noahzhy/cc_glasses/hardware/ir_glasses/ir_glasses_EVT_E7/review/3d/EVT_E7_bottom.png

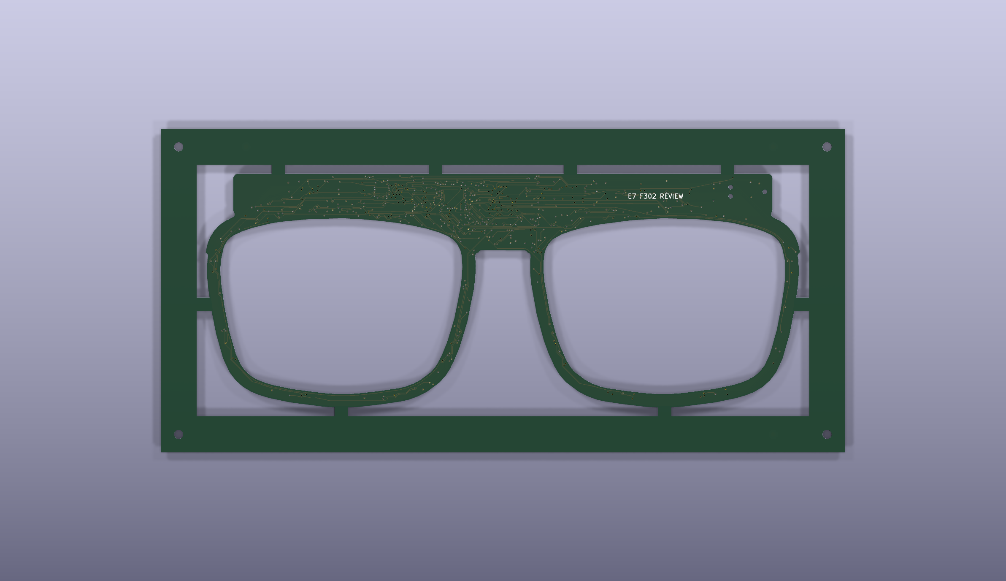
hardware/ir_glasses/ir_glasses_EVT_E7/review/3d/EVT_E7_bottom.png
