noahzhy/cc_glasses/hardware/ir_glasses/EVT_E3/pcb_back.png

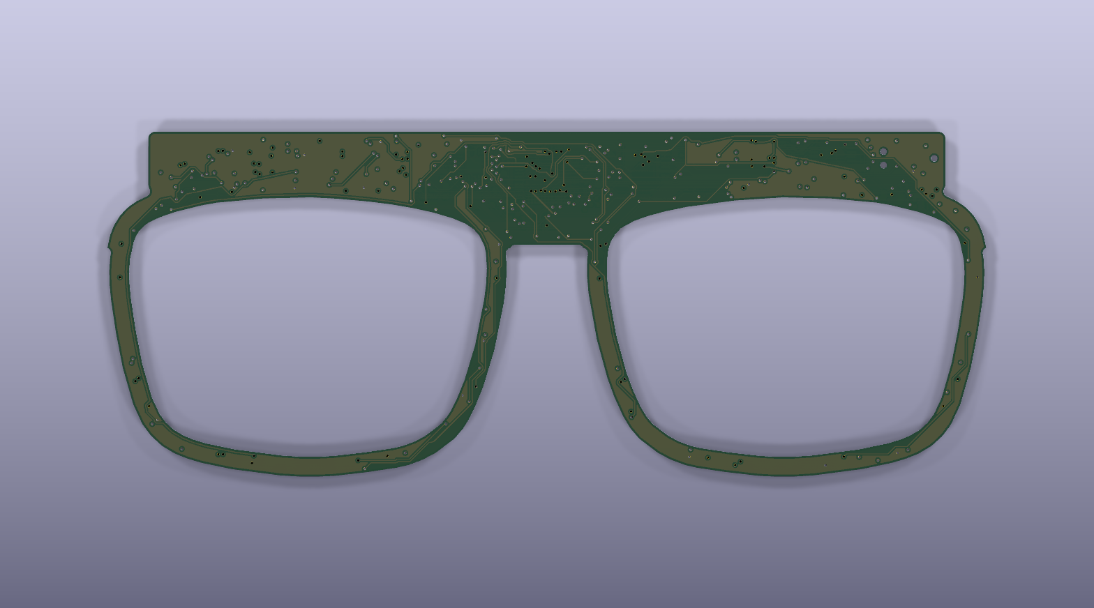
hardware/ir_glasses/EVT_E3/pcb_back.png
