noahzhy/cc_glasses/hardware/ir_glasses/EVT_E3/carrier_design.md

# EVT E3 单板可拆贴片载框

载框用于 5 块 PCB 制作，其中 2 块正面贴片。每个载框只含 1 副眼镜板，元器件及铜箔坐标与裸板相同。此文件是待工厂确认的加工方案，尚未取得工厂 DFM 或专用分板治具报价。

## 尺寸与加工定义

| 项目 | 定义 |
| --- | --- |
| 裸板外包络 | 132.305 × 51.955 mm，以最终裸板 Edge.Cuts 为准 |
| 载框外包络 | 152.305 × 71.955 mm |
| 外框坐标 | X 33.849412～186.154557；Y 47.000000～118.955477 mm |
| 工艺边 | 四周连续 8.0 mm，裸板最大外包络至工艺边内侧至少 2.0 mm |
| 材料 | 四层 FR-4、厚 1.6 mm、沉金，正面贴装 |
| 定位孔 | 四角各 1 个直径 2.0 mm 非金属化孔，中心距相邻外边各 4.0 mm |
| 光学定位点 | 3 个不对称分布的正面 Mark，铜径 1.0 mm、阻焊开窗径 2.0 mm，不开锡膏 |
| 光学点边距 | 中心距最近外边 4.0 mm，满足公开规则的至少 3.85 mm |
| 连接桥 | 8 个实心桥，名义宽 3.0 mm；上沿 4 个、两侧各 1 个、下沿各 1 个 |
| 铣槽 | 闭合 Edge.Cuts 切口；保留连接桥，包含双眼开孔 |
| 最终分板 | 治具支撑后铣断连接桥，按裸板原始轮廓精修；不使用 V-cut 或手工折断 |

采用实心桥是为了让窄镜框在运输和回流焊时得到支撑，并避免邮票孔折断后的毛刺、应力和残留凸起。四条边框夹持位置连续；定位孔、Mark 均位于独立废边，不计入器件 BOM 或贴片数量。默认 5 块均由工厂去框交付，其中 2 块在贴装和检验后去框，另 3 块不贴装。

参考嘉立创[工艺加工能力](https://www.jlc.com/portal/vtechnology.html)及[定位孔、Mark 规则](https://www.jlc.com/portal/server_guide_14565.html)：公开页面给出 SMT 工艺边至少 5 mm、1 mm 光点、2 mm 定位孔，光点中心到板边至少 3.85 mm。本方案采用 8 mm 工艺边及 4 mm 光点边距。

## 连接桥及分板图

`carrier/carrier_review.svg` 中灰色为载框、绿色为成品镜框、橙色为连接桥，红色为贴装后的最终铣断路径。`carrier/carrier_geometry.json` 保存全部绝对毫米坐标。红色路径仅作为加工说明位于 `Dwgs.User`，不混入初次铣槽的 Edge.Cuts。

上方四桥位于 X = 60、95、125、160 mm；两侧桥位于 Y = 84.5～87.5 mm；下方桥位于 X = 72.5～75.5 和 144.5～147.5 mm。桥位需随最终板上铜箔与封装检查结果验收；不得在桥内增加电连接。载框不新增覆铜，原有电路铜箔保持在成品范围内。每条最终铣断路径设有四层覆铜禁布区，向成品内侧保留至少 0.30 mm，防止改用载框外形后重新铺铜延伸到未来切口。禁布区只约束覆铜，原有走线和焊盘保持不动。

工厂需用下支撑治具承托两个镜框和上方电子区，避免吸附或夹持在 PD／IR-LED 上；先完成贴装和检验，再逐桥铣断，最后保留靠近上方电子区的桥作为定位。刀具半径补偿向废料侧进行，最终成品轮廓以裸板文件为准。不得为去桥扩大眼部开孔或削薄 3 mm 镜框。弯曲镜框、手折、斜口钳剪桥均不属于本加工方案。

## 文件对应及交接

- 裸板文件用于最终产品尺寸及对照；`carrier/ir_glasses_carrier.kicad_pcb` 是带载框加工版本，初次生产须选择其对应 Gerber／钻孔，不能混用裸板外形。
- 载框保留原有板坐标、辅助原点、器件位号、旋转角和网络。贴片坐标中应只有同样的 142 个正面器件；额外 4 个定位孔和 3 个 Mark 不进入 BOM/CPL。
- 工厂需确认：异形板治具支撑、铣断顺序、刀具及轮廓公差、沉金与四层叠层，以及 5 块均去框、其中 2 块贴装的加工和报价范围。
- 完成机器 DRC 和坐标一致性校验后可作为报价／DFM 输入；工厂未书面确认前，不将治具可用性或机械强度标为通过。

## 验收状态

以本版 carrier_validation.json、DRC 和 CAM 检查记录为准。工厂 DFM、支撑治具及分板工艺尚待确认。
