noahzhy/cc_glasses/hardware/ir_glasses/deliverables/EVT_E7_生产交付_20260920/交付说明.txt

EVT E7 生产交付文件 — 2026-09-20

PCB/：四层 Gerber、阻焊、丝印、板框、PTH/NPTH 钻孔；直接上传此目录内容生成的 PCB_Gerber.zip 打板，不需要先导入嘉立创 EDA。
SMT/：BOM_JLC.csv 与 CPL_JLC.csv 用于贴片导入；中文 BOM 汇总含参数和立创编码；F_Paste.gtp 为正面钢网。153 个贴装器件，39 种料号，全部正面装配。

层序：F.Cu / In1.Cu(GND) / In2.Cu(3V3) / B.Cu。4 层 FR-4，成品厚度 1.6 mm，外层铜 1 oz。具体内层铜厚及介质厚度由工厂按原工程叠层确认，不指定阻抗控制。
过孔最小钻径 0.20 mm，外径最小 0.40 mm，双面盖油。最小线宽/间距 0.10 mm；铜到板边最小 0.30 mm。不得擅自放大过孔破坏间距。
保留完整 carrier、连接桥、定位孔和槽；以 Edge_Cuts 板框铣槽，不自动添加 V-cut。基板约 132.305×51.955 mm，含 carrier 约 152.305×71.955 mm，以文件轮廓为准。
Gerber、钻孔与贴片坐标采用相同钻孔/贴装原点，单位 mm。CPL 旋转为 KiCad 原生定义，工厂必须结合装配图核对引脚1、二极管/光学器件极性及连接器方向。
J2 为免焊调试触点，测试点和基准点不采购、不贴装。不得未经审核替换物料。

当前源工程 ERC/DRC 为零违规、零未连接、零原理图一致性问题。该结果属于静态检查，不代表首板实测或量产放行。
本包可交工厂进行 DFM 和首板准备；首板测试表仍待完成。阻焊颜色、表面处理、数量及具体工艺由订单另行明确。库存、贴片零度、钢网与加工公差由工厂确认后执行。
源 PCB SHA256：b72c8b3da89e97aaa6524084c4803fd5dfc168ff17fab4a67eadd32514efd5d1
