noahzhy/cc_glasses/hardware/ir_glasses/ir_glasses_EVT_E7/review/report.md

# EVT E7 电路复核与精简记录

E7 沿用 F302 R3 原理图、四层 1.6 mm 基板及既有光学/机械边界。所有电气元器件位于正面。载框属于唯一 PCB 文件，不是另一套电路工程。本文的计算是静态设计检查，不是整板实测结论；布线验收以 `validation.json` 和原生 DRC 为准。

## 保护架构复核

保留 U18 TPS2553DRVR。R29=110 kΩ，按厂商公式并计入 1% 电阻公差，限流下限/典型/上限约为 210.6/242.6/279.6 mA，覆盖原有约 150 mA 工作峰值预算。U14 的最低可设置限流约 0.5 A，不能等效替代 U18。[TPS2553 §9.5](https://www.ti.com/lit/ds/symlink/tps2553.pdf)

保留 U14 TPS259470ARPWR：承担软启动、后级保护及反向电流阻断。R20=6.2 kΩ、C38=22 nF、ITIMER 悬空保持。评估过删除 U19，但 U14 OVLO 上升阈值为 1.183–1.223 V，下降阈值为 1.076–1.116 V；若典型关断设 3.50 V，典型恢复约为 3.18 V，会在输入恢复 3.3 V 后仍保持关断。不能保持原故障恢复行为，因此不删除 U19。[TPS25947 表 6-5、6-6](https://www.ti.com/lit/ds/symlink/tps25947.pdf)

U19 TPS3702CX33DDCR 的 SET 接高、OV 输出驱动 U14 EN。R18/R19=200 Ω/10 kΩ；计入 ±0.9% 检测误差、1% 分压电阻及 SENSE 电流，输入过压关断约为 3.469–3.533 V。正常输入 3.3 V ±3% 的上限为 3.399 V，静态阈值具有间隔。检测器启动时间、输入瞬态过冲和关断过程仍需实测。U18 位于 U14 前面，整机不能宣称具有 U14 单芯片的宽输入耐压能力。[TPS3702 §5、6.3、6.4](https://www.ti.com/lit/ds/symlink/tps3702.pdf)

## 采集、驱动及接口复核

- U1 的 R1=2.67 kΩ，典型通道电流约 19.82 mA；BLANK 上拉保持失控趋向灭灯。U12 的 A=0、B=1，CLR 上升触发、低电平清除；R15 和 C33/C34 的连接符合定时网络。两颗 1 nF 定时电容保留，避免在没有全温度脉宽验证前改变硬件窗口。[TLC59283](https://www.ti.com/lit/ds/symlink/tlc59283.pdf)、[SN74LVC1G123](https://www.ti.com/lit/ds/symlink/sn74lvc1g123.pdf)
- 16 路 TIA 保留 100 kΩ/22 pF 反馈；理想反馈极点约 72.34 kHz。对 5/10 MHz 单极点运放、20–100 pF 总输入电容、反馈电容 ±5% 的敏感度筛查，最慢进入 0.5 LSB 相对稳态误差约 20.72 µs，小于 50 µs 亮态等待。该模型不包含器件高阶极点、实际 PD/走线寄生或饱和恢复，不能代替真实稳定性、噪声和建立时间测试。计算明细见 `circuit_calculations.json`。[TLV906x](https://www.ti.com/lit/ds/symlink/tlv9062.pdf)
- U7/U8 的通道、地址、低有效 EN 与奇偶 TIA 映射重新核对。U16 保持双路单位增益跟随器，反馈在 100 Ω 前取样，330 pF 在 ADC 端；不能把该 RC 当作完整建立时间。[TMUX1308](https://www.ti.com/lit/ds/symlink/tmux1308.pdf)
- U9 的 VDDA/VDD 同接 3V3，保留 C11=10 nF、C47=1 µF。四个数字/备份供电去耦和 C40=10 µF 储能保留。ADC 获取期 5.125 µs、总转换期约 6.167 µs；双 ADC 配置及固件引脚契约不变。[ST DS9911 Rev 9](https://www.st.com/resource/en/datasheet/stm32f302rb.pdf)
- 复核 MCU 48 脚、IMU 供电与 I2C 模式、UART/SWD/NRST 接口、ESD 极性及 LED/PD 引脚。IMU 的 SDx/SCx 接地符合 Mode 1；D18/D19 仍为 1=K、2=A。采购型号、封装及保留器件参数不变。[LSM6DS3TR-C 表 18](https://www.st.com/resource/en/datasheet/lsm6ds3tr-c.pdf)、[PESD3V3U1UB](https://assets.nexperia.com/documents/data-sheet/PESD3V3U1UB.pdf)

## 已实施精简

| 位号 | 原功能 | E7 处理与依据 |
|---|---|---|
| C24 | MCU 区额外 1 µF | 删除；保留各引脚 100 nF、C19=1 µF、C40=10 µF 及独立 VDDA 去耦。最终电源纹波需首板确认。 |
| C45 | MCU 区额外 100 nF | 删除；不替代或删除对应供电脚的 C10/C12/C13/C14。 |
| TP5/TP6 | UART_TX/UART_RX 重复测试点 | 删除；相同网络保留 TP3/TP4，接口与调试能力不变。 |

电气器件 168→164，采购 BOM 器件 155→153。无新增 IC、无器件改值、无保留引脚改网；位号不重新编号。相对于 E6 旧 PCB，U9/9、C11/1、C47/1 的供电整改已同步到 E7 焊盘网络；旧 PCB 网表不作为原理图真值。

## PCB 和验收边界

旧走线、过孔、铜区填充全部清除，按新原理图从零布线。保留机械轮廓、连接桥、定位孔、基准点、32 个光学器件及外部接口的坐标和方向。元器件统一正面，最多四层；In1.Cu 为地参考面，功能走线不延伸到 carrier。

首板仍需验证限流和过压动作、异常输入恢复、上电先后与偏置等待、LED 最大脉宽、CPU 停机灭灯、MUX 满幅切换、ADC 建立/串扰/噪声。`first_board_tests.csv` 保留并补充这些项目。本工程为设计评审交付，不包含生产发布包。

## 当前验收结果：静态设计通过

- 单一工程、单张 A1 原理图、单一含 carrier 的 PCB 已建立。
- 四层、1.6 mm；164 个电气器件全部位于 F.Cu，522 个保留引脚的网络一致；原始轮廓、固定位置和 E6 基线哈希未改变。
- ERC、PCB DRC：均为 0 错误、0 警告；未连接及原理图一致性问题均为 0。`remaining_connections.csv` 和 `warning_review.csv` 仅保留表头；没有豁免或关闭检查。
- 568 个实际过孔均为通孔，孔径至少 0.20 mm、外径至少 0.40 mm、单边环宽至少 0.10 mm。工程及默认孔径限制同步更新，未使用微孔。孔边到 SMD 焊盘的最小距离为 0.103838 mm。
- In1.Cu 以 GND 为参考，局部数字连接避开模拟铜的投影，最小投影铜间隔为 0.304039 mm。填充后的地铜保持一个连通区域；功能走线和过孔均在基板内。
- 已完成 LED_SIN、NRST_EXT 连接，重布邻近 TIA6、TIA8、MUX_B 并补齐 3V3 铜区连接；清理多余线头和无用过孔。此轮收尾未增加器件、未改网、未移动固定器件。
- 六页 PCB 预览包含四个铜层、正面装配层和丝印层，页眉记录当前 PCB 哈希。已检查整板以及模拟、控制、保护区域放大图；详见 `visual_checks.md`。

`validation.json` 为 `passed`，适用范围为静态设计检查。首板测试尚未实施，板厂 DFM 尚未完成，没有发布生产制造包。量产放行仍需完成 `first_board_tests.csv` 中的实测项目，尤其是保护动作、硬件灭灯、模拟稳定性与建立时间、光安全。
