noahzhy/cc_glasses/hardware/ir_glasses/ir_glasses_EVT_E7/review/visual_checks.md

# PCB 视觉复核

检查对象：`pcb_layers.pdf`，以及 `previews/` 中的原生 SVG 和放大图。
PCB SHA256：`b72c8b3da89e97aaa6524084c4803fd5dfc168ff17fab4a67eadd32514efd5d1`。

- 整板：四个铜层、正面装配和丝印预览共六页；载框、连接桥、定位孔及基准点保留，功能走线留在基板内。
- 模拟区：检查运放附近反馈阻容、MUX/ADC 缓冲、去耦和焊盘扇出；放大图为 `analogue_copper.png`、`analogue_assembly.png`。
- 控制区：检查 MCU、LED 驱动和关断逻辑的焊盘、过孔与装配间距；清除悬空线头和无用过孔，修正过孔接线。参见 `control_copper.png`、`control_assembly.png`。
- 回流：检查 In1 整体及控制区放大图。几何检查确认地铜为一个连通区域，In1 数字铜与模拟铜的投影间距至少 0.304039 mm。
- 保护及板边：检查输入保护区、接口、光学边缘和载框分板区域；原生 DRC 的铜到板边检查通过。
- 可读性：装配及丝印页采用黑白高对比导出；位号以矢量 PDF 放大查看。预览页眉记录当前 PCB 哈希。
- 装配位号修正：D17/D18 的位号移出相邻器件区域，D17/D18/D19 使用统一字号的可编辑 F.Fab 位号字段；未改变任何焊盘或电气连接。

视觉及静态检查不替代首板电气实测、光安全测量或板厂 DFM。所有首板测试仍标记为 PENDING。
