noahzhy/cc_glasses/hardware/ir_glasses/ir_glasses_EVT_E7/models/README_E6.md

U16/U17 使用 KiCad 10 官方 VSSOP-8 STEP 模型。U15 使用按 AD7386 CP-16-45 标称尺寸生成的简化外观模型（3×3 mm、0.75 mm 本体、0.5 mm 引脚间距、1.1 mm 裸露焊盘），仅用于装配示意。制造焊盘以 PCB/Gerber 为准。其余模型沿用 E4。

J1采用GUOCONN厂家图纸的简化尺寸模型，壳体和锁扣外观仅作示意；原TE模型已不再绑定J1。
