noahzhy/cc_glasses/hardware/ir_glasses/ir_glasses_EVT_E7/review/preproduction/report.md

# EVT E7 量产前复核 — 2026-09-19

本轮静态检查通过。尚未完成首板实测及工厂 DFM／贴片工程确认，不能据此认定已获量产放行。

## 本轮实际检查

| 项目 | 结果 |
|---|---|
| 原生 KiCad ERC | 0 错误、0 警告，无忽略项 |
| 原生 KiCad DRC、原理图一致性 | 0 违规、0 未连接、0 一致性问题，无忽略项 |
| 重新导出网表 | 与当前受审网表 522 个位号—引脚—网络一致 |
| E6 基线对比 | 保留器件连接无变化，仅移除已记录的 C24、C45、TP5、TP6；历史文件未改变 |
| 单板结构 | 一个带 carrier 的 PCB；4 层、1.6 mm；164 个电气封装均在正面 |
| 过孔 | 568 个通孔，最小孔径 0.20 mm、最小单边环宽 0.10 mm |
| 机械与固定器件 | 轮廓、光学器件、接口、定位孔位置和方向与基线一致 |
| 几何复核 | 地铜一个连通区域；走线未越出基板；孔边到焊盘最小 0.10384 mm；内层数字线与模拟铜投影间距最小 0.30404 mm |
| BOM | 153 个装配器件、39 种采购料号；无重复位号、缺失型号或缺失立创编码 |
| 贴装坐标 | 153 行与 BOM 一一对应；坐标、旋转、正面属性与当前 PCB 原生读取结果一致 |

本轮未改动电路、封装或布线。PCB SHA-256：`b72c8b3da89e97aaa6524084c4803fd5dfc168ff17fab4a67eadd32514efd5d1`。

## BOM 交付与依据

- 工程根目录 `BOM.csv`：逐位号明细，新增简要参数和商品链接，保留型号、制造商、封装、数量及 LCSC 编码。
- 工程根目录 `BOM_采购汇总.csv`：中文列名、同料号合并，包含单板数量、全部位号、简要参数、封装、制造商、型号、立创商城编码和商品链接。
- 电容参数含容量、耐压、介质及公差；电阻含阻值、公差和功率；连接器注明 5P、0.5 mm 间距、上接触和适配 0.3 mm 排线。
- 39 种编码与 2026-09-18 归档的立创商城商品型号逐项相符；相关摘要保存在 `../bom_catalog.json`。这是料号映射依据，不代表当前库存或嘉立创贴片可用性。
- 三环 1 µF 电容的编码及型号另经[立创商品页面](https://item.szlcsc.com/51619650.html)交叉查询；光电二极管简要参数参照[亿光 PD15-21B/TR8 数据手册](https://en.everlight.com/wp-content/plugins/ItemRelationship/product_files/pdf/PD15-21B-TR8.pdf)。本轮未宣称重新逐页审核全部厂商数据手册。
- J2 为 TC2050 免焊调试触点，不是待焊连接器；TP1–TP4、TP7–TP12 共 10 个测试点也不采购。调试探针／转接工具按生产工装另行准备，不计入单板 BOM。
- 汇总数量为每板净用量，不含贴片损耗、最小包装或采购余量。不能用商城编码推断当前基础库／扩展库属性。

原 BOM 保存在 `BOM_before.csv`，检查确认原有位号、数量、型号、制造商、封装和编码均未改变。`result.json` 保存本轮结果和交付文件哈希；`erc.json`、`drc.json` 为本轮重新运行结果。

## 放行前仍需完成

1. `../../first_board_tests.csv` 中 25 项首板测试仍为 PENDING，包括保护动作与恢复、采集稳定性、数字串扰、LED 硬件关断和光辐射安全验证。本轮没有实物测试数据。
2. 工厂确认四层叠层、孔径能力、阻焊与过孔盖油、钢网、器件极性／贴片零度及 carrier 分板 DFM；静态规则通过不能替代工厂确认。
3. 下单时确认 39 种物料的实时库存、批次、供货周期、贴片库可用性及采购余量。不得无审核替换型号。

本轮结果是设计文件和 BOM 的静态复核通过，未下单、未发布新的生产制造包。
