noahzhy/cc_glasses/docs/3D打印参数.md

# 3D 打印参数

## 打印参数
对于 PETG Matte 材料 3D 打印机的打印参数，主要包括以下几个方面：
- 打印速度调整到默认
- 开启 0.12 mm 高质量打印
- 线宽默认设置成 0.6 mm
  - 外墙设置成 0.6 mm
- 关闭[圆弧拟合](https://wiki.bambulab.com/zh/software/bambu-studio/acr-move)
