noahzhy/cc_glasses/docs/IR-LED选型.md

| 型号 | IR26-21C | IR26-61C | IR25-21C | IR11-21C/L491 | IR15-21C |
| --- | --- | --- | --- | --- | --- |
| **出光方式** | Top View，垂直 PCB 出光 | Side View，平行 PCB 出光 | Top View，垂直 PCB 出光 | Top View，垂直 PCB 出光 | Top View，垂直 PCB 出光 |
| **封装特点** | 正面透镜出光 | 侧出光，封装紧凑 | 超薄、宽角度出光 | 中等高度、宽角度透镜 | 超薄、宽角度出光 |
| **典型适用 PCB** | PCB/FPC 朝向眼睛 | PCB/FPC 沿镜框平铺 | PCB/FPC 朝向眼睛 | PCB/FPC 朝向眼睛 | PCB/FPC 朝向眼睛 |
| **光轴调整方式** | 通过倾斜 PCB/FPC 调整 | 通过 PCB 朝向和结构调整 | 对安装角度不敏感 | 可直接覆盖眼区，必要时小角度倾斜 | 对安装角度不敏感 |
| **发光角** | **20°~25°**（取决于具体后缀） | **20°**（L302） | **160°** | **80°**（L491） | **160°** |
| **光强** | 取决于具体后缀，L447 有较高光强版本 | L302 等版本具有较高定向光强 | 单位立体角光强较低，主要靠大范围覆盖 | 中等，兼顾覆盖范围与有效光强 | 相对较低 |
| **空间选择性** | **很高**，适合针对局部区域照射 | **很高**，适合定向照射 | 低，容易同时照亮整个眼区 | **中等，比较均衡** | 低 |
| **安装容错** | 较低，需要光轴基本对准目标 | 较低，需要镜框结构配合 | **很高** | **较高** | **很高** |
| **杂散反射风险** | 低 | 低 | **较高**，容易照到镜片、鼻梁、皮肤 | **中等** | **较高** |
| **主要优势** | 窄束、高空间选择性，适合最终优化 | 小尺寸 + Side View + 定向性强 | 超薄 + 超宽角，容易照到眼睛 | **覆盖范围、方向容错和空间选择性的平衡最好** | 超薄、覆盖范围非常大 |
| **主要限制** | PCB 平铺时可能打不到眼球，需要倾角  | Side View 必须配合特定镜框结构 | 160° 太宽，多通道空间差异容易下降 | 相比 IR26 定向性弱一些 | 光强和空间选择性均不突出 |
| **推荐场景** | LED/PCB 可以精确指向眼球的优化版本  | PCB 沿镜框内壁/侧壁安装、追求隐藏式结构 | Presence / 大范围反射检测 | **初版 near/far 原理验证，推荐** | 简单大范围红外照明，不优先用于当前方案 |
