noahzhy/cc_glasses/hardware/ir_glasses/EVT_E3/mechanical_dimensions.pdf

132.305 mm

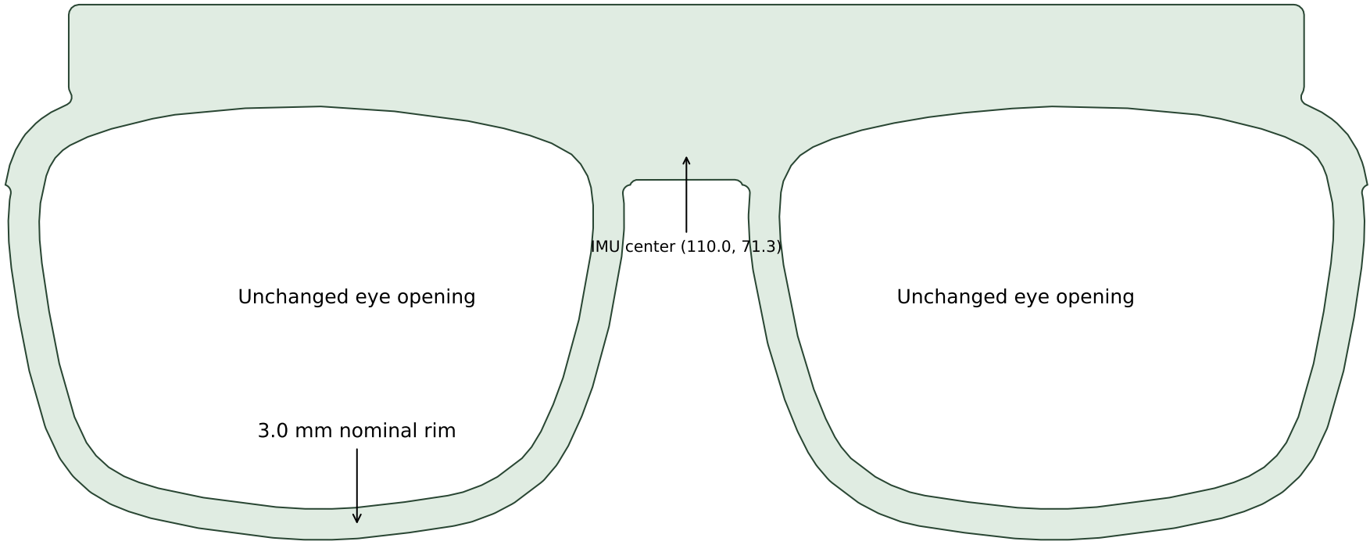
[picture p3: figure]
Unchanged eye opening; 3.0 mm nominal rim; IMU center (110.0, 71.3)

51.955 mm

## EVT E3 | FINISHED BOARD DIMENSIONS | mm | TOP VIEW

4-layer FR-4 / nominal 1.6 mm / ENIG / front assembly only.
Rim: 3.0 mm nominal on sides and lower edges. No routing-driven local widening; upper transitions R0.8 mm.
Straight upper edge: previous 1.5 mm power pocket removed. Dimensions refer to Edge.Cuts centerlines; this PDF is not to scale. Carrier and depanel details: carrier/carrier_review.svg and carrier_design.md. Factory DFM remains pending.
