noahzhy/cc_glasses/hardware/ir_glasses/reviews/EVT_E6_P3_crosscheck_20260917/report.md

# EVT E6 P3 再次交叉检查

日期：2026-09-17。对象：当前工作目录与已发布P3 ZIP。结论：本次未发现新的接线、封装映射、光学坐标或生产包内容不一致问题；典型模型计算可复现。此结论不等于量产放行，现有30项首板测试仍待完成。

## 本次重新执行的验证

- KiCad 10.0.6：重新导出原理图网络表；ERC为0；主板重新铺铜后DRC违规/未连接/原理图不一致均0；载框重新铺铜后DRC违规/未连接均0。未保存或改变生产PCB。
- 新网络表与实际PCB焊盘交叉核对U16/U17双跟随器：1/2为第一级输出反馈，3为MUX输入，4为GND，5为分压输入，6/7为第二级输出反馈，8为3V3_A；R11/R12在反馈环外，分别连接DRIVE_A/B至ADC_A/B；C29/C30分别从ADC_A/B到GND。BOM为TLV9062IDGKR、100Ω、330pF。
- 从Git历史读取E4基线到独立检查目录，确认其PCB SHA256与E6的source_hashes记录相符。实际E4/E6 PCB中16颗LED与16颗PD的位置与旋转逐一相同。
- 重新运行ngspice：相对容差从1e-5加严到1e-6，环路频率网格从120加密至480点/十倍频，瞬态最大步长从2ns缩短到0.5ns，噪声频率网格从150加密至300点/十倍频。100Ω典型相位裕量57.9925°；0.15→3.1V大阶跃上/下沿半LSB建立均约1.1151µs；两级缓冲/分压/RC局部噪声36.4596µV RMS，与发布报告一致。这是数值收敛交叉检查，仍使用同一原厂典型模型，并非独立器件模型或实测。
- 403项发布清单文件哈希全部匹配；完整工程ZIP中的对应文件逐项匹配；完整ZIP、包内载框上传ZIP和SMT交付ZIP均通过CRC检查。
- 查阅AD7386 Rev.A第27–28页：一次转换读回延迟、单线32时钟、A后B的次序与接口文档一致。现有24µs CS低窗口容纳3MHz的32时钟（10.667µs）；背景到亮灯的CS高间隔126µs满足板级5µs调试下限。16×1250µs=20ms，时序预算对应50帧/秒；不表示固件已运行验证。

## 量产前仍未闭环的事项

1. **真实光电链路未验证。** 1.115µs只覆盖缓冲链路；此前25.54µs是理想100kΩ/22pF单极点近似，不能替代真实PD电容、TIA噪声增益、MUX切换和饱和恢复验证。50µs亮灯等待/100µs切换等待继续作为调试基线，按T10/T28/T29实测。
2. **噪声没有系统验收门限。** 36.46µV不是整机噪声上限。约2.29码RMS暗亮差分只是局部链路与ADC典型SNR的粗略合成，未包含真实PD/TIA及LED/电源串扰。算法必须给出允许噪声或最小可检测信号，按T11/T30验收。16位输出不代表16位有效精度或绝对精度。
3. **参考启动、供电及安全时序仍待首板。** 20ms只是参考启动调试起点；主机3.3V±3%为设计条件，实际线缆压降、ADC处供电、热插拔、保护恢复、CPU停机灭灯和连续50帧/秒需完成原有测试清单。

以上均为已存在的验证边界，本次未把它们改写为通过。无需仅依据本次结果继续更换运放或RC。

## 文件位置与交付说明

当前顶层ir_glasses_EVT_E6_JLC_upload.zip不存在，但ir_glasses_EVT_E6/carrier/JLC_upload.zip存在且校验通过；完整工程ZIP内也包含该文件。可使用包内载框上传包，不能沿用旧顶层链接。未重新创建可能由用户整理移除的副本。

当前E4工作目录不存在；本次使用哈希匹配的Git历史基线完成只读对比，未恢复或覆盖用户工作区文件。旧包是否另行备份不在本次已证实范围内。

本报告独立保存，未修改现有生产包、BOM或PCB。具体机器结果见results.json；原始ERC/DRC、导出网络表及加严仿真证据位于工作区.e6_work/p3_crosscheck/。

PCB SHA256：545f4575b7eea053c0235e3fe1aa631ae973b5b51f7525a373fa09242c1da147。

原厂参考：[AD7386 Rev.A](https://www.analog.com/media/en/technical-documentation/data-sheets/ad7386-7387-7388.pdf)、[TI TLV9062](https://www.ti.com/lit/gpn/TLV9062)。
