noahzhy/cc_glasses/assets/blender/topview_outline.png

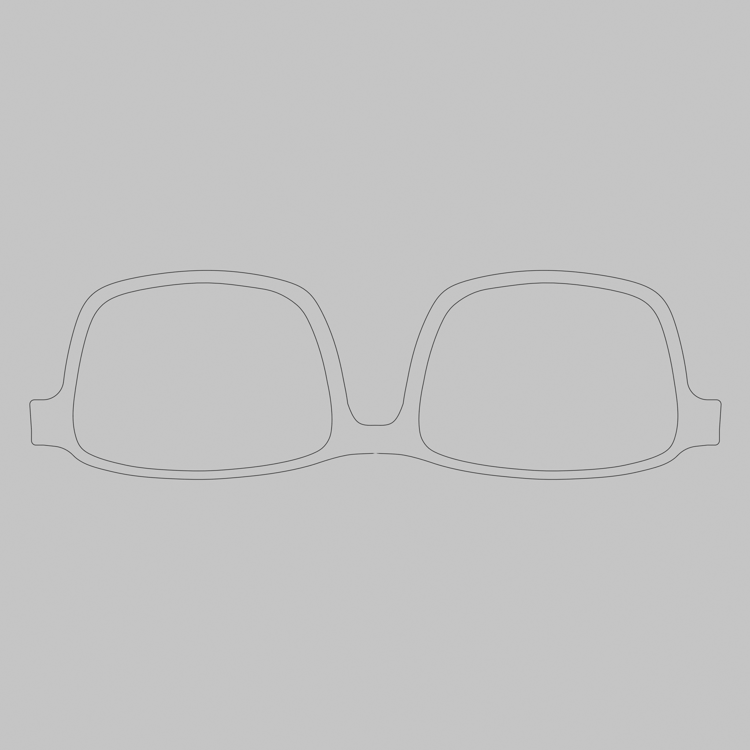
assets/blender/topview_outline.png
