noahzhy/cc_glasses/assets/images/total.png

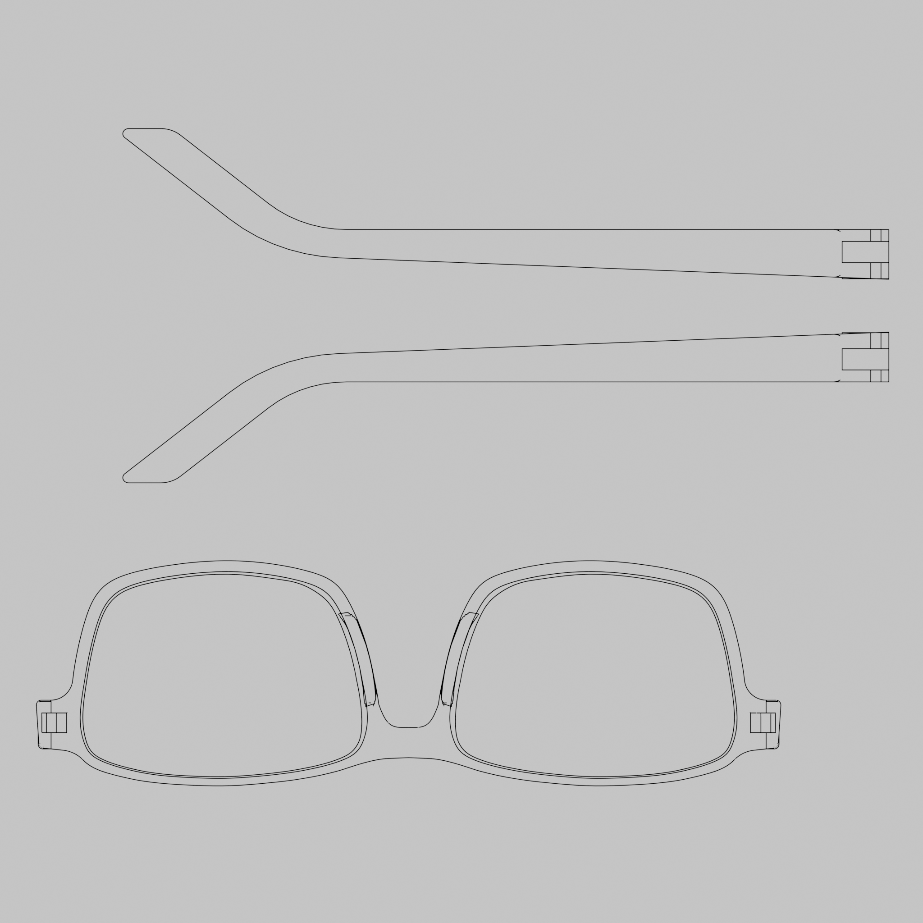
assets/images/total.png
