noahzhy/cc_glasses/hardware/ir_glasses/EVT_E3/carrier/carrier_review.png

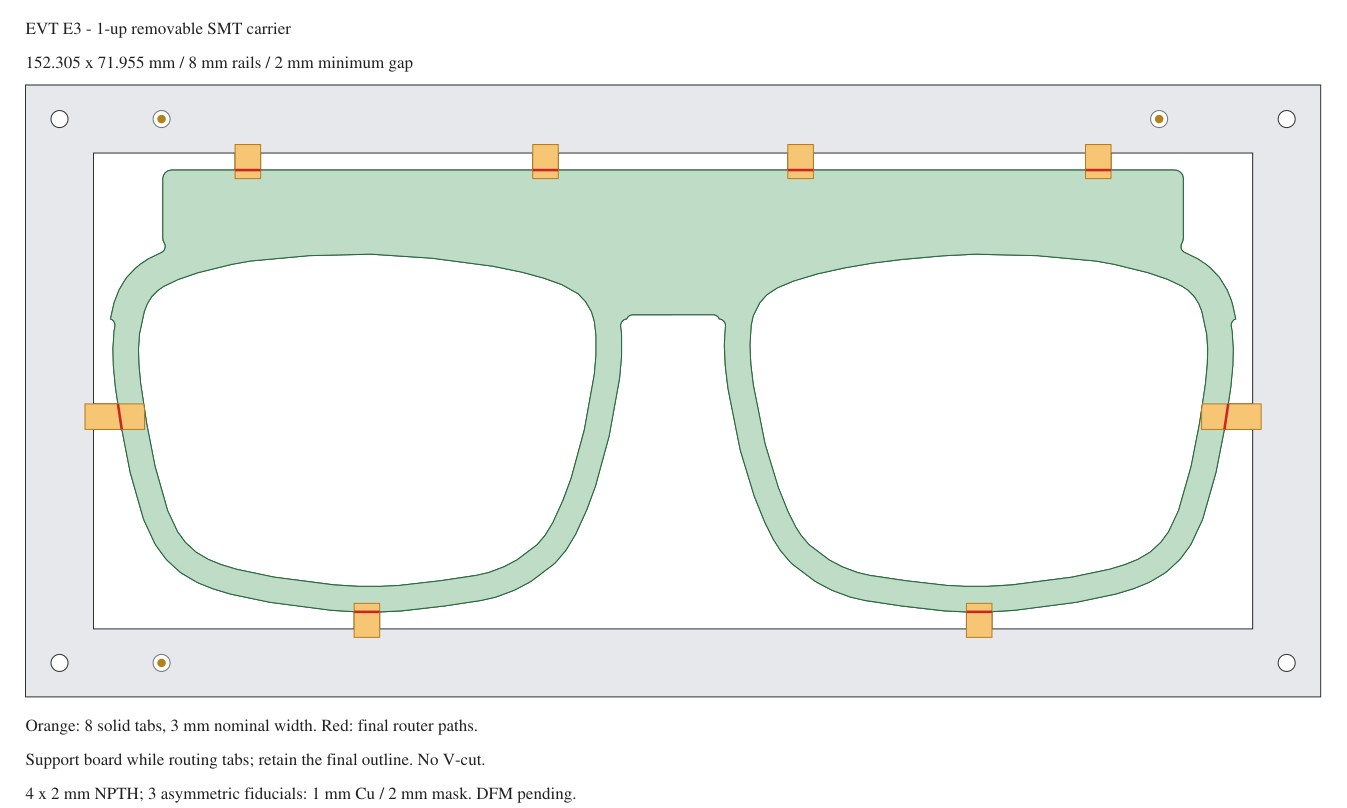
hardware/ir_glasses/EVT_E3/carrier/carrier_review.png
