noahzhy/cc_glasses/hardware/ir_glasses/EVT_E3/pcb_routed.png

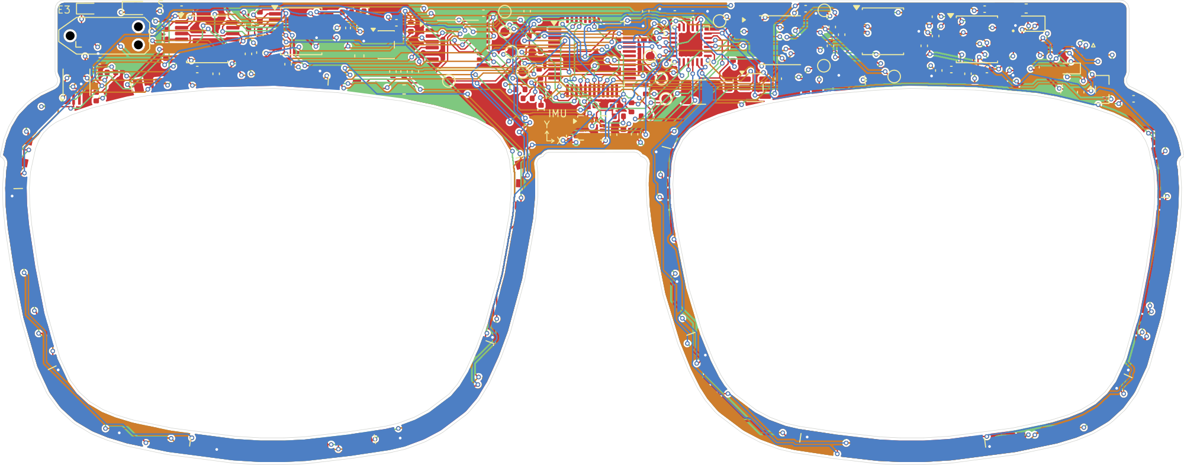
hardware/ir_glasses/EVT_E3/pcb_routed.png
