noahzhy/cc_glasses/hardware/ir_glasses/ir_glasses_EVT_E7/review/3d/EVT_E7_angle.png

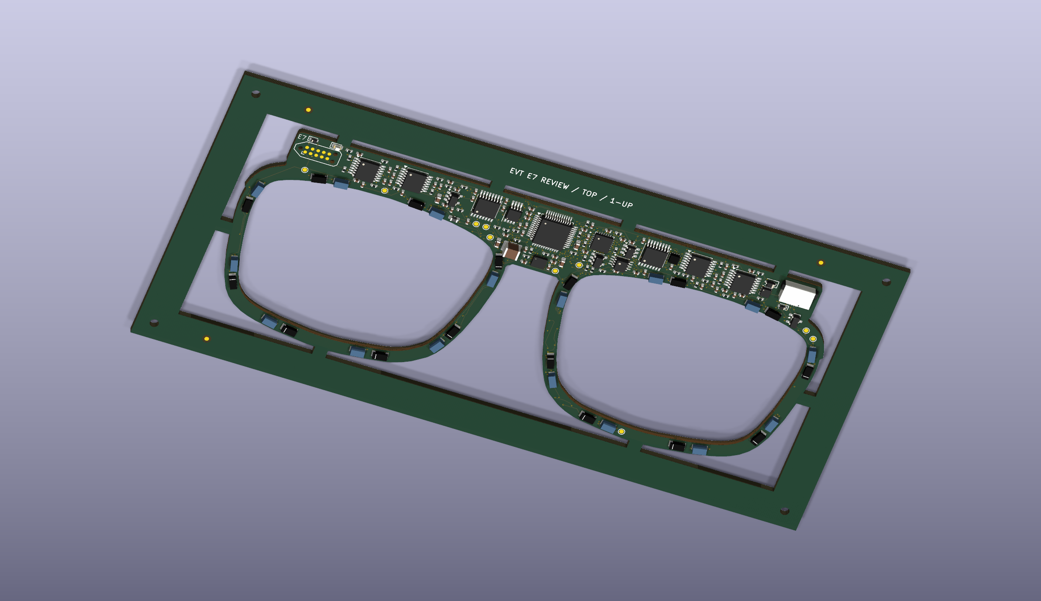
hardware/ir_glasses/ir_glasses_EVT_E7/review/3d/EVT_E7_angle.png
