noahzhy/cc_glasses/hardware/ir_glasses/ir_glasses_EVT_E7/review/previews/analogue_ground.png

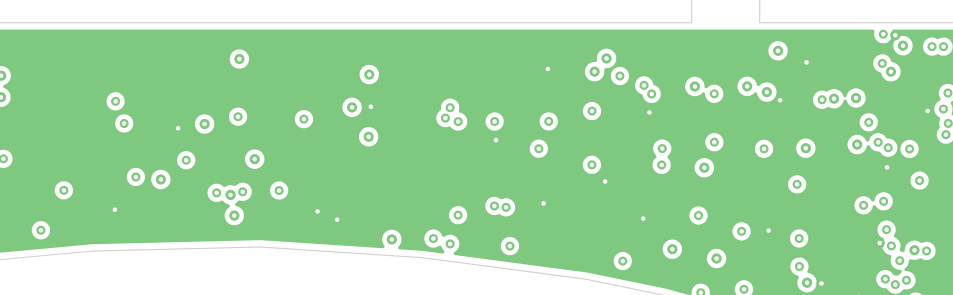
hardware/ir_glasses/ir_glasses_EVT_E7/review/previews/analogue_ground.png
