noahzhy/cc_glasses/hardware/ir_glasses/ir_glasses_EVT_E7/review/previews/ir_glasses_EVT_E7-F_Cu.png

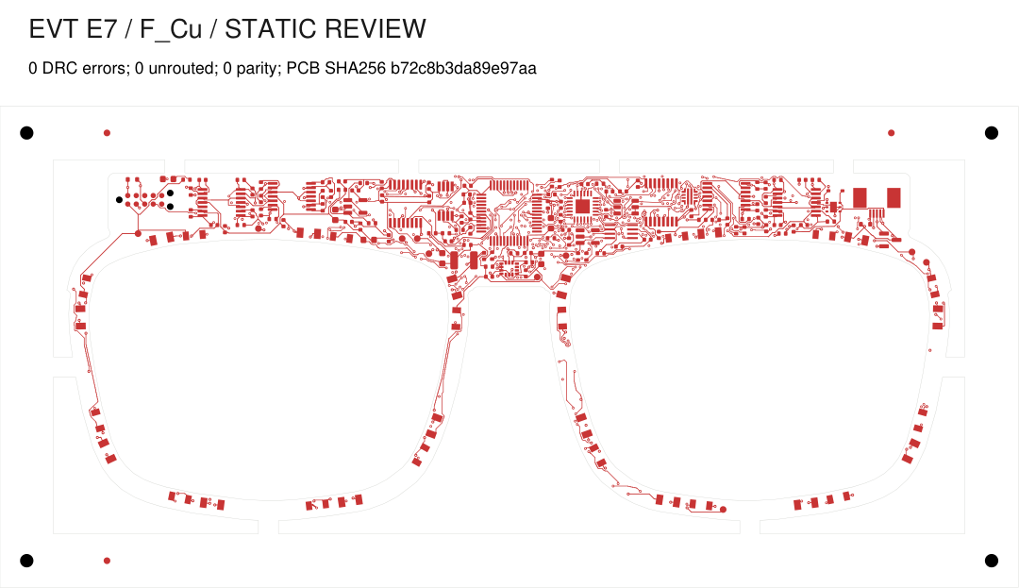
hardware/ir_glasses/ir_glasses_EVT_E7/review/previews/ir_glasses_EVT_E7-F_Cu.png
