noahzhy/cc_glasses/hardware/ir_glasses/ir_glasses_EVT_E7/review/previews/protection_copper.png

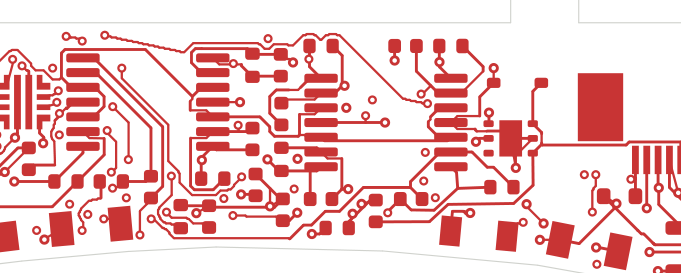
hardware/ir_glasses/ir_glasses_EVT_E7/review/previews/protection_copper.png
