noahzhy/cc_glasses/hardware/ir_glasses/ir_glasses_EVT_E7/review/schematic.png

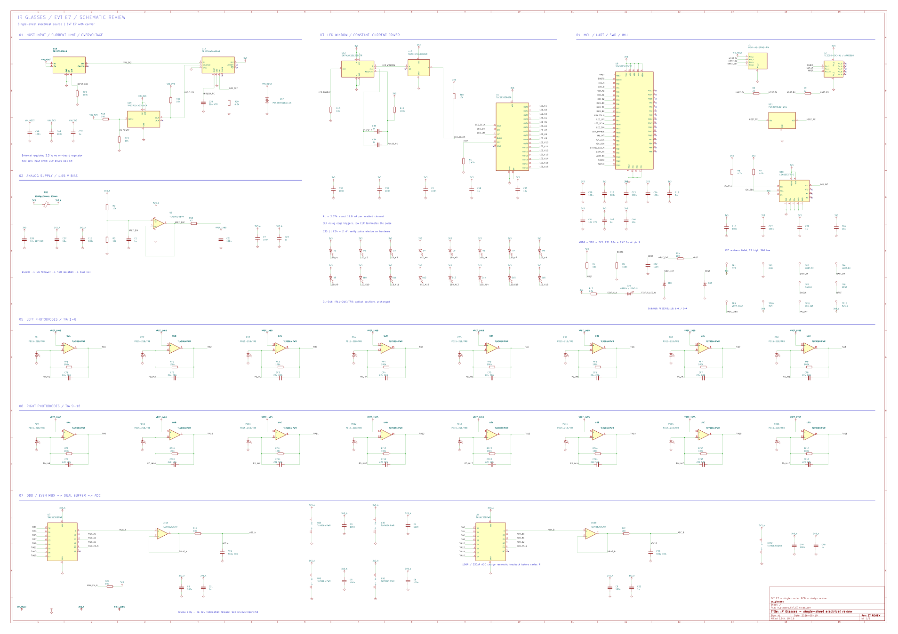
hardware/ir_glasses/ir_glasses_EVT_E7/review/schematic.png
