noahzhy/cc_glasses/hardware/tools/final_sch_0.png

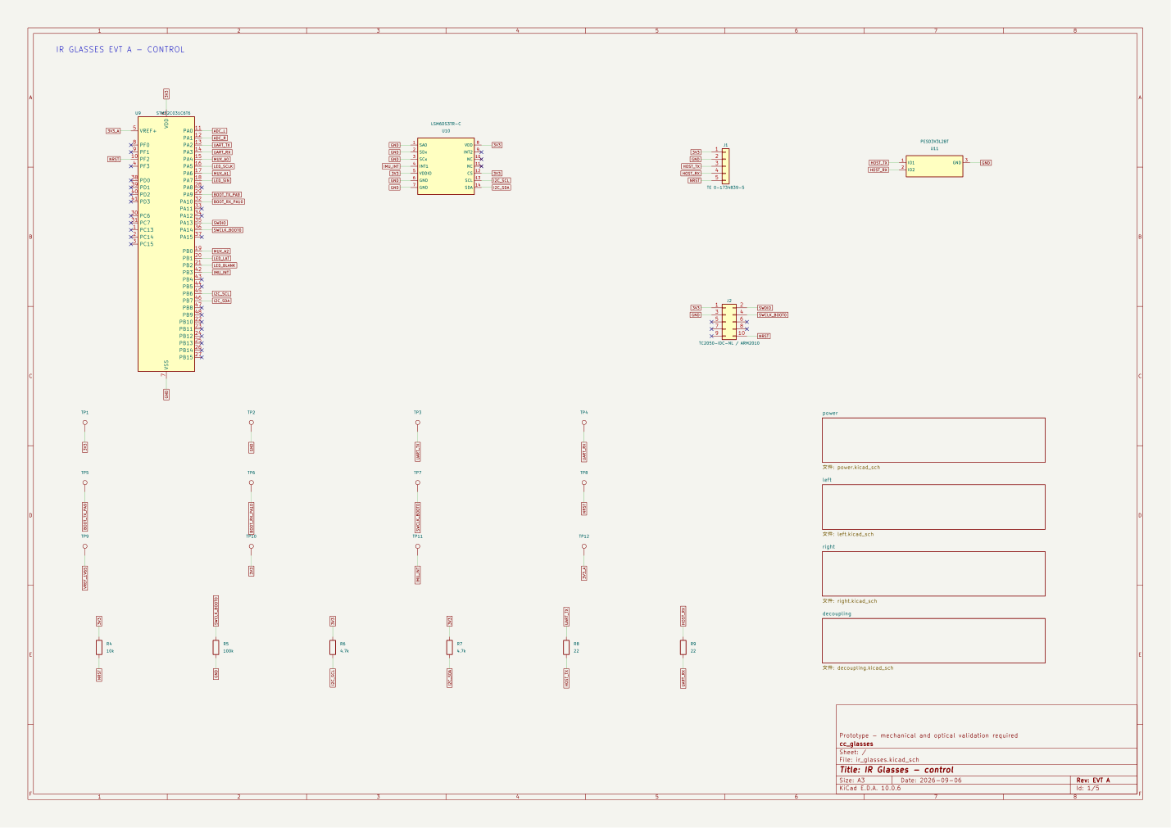
hardware/tools/final_sch_0.png
