noahzhy/cc_glasses/hardware/tools/final_sch_1.png

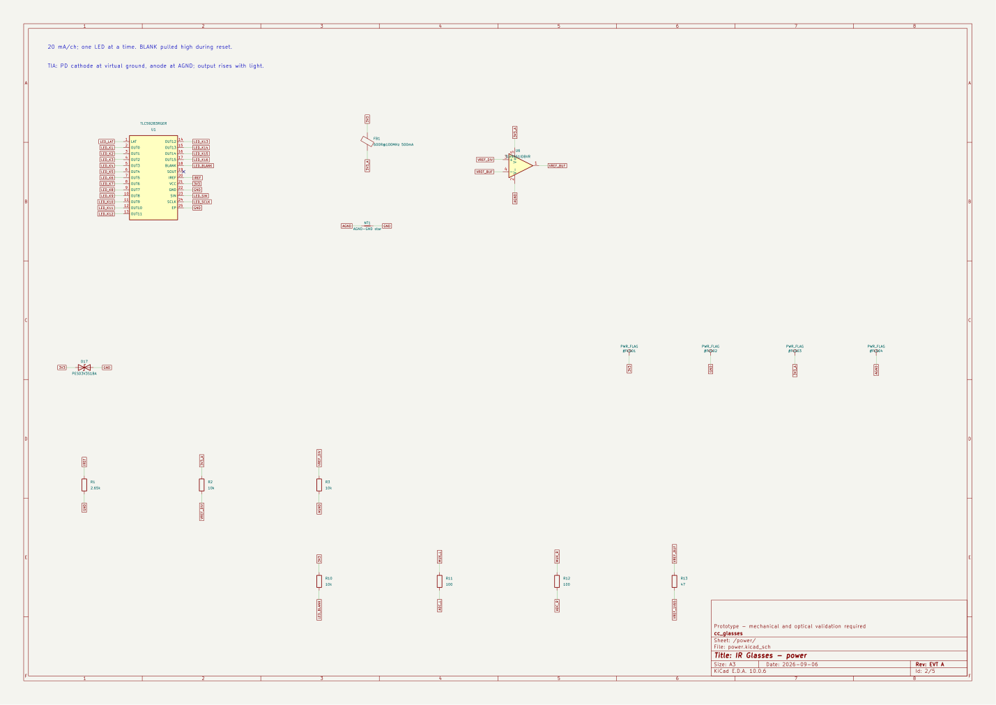
hardware/tools/final_sch_1.png
