noahzhy/cc_glasses/hardware/tools/final_sch_2.png

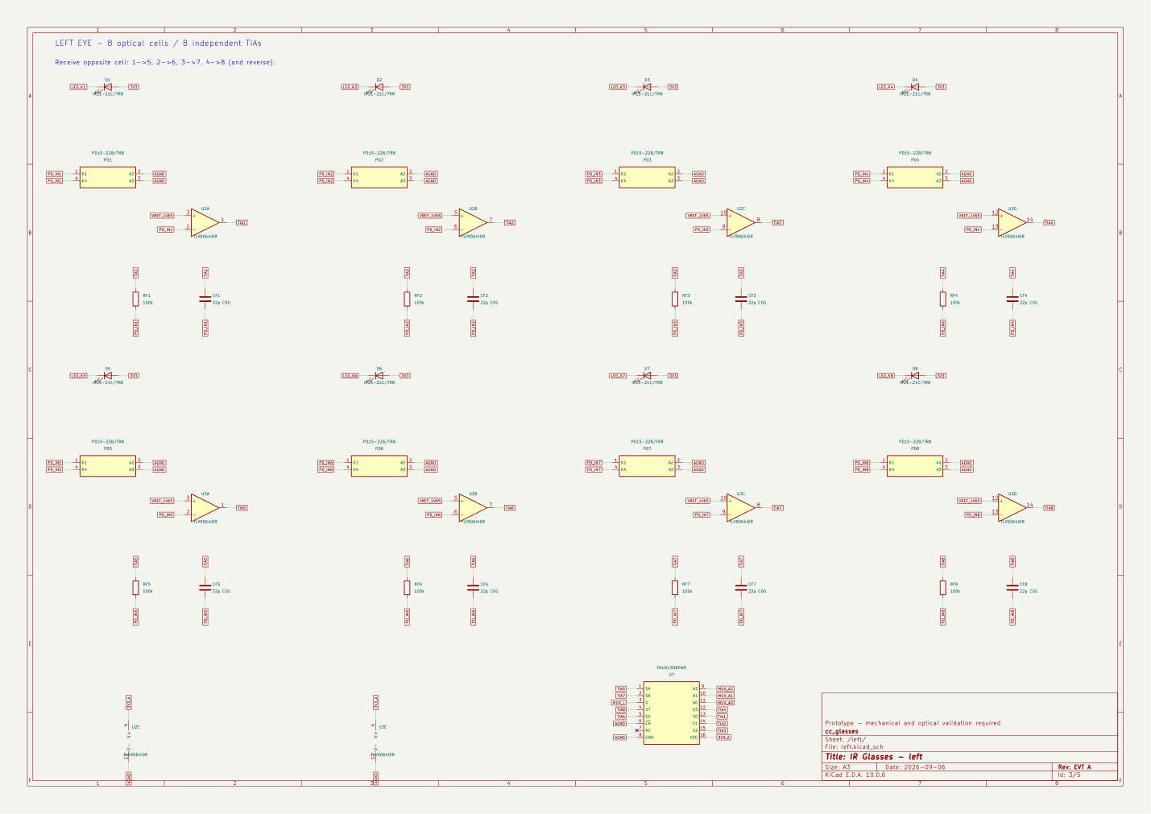
hardware/tools/final_sch_2.png
