noahzhy/cc_glasses/hardware/tools/final_sch_4.png

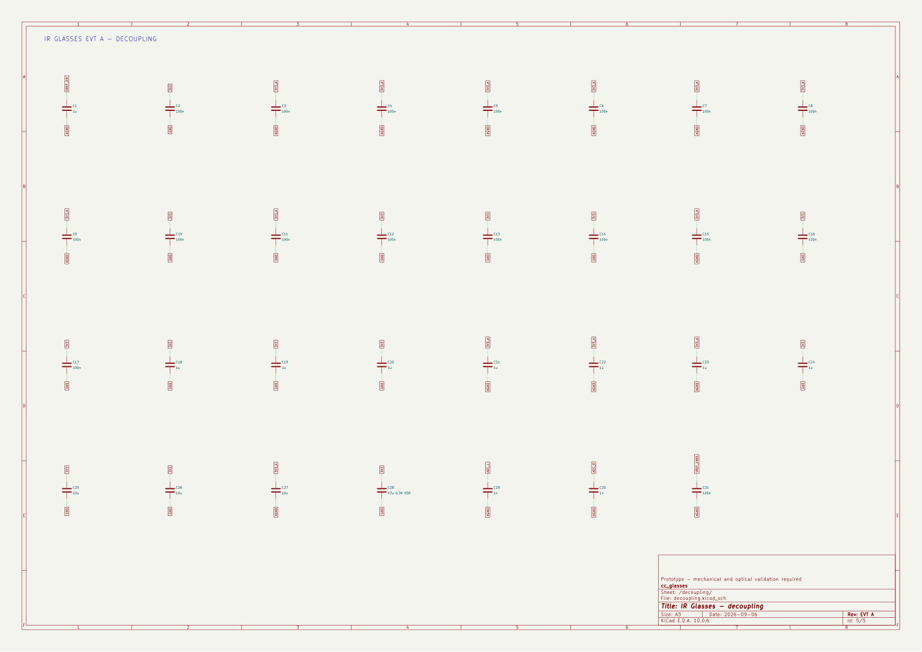
hardware/tools/final_sch_4.png
