noahzhy/cc_glasses/hardware/tools/imu_axes.png

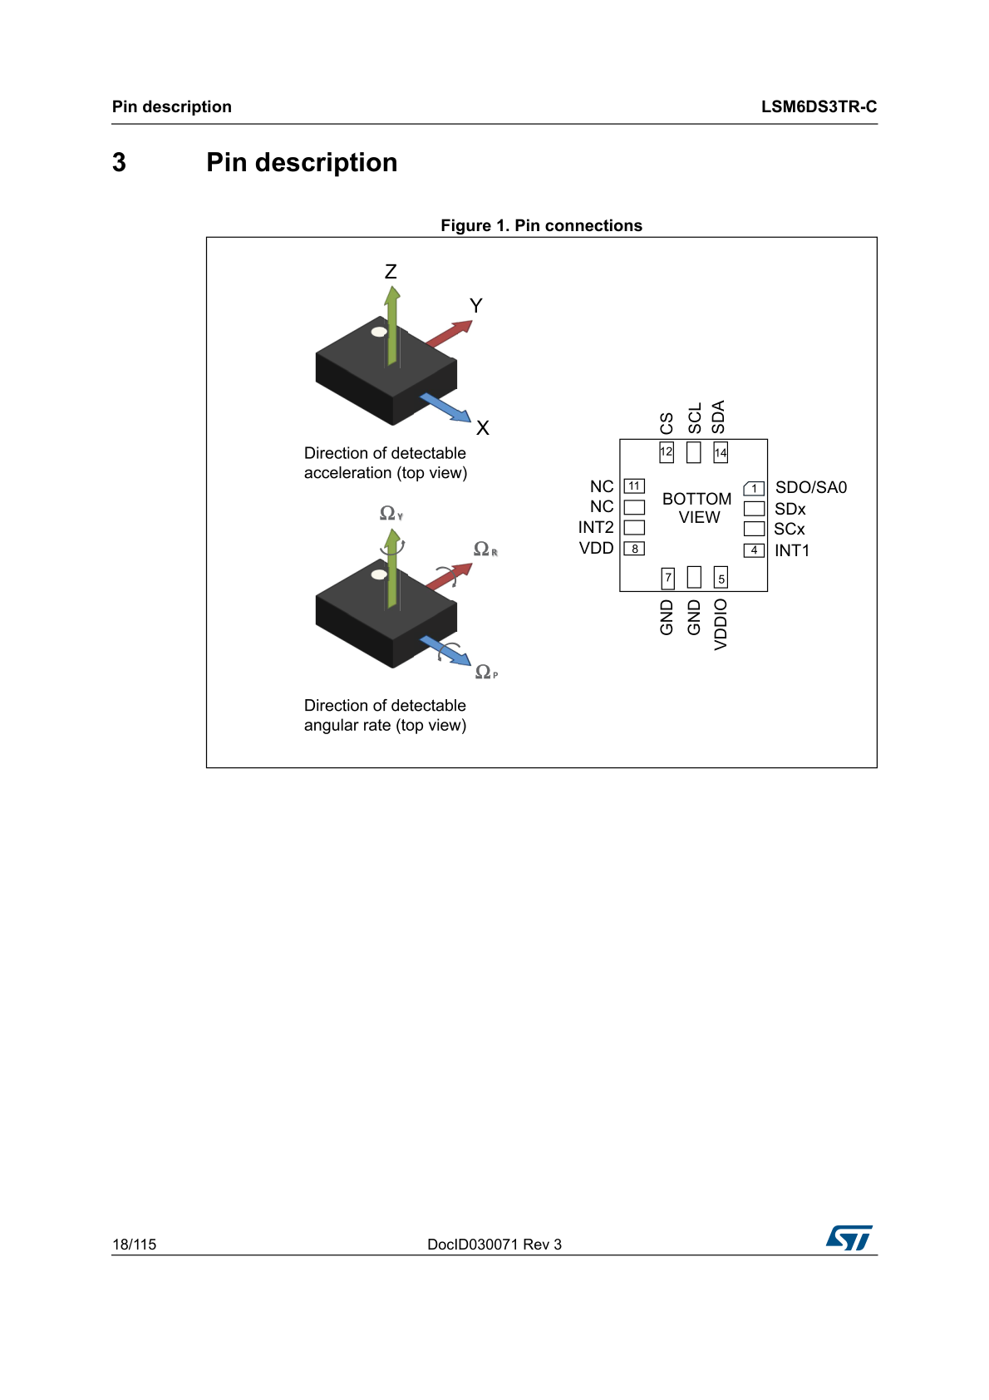
hardware/tools/imu_axes.png
