noahzhy/cc_glasses/hardware/tools/ir.png

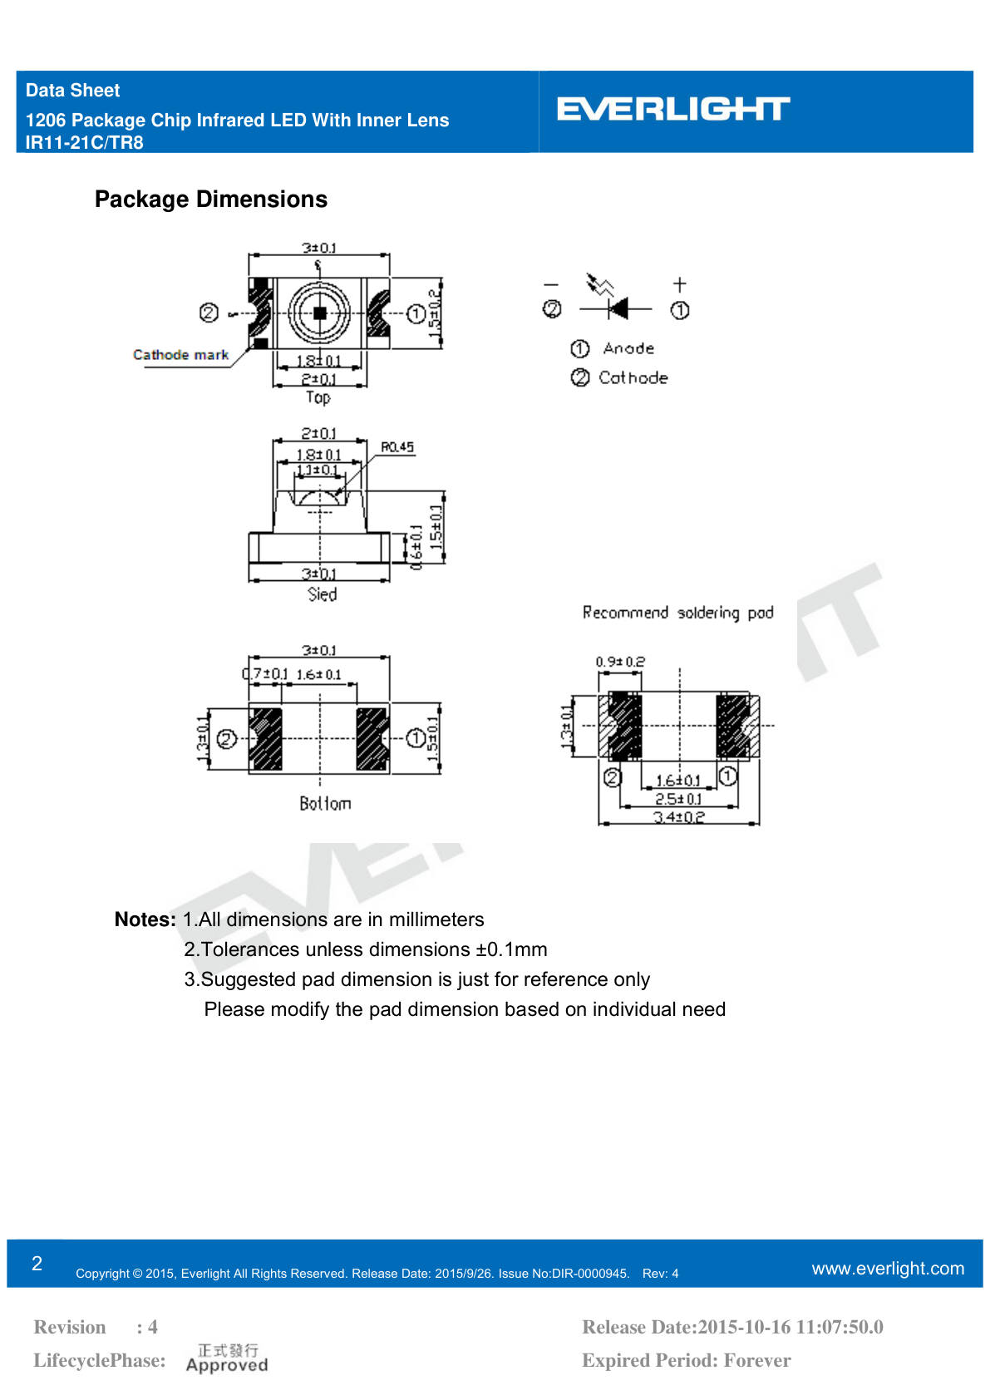
hardware/tools/ir.png
