noahzhy/cc_glasses/hardware/tools/pd.png

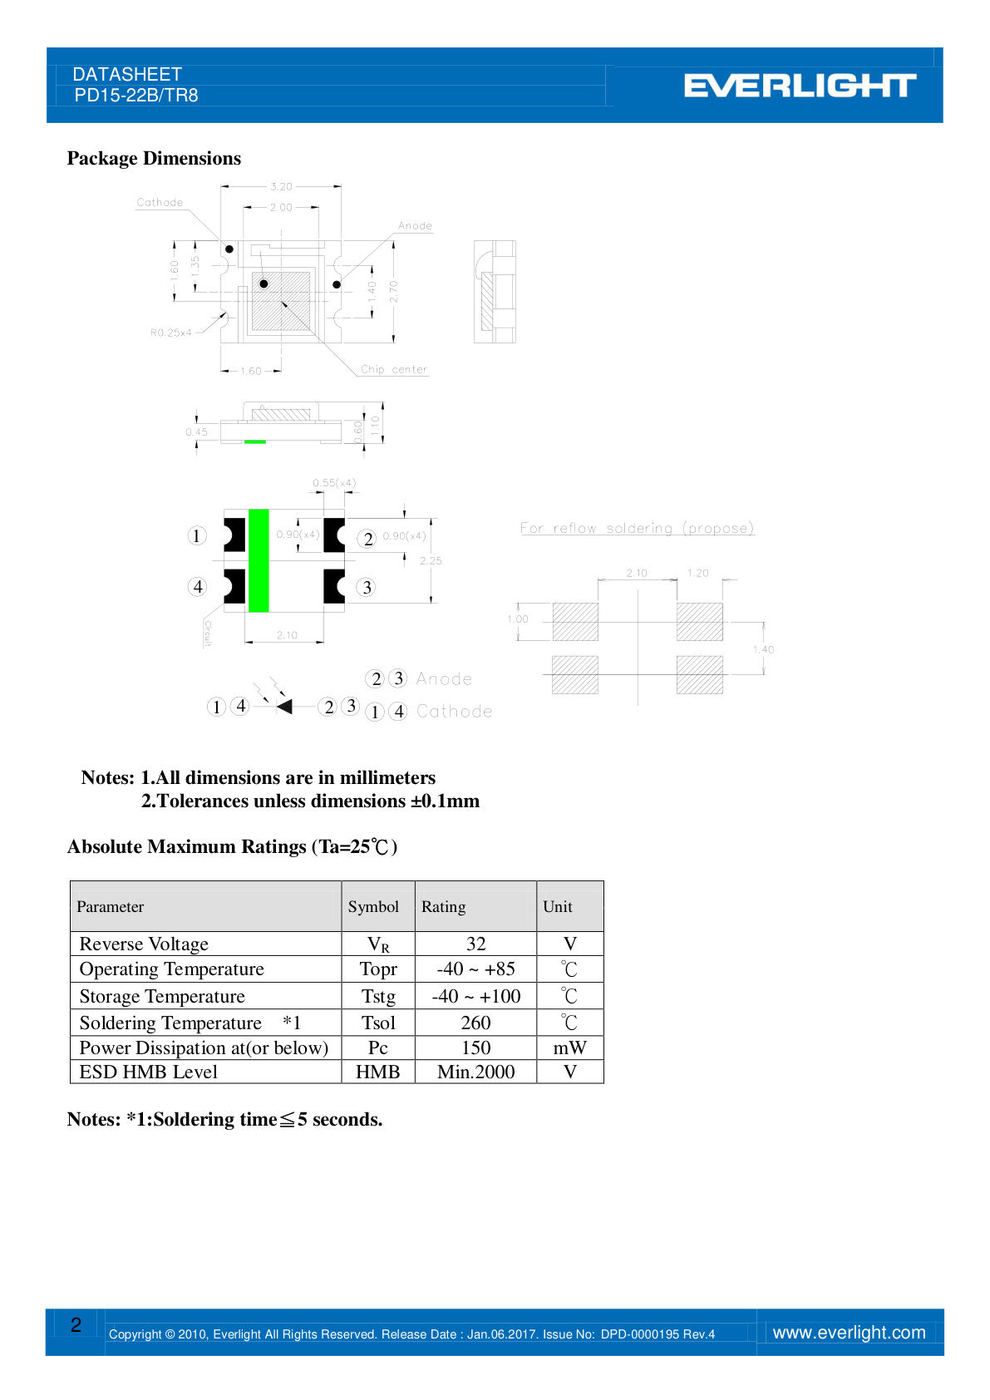
hardware/tools/pd.png
