noahzhy/cc_glasses/hardware/tools/placement.png

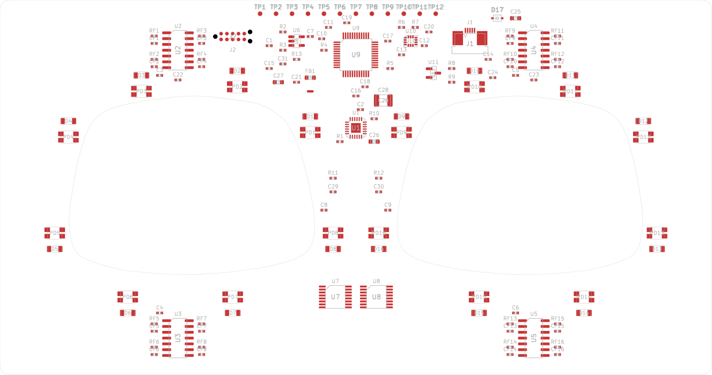
hardware/tools/placement.png
