noahzhy/cc_glasses/hardware/tools/tia_crop.png

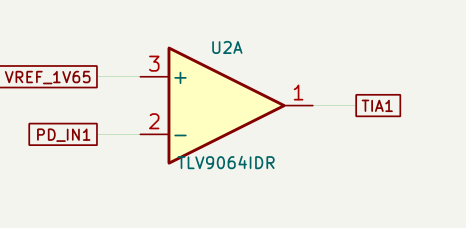
hardware/tools/tia_crop.png
