noahzhy/cc_glasses/docs/smart_glasses_ir_sensor_bom.md

# 智能眼镜红外近远视感知模块——EVT E4 工程 BOM

当前工程版本为四层、1.6 mm、沉金、单面贴装 EVT E4；共 **142 个贴装位号、33 类物料**。计划 5 块裸板、其中 2 块同配置贴片。国内实时可贴库存、平台损耗及工厂 DFM 待确认，库存未预占。完整型号与数量以 [E4 采购主表](../hardware/ir_glasses/ir_glasses_EVT_E4/material_freeze/bom.xlsx) 为准；[E3 历史文件](../hardware/ir_glasses/EVT_E3/README.md) 保留。

E4 于 2026-09-09 完成复核和制造文件重导出；电路和布局沿用 E3，板上版本标记改为 E4。

E3 新增绿色状态灯、复位滤波与 ESD、IR 脉冲限时、正向输入过压关断及限流。**板端供电为 3.20–3.40 V；PB2 改为高有效 LED_ENABLE，旧 E2 固件不能直接使用。** PA8 低有效驱动状态灯，光学采样时熄灭。电源区已重新排紧并取消原 1.5 mm 凸起；双眼开孔、中央 IMU 和侧边/下沿保持不变。

## E3 新增物料

| 位号 | 型号 / 规格 | 单板数量 | 用途 |
|---|---|---:|---|
| D20 | Lite-On LTST-C190KGKT / C125094，绿色 0603 | 1 | 开机 / 运行 / 故障状态，需固件驱动 |
| R17 | 4.7 kΩ，0402 / C25900 | 1 | 状态灯限流 |
| D18、D19 | Nexperia PESD3V3U1UB,115 / C2443469，SOD523 | 2 | J1 / J2 复位信号 ESD |
| R14 | 100 Ω，0402 / C25076 | 1 | J1 复位信号串联隔离 |
| C32、C35、C36 | 100 nF，0402 | 3 | 复位滤波、逻辑芯片去耦 |
| U12 | TI SN74LVC1G123DCTR / C123302，SSOP8 | 1 | 限制单次 IR 发光窗口 |
| U13 | TI SN74LVC1G04DBVR / C7827，SOT23-5 | 1 | 反相驱动 LED BLANK |
| R15 | 100 kΩ，0402 / C25741 | 1 | 单稳态定时 |
| R16 | 10 kΩ，0402 / C25744 | 1 | LED_ENABLE 默认下拉 |
| C33、C34、C38 | 1 nF C0G，0402 / C53547 | 3 | 两颗并联定时；一颗设置软启动 |
| U14 | TI TPS259470LRPWR / C3662793，RPW0010A | 1 | 正向过压关断、故障限流和软启动 |
| R18 | Yageo RT0402BRD0719K1L / C852587，19.1 kΩ、0.1% | 1 | OVLO 上臂 |
| R19 | Yageo RT0402BRD0710KL / C190095，10 kΩ、0.1% | 1 | OVLO 下臂 |
| R20 | UNI-ROYAL 0402WGF6201TCE / C25915，6.2 kΩ | 1 | 输入限流设定 |
| C37 | CCTC TCC0402X7R105K160AT / C49210445，1 µF、16 V | 1 | 保护芯片输入去耦 |

新增 20 个器件；原有 C25 移近 U14 输出，C29/C30 接 MCU GND。最终 E3 将 AGND 合并到共同 GND，移除 NT1 铜桥；模拟电源仍经 FB1 滤波。下表介绍沿用电路，文末旧版本记录仅供追溯。

## 设计前提

- 采用一块**一体化刚性 PCB**，不拆分为眼部传感板与中央处理板；以室内功能验证为目标；当前 PCB 按正向镜框、LED/PD 并排和紧凑布局实施，尚未完成佩戴定版。
- 左右眼各配置 8 颗 IR-LED 和 8 颗感光 PD，共 **16 颗 IR-LED + 16 颗 PD**。
- 每只眼采用 **8 个紧凑光学单元**：每个单元恰好包含 1 颗 IR-LED + 1 颗 PD；同单元器件机械上相邻布置，但近/远视主光路只在对侧或斜对侧单元之间建立。
- IR-LED 使用 Everlight **IR11-21C/TR8**（940 nm、正面/垂直 PCB 出光、100° 发光角）；PD 选用 Everlight **PD15-21B/TR8**（940 nm 峰值响应、3.2 × 1.5 × 1.1 mm、两脚）。
- 由眼镜主机提供稳压 **3.3 V（板端 3.20–3.40 V）**；模块不包含电池、充电管理、BLE 或天线。
- 模块在板端完成时分采样、IMU 运动补偿和近/远视分类，通过 **3.3 V TTL UART** 向主机输出状态、置信度和诊断数据。

## 推荐采购 BOM（单个模块）

| 位号 | 功能 | 推荐型号 / 规格 | 数量 | 说明 |
|---|---|---|---:|---|
| D1–D16 | 红外发射器 | Everlight **IR11-21C/TR8** | 16 | 每只眼 8 颗；940 nm、1206（3.0 × 1.5 × 1.5 mm）、正面出光、100° 发光角。原型阶段按逐颗 20 mA 脉冲驱动。 |
| PD1–PD16 | 感光二极管 | Everlight **PD15-21B/TR8 / C2921391** | 16 | 每只眼 8 颗；940 nm 峰值响应；专用两焊盘封装，1 脚 A 接 GND、2 脚 K 接 PD_IN。近/远视主通道仅接收预标定的**对侧或斜对侧** LED 反射，不能采用邻近 LED–PD 配对。 |
| U1 | 16 路恒流 LED 下拉驱动 | TI **TLC59283RGER** | 1 | 3.0–5.5 V 供电；在 3.3 V 下每路最高 35 mA。16 路 LED 均可独立控制。 |
| R1 | LED 驱动电流设定电阻 | **2.67 kΩ，1%，0402，ARG02FTC2671** | 1 | TLC59283 在 3.3 V 下设为约 **19.85 mA/路** 的标称值；预留 3.53 kΩ（15 mA）和 2.12 kΩ（25 mA）替换位。 |
| U2–U5 | 四路跨阻放大器 | TI **TLV9064IPWR**（四运放、RRIO，TSSOP-14 / PW，0.65 mm 间距） | 4 | 每个 PD 对应一路跨阻放大，共 16 路；要求低输入偏置电流并支持单 3.3 V 供电。 |
| RF1–RF16 | 跨阻反馈电阻 | **100 kΩ，1%，0402** | 16 | 针对 PD µA 级响应的保守初始增益；EVT 阶段预留 220 kΩ / 470 kΩ 替换值。 |
| CF1–CF16 | 跨阻补偿电容 | **22 pF，C0G/NP0，0402** | 16 | 用于每路 TIA 稳定；需结合 PD、布线寄生和实测响应定版。 |
| U6 | 虚拟地缓冲 | TI **TLV9061IDBVR** | 1 | 缓冲 1.65 V 模拟参考电压，供所有 TIA 使用。 |
| R2、R3 | 中点电压分压器 | 10 kΩ，1%，0402 | 2 | 生成 1.65 V 虚拟参考输入。 |
| C1 | 虚拟参考滤波电容 | 1 µF，X7R，0402 | 1 | 紧靠 U6 输入放置。 |
| U7、U8 | 8:1 模拟多路复用器 | TI **TMUX1308PWR** | 2 | 每只眼 1 颗：将 8 路缓冲后的 PD 信号复用到 MCU 的 2 路 ADC；每次仅选择与当前 LED 形成对向/斜对向反射光路的目标 PD。 |
| U9 | MCU / 采集控制 / ADC / UART | ST **STM32C031C6T6** | 1 | Cortex-M0+，32 KB Flash、12 KB RAM、48 MHz、12-bit 2.5 MSps ADC、2×USART、I²C；负责 LED 扫描、PD 采样、IMU 补偿、基础滤波/特征计算和 UART 通信，不运行任何神经网络。提供 SWD 焊盘用于烧录调试。 |
| U10 | 六轴 IMU | ST **LSM6DS3TR-C** | 1 | 三轴加速度计 + 三轴陀螺仪；LGA-14（2.5 × 3 × 0.86 mm），支持 I²C/SPI，板内优先使用 I²C；高性能组合模式典型电流约 0.90 mA。 |
| J1 | 主机连接器 | TE **2492111-5**，5 Pin、0.5 mm、上接触、0.3 mm FFC/FPC | 1 | 引脚：VIN_3V3、GND、UART-TX、UART-RX、NRST_EXT；采用 EVT E1 的新卧式封装和 TE STEP 模型。 |
| J2 | SWD 烧录 / 调试接口 | **Tag-Connect TC2050-IDC-NL** 10 Pin 无连接器焊盘 | 1 | 板上仅放焊盘、不焊连接器；配合外置 Tag-Connect 线缆和 ST-Link 使用。含 SWDIO、SWCLK、NRST、3V3、GND，支持稳定的反复烧录和在线调试。 |
| U11 | UART ESD 防护 | Nexperia **PESD3V3L2BT,215**，SOT-23 | 1 | 保护 J1 上的 UART-TX/RX。 |
| D17 | 3.3 V 输入 ESD 防护 | Nexperia **PESD5V0S1BA,115**，SOD-323 | 1 | 放在电源入口；配合 U14 正向过压关断；本版未验证反接耐受。 |
| FB1 | 模拟电源隔离 | Murata **BLM18AG601SN1D**，600 Ω @100 MHz、500 mA、0603 | 1 | 为 TIA 和基准提供独立的低噪声模拟 3.3 V 电源域。 |
| C2–C17 | IC 本地去耦 | 100 nF，X7R，0402 | 16 | 每个 IC 电源脚组至少 1 颗，紧贴电源脚放置。 |
| C18–C24 | 局部储能去耦 | 1 µF，X7R，0402 | 7 | 分布在 LED 驱动、MCU、IMU、模拟电源域和连接器附近。 |
| C25–C27 | 输入 / LED 储能电容 | 10 µF，X5R/X7R，0603 | 3 | 分别放在 U14 输出、U1 和模拟电源域附近。 |
| C28 | LED 脉冲储能电容 | YAGEO **CC1210KKX5R7BB476**，47 µF、16 V、X5R、±10%、1210 | 1 | 靠近 U1；采购时核对 3.3 V 偏压下的有效电容。 |
| R4 | NRST 上拉电阻 | 10 kΩ，1%，0402 | 1 | MCU 硬件复位默认上拉；NRST 同时接入 J2。 |
| R5 | BOOT0 下拉电阻 | 100 kΩ，1%，0402 | 1 | 弱下拉 PA14/SWCLK/BOOT0；启动模式还由 option bytes 决定。不能假定出厂设置下拉高测试点即可进入系统 Bootloader。 |
| R6、R7 | I²C 上拉电阻 | 4.7 kΩ，1%，0402 | 2 | LSM6DS3TR-C 的 SDA/SCL 上拉至 3.3 V。 |
| R8、R9 | UART 串联电阻 | 22 Ω，0402 | 2 | 缓和连接器处的边沿和 EMI；分别串在 UART-TX/RX。 |
| R10 | LED 关闭默认上拉 | 10 kΩ，0402 | 1 | 将 BLANK 上拉，MCU 复位时关闭 LED 输出。 |
| R11、R12 | ADC 输入隔离 | 100 Ω，0402 | 2 | 隔离左右 ADC 的采样瞬态。 |
| C29、C30 | ADC 输入滤波 | 1 nF，0402 | 2 | 与 R11、R12 配合，连接到 MCU GND。 |
| R13 | 基准输出隔离 | 47 Ω，0402 | 1 | 位于 U6 输出与 VREF_1V65 之间。 |
| C31 | 基准输出去耦 | 100 nF，0402 | 1 | VREF_1V65 对 GND；U6 反馈取自隔离电阻前。 |
| TP1–TP12 | 测试点 | 1.0 mm 焊盘或 Pogo Pad | 12 | 3V3、GND、运行 UART-TX/RX、系统 Bootloader UART（PA9/PA10）、BOOT0、NRST、模拟参考、LED 电源、IMU 中断。SWD 信号优先通过 J2 使用。 |
| PCB1 | 一体化电路基板 | **4 层刚性 FR-4 PCB，单面贴装**，1.6 mm，沉金 | 1 | E3 保留双眼开孔和中央 IMU，侧边及下沿以 3.0 mm 名义框宽实施，另备 8 mm 工艺边可拆载框。每只眼形成 8 个紧凑 LED+PD 单元，全部器件在同一块板上。IR11-21C 出光方向垂直 PCB，其所在区域须朝向眼球或采用开窗式安装。 |
| MECH1–MECH16 | 光学隔离件 | 消光黑硅胶或 3D 打印遮光罩，每个光学单元 1 件 | 16 | 每个紧凑 LED+PD 单元 1 件；遮光罩应在 IR11-21C 正面预留朝眼球的出光开窗，并隔离 LED 与 PD 的直射串扰。 |
| OPT1–OPT2 | 红外透过、可见光抑制窗 | **初版不装配（DNP）** | 0 | 仅室内验证时不需要；后续若扩展到室外或强光环境，再增加 940 nm IR-pass 滤光件。 |

## 接口与功耗预算

| 项目 | 初始规格 |
|---|---|
| 主机供电 | 板端 3.20–3.40 V，稳压输出 |
| 主机供电能力 | 每模块 **≥100 mA 持续、≥200 mA 峰值** |
| LED 工作方式 | 16 颗 LED 逐颗时分点亮，不允许 16 颗同时驱动 |
| 初始 LED 参数 | 约 19.85 mA 脉冲电流；50 Hz 完整帧率；每颗 LED 点亮 100 µs |
| LED 平均电流 | 约 **1.6 mA**：16 × 100 µs × 50 Hz × 20 mA |
| 板级平均电流估算 | **12–25 mA**，待固件采样策略和模拟增益实测后收敛 |
| 工作峰值电流估算 | 单颗 LED 点亮时 **<80 mA**；为启动和瞬态预留 200 mA 主机裕量 |
| 对外通信 | 3.3 V TTL UART，默认 115200 baud；原始诊断数据支持 1 Mbps 模式 |
| 建议 UART 载荷 | 近/远视类别、置信度、左右眼通道摘要、IMU 状态、故障标志；必要时按需上报 16 路原始数据 |

## 单眼光学单元与主反射通道映射（EVT 初版）

每只眼布置 8 个紧凑光学单元；每个单元包含 1 颗 LED 与 1 颗 PD。近/远视主信号只取**跨单元**的对向或斜对向反射，不使用同单元 LED–PD 直收信号，避免直射串扰和皮肤漫反射主导信号。

| 光学单元 | 镜框位置（单眼） | 包含器件 |
|---|---|---|
| G1 | 鼻侧上方 | E1、P1 |
| G2 | 上方内侧 | E2、P2 |
| G3 | 上方外侧 | E3、P3 |
| G4 | 颞侧上方 | E4、P4 |
| G5 | 颞侧下方 | E5、P5 |
| G6 | 下方外侧 | E6、P6 |
| G7 | 下方内侧 | E7、P7 |
| G8 | 鼻侧下方 | E8、P8 |

| LED 点亮 | 主接收 PD | 跨单元光路 |
|---|---|---|
| E1（G1） | P5（G5） | 对侧斜对 |
| E2（G2） | P6（G6） | 对侧斜对 |
| E3（G3） | P7（G7） | 对侧斜对 |
| E4（G4） | P8（G8） | 对侧斜对 |
| E5（G5） | P1（G1） | 对侧斜对 |
| E6（G6） | P2（G2） | 对侧斜对 |
| E7（G7） | P3（G3） | 对侧斜对 |
| E8（G8） | P4（G4） | 对侧斜对 |

上述映射是 EVT 的初始编号约定，量产前须根据镜框尺寸、LED/PD 实际朝向及不同注视距离下的实测反射强度重新标定；允许将个别低信噪比通道替换为另一颗对向/斜对向单元中的 PD。

## 烧录与调试约定

| 项目 | 定义 |
|---|---|
| 首选烧录方式 | **ST-Link + J2（Tag-Connect 10 Pin）+ SWD**；无需在板上焊接排针或连接器。 |
| J2 必接网络 | VTref/3V3、GND、SWDIO、SWCLK、NRST；SWO 可不接。 |
| 默认启动 | 首次烧录时核对启动 option bytes，配置从用户 Flash 启动；R5 对 PA14 提供 100 kΩ 弱下拉。 |
| 救砖方式 | 首选 ST-Link/SWD 连接复位恢复。若使用 **PA9/PA10** 的 USART1 Bootloader，须先按 RM0490/AN2606 配置并验证启动 option bytes；PA14 与 SWCLK 共用，调试时不要硬拉高。 |
| 运行日志 | 主机 UART 与 TP 上的 UART-TX 共用，可直接查看采样数据、IMU 状态和故障码。 |

## 原理图与布局约束

1. 正常采集时必须采用 **LED 逐颗扫描**：每颗 LED 点亮期间，仅采样预标定的对侧或斜对侧 PD；不能以邻近 PD 的高串扰信号作为近/远视主特征。
2. 每颗 PD、其 TIA 输入端和反馈 R/C 回路必须紧凑布置；LED 开关电路与 TIA/基准电路按区域布置，使用共同 GND 参考铜，避免高电流回路穿过敏感输入区。
3. **IR11-21C 为正面出光而非侧发射**：其发光面必须直接朝向眼球，或通过镜框内侧的开窗/小型折角支架朝向眼球；若 PCB 只能平铺且元件面与眼球不相对，则不应使用该型号。PD15-21B 为正面受光；室内初版可以不装 940 nm 滤光件，但仍应保留简单的黑色遮光结构，避免 LED 与 PD 的直射串扰。
4. RF/CF 是原型起始值，尚非量产冻结参数；需在代表性的成人亚洲人脸型、镜框间距、阳光、镜片反光和头眼运动条件下实测校准。
5. 主机的 3.3 V 不应直接以高噪声方式供给模拟前端；必须保留磁珠隔离与局部储能电容。

## 本设计明确不包含

- 电池、充电 IC、电量计、BLE SoC/射频、天线和无线认证相关器件。
- 刚挠结合板、独立的中央处理板、独立眼部传感板及板间连接线缆。

## PCB 实施更新（2026-09-06，EVT C）

- U2–U5 改为 **TLV9064IPWR**，数量仍为 4。使用 TSSOP-14（PW），本体 4.4 × 5.0 mm、含引脚外廓约 6.4 × 5.0 mm，焊盘间距 0.65 mm；PCB 封装为 `TSSOP-14_4.4x5mm_P0.65mm`。
- PW 与原 D 封装的 14 脚定义相同，16 路 TIA 的连接、RF=100 kΩ 和 CF=22 pF 保持不变。不得把新器件贴到旧 SOIC 焊盘上。
- 当前布局采用正向镜框、鼻梁缺口朝下、LED/PD 沿框边并排，以及四层 PCB 和双面贴装。
- [TI TLV9064IPWR 产品页](https://www.ti.com/product/TLV9064/part-details/TLV9064IPWR)；[TI 数据手册，图 5-13 及 PW 封装图](https://www.ti.com/lit/ds/symlink/tlv9064.pdf)。

## PCB 布局更新（2026-09-06，EVT D）

- TLV9064IPWR 四颗不变；下沿 U3、U5 及配套反馈阻容和去耦移到上沿，下方凸起取消。
- LED/PD 沿局部镜框切向旋转并靠近开孔，侧边及下沿名义框宽约 3.7 mm；两个眼部开孔不变。
- PCB 外形约 133.136 × 52.653 mm，四层双面贴装；本版贴片坐标为正面 77 个、背面 45 个元件。
- J1 的焊盘和接法不变，补齐 TE 官方 STEP 模型并对齐焊脚，便于装配与插线方向检查。
- C28 向左微移 0.5 mm；密集区增加 0.5 mm 焊盘 / 0.3 mm 钻孔的通孔，其余普通通孔为 0.6/0.3 mm。
- 具体坐标及正反面以 hardware/ir_glasses/EVT_D/bom.csv 和 manufacturing/positions.csv 为准。

## PCB 布局更新（2026-09-06，EVT E）

- 改为四层 PCB、单面贴装，122 个待装元件全部在 F.Cu，B.Cu 贴装数量为 0；测试点、J2 调试焊盘和 NT1 也位于正面。
- U2–U5 继续使用 TLV9064IPWR / TSSOP-14；原理图连接、器件数量和阻容值不变。
- U10 LSM6DS3TR-C 移至鼻梁上方中线，坐标 (110.000, 71.300) mm、0°，旁边增加 IMU 和 X/Y 方向丝印，保留 1 脚标记。
- 四颗运放及其反馈阻容、全部控制和供电器件利用上沿空间重新排布；J1 装在同一面，排线开口朝外。
- 板框与 EVT D 相同：约 133.136 × 52.653 mm，下沿/侧框名义宽 3.7 mm；双眼开孔及 LED/PD 切向并排布置不变。
- 单面钢网及贴装；贯穿孔 0.5/0.3 mm，线宽/间距最小 0.15/0.15 mm。采购和贴片以 `hardware/ir_glasses/EVT_E/bom.csv`、`manufacturing/positions.csv` 为准。

## EVT E2 完整 PCBA 采购料号（冻结）

两板净用量不含损耗；建议备料量、采购链接与供货缺口见 CSV。禁止仅按阻容数值自动换料。

| 位号 | 厂家 | 完整 MPN | 采购编码 | 每板 | 两板净用 |
|---|---|---|---|---:|---:|
| U9 | STMicroelectronics | STM32C031C6T6 | C5456218 | 1 | 2 |
| U1 | Texas Instruments | TLC59283RGER | C485815 | 1 | 2 |
| U10 | STMicroelectronics | LSM6DS3TR-C | C967633 | 1 | 2 |
| U6 | Texas Instruments | TLV9061IDBVR | C398358 | 1 | 2 |
| J1 | TE Connectivity | 2492111-5 | 17-2492111-5CT-ND | 1 | 2 |
| U11 | Nexperia | PESD3V3L2BT,215 | C55440 | 1 | 2 |
| D17 | Nexperia | PESD5V0S1BA,115 | C19224 | 1 | 2 |
| FB1 | Murata | BLM18AG601SN1D | C19330 | 1 | 2 |
| R1 | Viking | ARG02FTC2671 | C284464 | 1 | 2 |
| R2,R3,R4,R10 | UNI-ROYAL | 0402WGF1002TCE | C25744 | 4 | 8 |
| R5,RF1,RF2,RF3,RF4,RF5,RF6,RF7,RF8,RF9,RF10,RF11,RF12,RF13,RF14,RF15,RF16 | UNI-ROYAL | 0402WGF1003TCE | C25741 | 17 | 34 |
| R6,R7 | UNI-ROYAL | 0402WGF4701TCE | C25900 | 2 | 4 |
| R8,R9 | UNI-ROYAL | 0402WGF220JTCE | C25092 | 2 | 4 |
| R11,R12 | UNI-ROYAL | 0402WGF1000TCE | C25076 | 2 | 4 |
| R13 | UNI-ROYAL | 0402WGF470JTCE | C25118 | 1 | 2 |
| U2,U3,U4,U5 | Texas Instruments | TLV9064IPWR | C779410 | 4 | 8 |
| PD1,PD2,PD3,PD4,PD5,PD6,PD7,PD8,PD9,PD10,PD11,PD12,PD13,PD14,PD15,PD16 | Everlight | PD15-21B/TR8 | C2921391 | 16 | 32 |
| D1,D2,D3,D4,D5,D6,D7,D8,D9,D10,D11,D12,D13,D14,D15,D16 | Everlight | IR11-21C/TR8 | C19269752 | 16 | 32 |
| CF1,CF2,CF3,CF4,CF5,CF6,CF7,CF8,CF9,CF10,CF11,CF12,CF13,CF14,CF15,CF16 | FH | 0402CG220J500NT | C1555 | 16 | 32 |
| U7,U8 | Texas Instruments | TMUX1308PWR | C970231 | 2 | 4 |
| C1,C18,C19,C20,C21,C22,C23,C24 | CCTC | TCC0402X7R105K160AT | C49210445 | 8 | 16 |
| C2,C3,C4,C5,C6,C7,C8,C9,C10,C11,C12,C13,C14,C15,C16,C17,C31 | Samsung Electro-Mechanics | CL05B104KO5NNNC | C1525 | 17 | 34 |
| C25,C26,C27 | Samsung Electro-Mechanics | CL10A106KP8NNNC | C19702 | 3 | 6 |
| C28 | YAGEO | CC1210KKX5R7BB476 | C596320 | 1 | 2 |
| C29,C30 | FH | 0402CG102J500NT | C53547 | 2 | 4 |

J1 延续 E1 的 TE 2492111-5 专用焊盘与模型；本批 PD 已变更，必须使用 EVT E2 的工程、BOM、坐标与制造文件，E1 及更早版本保留为历史快照。PD 的嘉立创国内可贴库存尚待实时核对；工程料号冻结不代表两板物料已齐套。

最新采购口径：[E2 嘉立创国内贴片库存核对](../hardware/ir_glasses/EVT_E2/procurement/README.md)。本次 24 个有编码页面均返回校验页，J1 按指定料号自备。25 类料须以实际配单、损耗和入库结果为准；国际商城及海外贴片站的库存不作为国内齐料依据。

## PCB 与生产资料更新（2026-09-07，EVT E2）

- PD1–PD16 改为 **Everlight PD15-21B/TR8 / C2921391**。本体由旧 22B 的 3.2 × 2.7 mm 缩为 3.2 × 1.5 mm；采用两个 1.0 × 1.5 mm 焊盘、中心距 2.6 mm，1=A、2=K。引用 [Everlight 原厂封装与数据手册](https://en.everlight.com/wp-content/plugins/ItemRelationship/product_files/pdf/PD15-21B-TR8.pdf)及 [C2921391 产品身份](https://www.lcsc.com/product-detail/C2921391.html)。
- 两块首板均保持 RF=100 kΩ、CF=22 pF，220 kΩ 和 470 kΩ 另列调试备件。21B 手册的典型 0.8 µA 来自 940 nm、1 mW/cm²、5 V 反偏测试，实际本板反偏约 1.65 V，需重新测噪声、建立时间和饱和余量。
- 保持正向双眼开孔、LED 靠近眼部、LED/PD 沿边并排、中央 IMU 及其轴向丝印、全部单面贴装。薄框和载框尺寸以 E2 最终机械报告为准。
- 制造默认四层、1.6 mm、沉金、正面贴装；5 块裸板中 2 块贴片。载框及工装须经工厂 DFM，不能将工程检查当作工厂接单或光学性能通过。
- [E2 首板测试表](../hardware/ir_glasses/EVT_E2/first_board_test.md)包含供电、SWD/UART、IMU、16 路暗态/照光、背景扣除、串扰、饱和和采样建立时间。[费用预算](../hardware/ir_glasses/EVT_E2/cost_estimate.md)按标准型预留约 1,000–1,700 元，待实际配单与工厂报价更新。
