noahzhy/cc_glasses/assets/3mf/3d_model.3mf

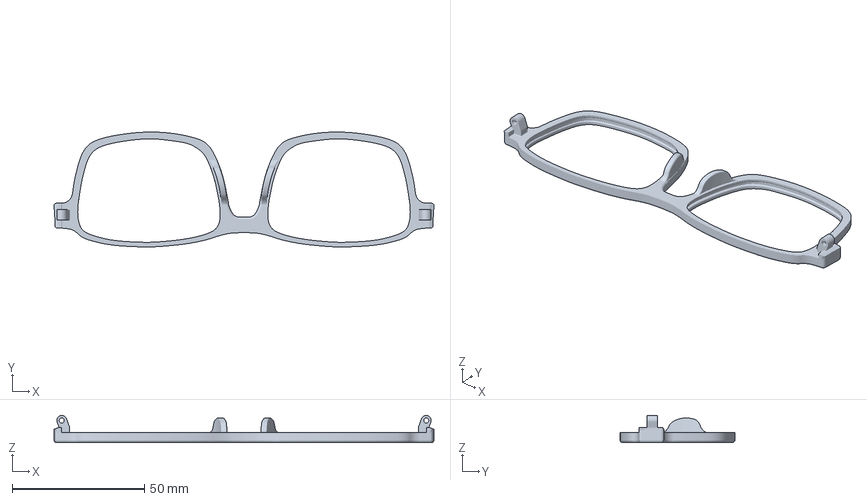
[picture p34: CAD file, 2026-09-05]
assets/3mf/3d_model.3mf
143.7 x 43.5 x 10.3 mm
