noahzhy/cc_glasses/hardware/ir_glasses/ir_glasses_EVT_E7/models/WSON-6-1EP_2x2mm_P0.65mm_EP1x1.6mm.step

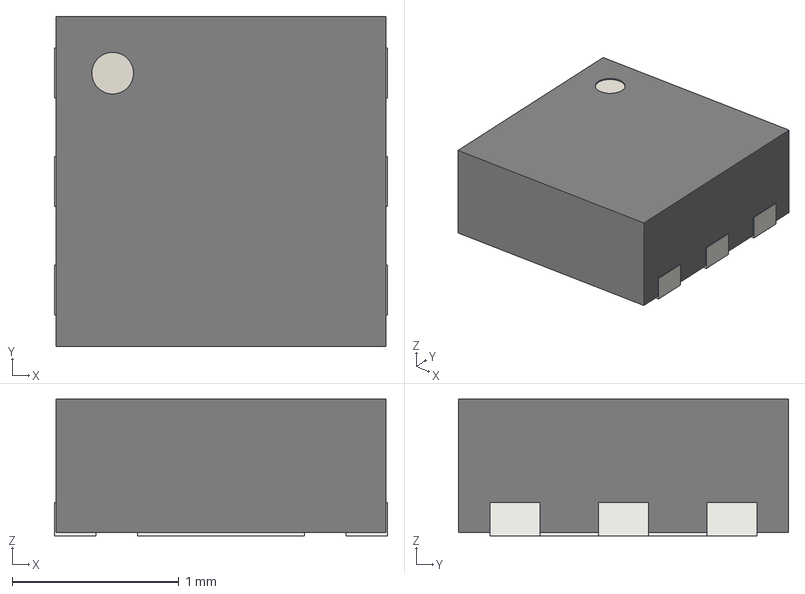
[picture p35: CAD file, 2026-09-17]
hardware/ir_glasses/ir_glasses_EVT_E7/models/WSON-6-1EP_2x2mm_P0.65mm_EP1x1.6mm.step
2.00 x 1.98 x 0.82 mm
