noahzhy/cc_glasses/hardware/ir_glasses/ir_glasses_EVT_E7/models/VSSOP-8_3x3mm_P0.65mm.step

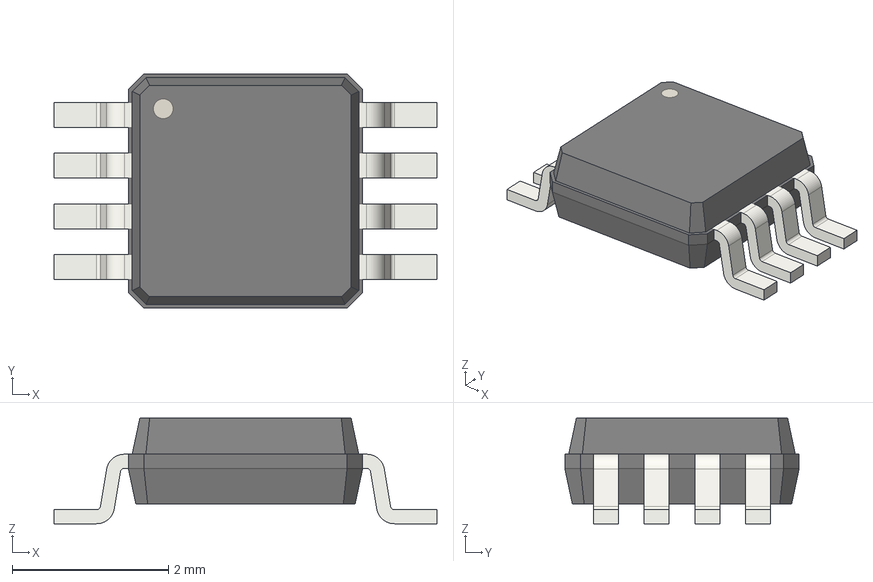
[picture p36: CAD file, 2026-09-17]
hardware/ir_glasses/ir_glasses_EVT_E7/models/VSSOP-8_3x3mm_P0.65mm.step
4.90 x 3.00 x 1.35 mm
