noahzhy/cc_glasses/hardware/ir_glasses/ir_glasses_EVT_E7/models/WSON-6_1.5x1.5mm_P0.5mm.step

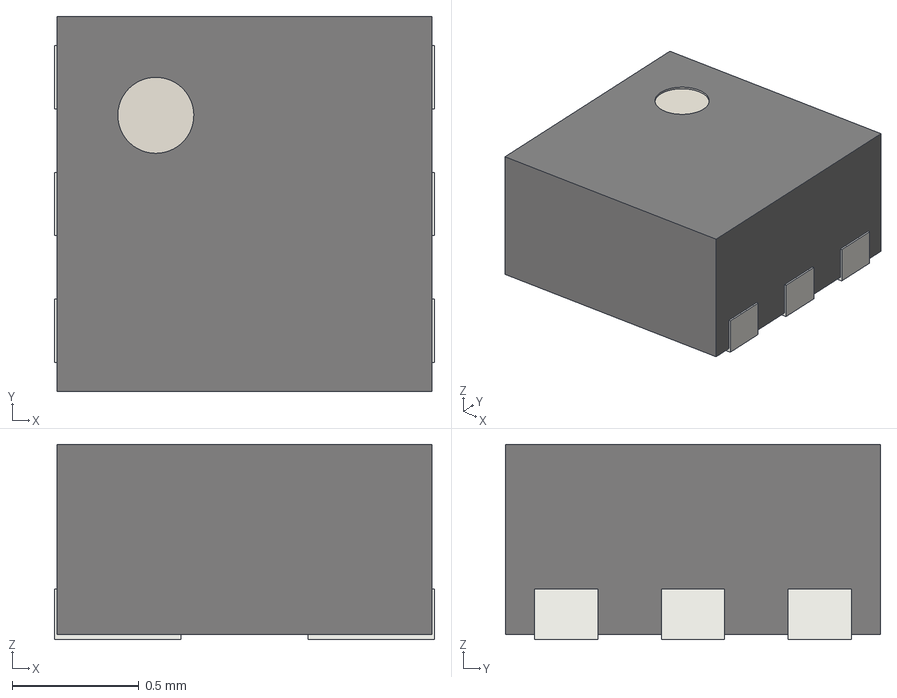
[picture p37: CAD file, 2026-09-17]
hardware/ir_glasses/ir_glasses_EVT_E7/models/WSON-6_1.5x1.5mm_P0.5mm.step
1.50 x 1.48 x 0.77 mm
