noahzhy/cc_glasses/hardware/ir_glasses/ir_glasses_EVT_E7/models/TSOT-23-6.step

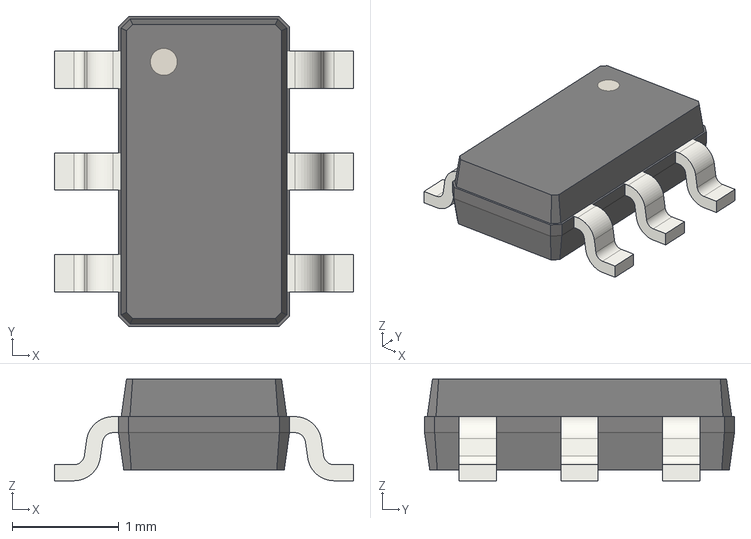
[picture p38: CAD file, 2026-09-17]
hardware/ir_glasses/ir_glasses_EVT_E7/models/TSOT-23-6.step
2.80 x 2.90 x 0.95 mm
