noahzhy/cc_glasses/hardware/ir_glasses/ir_glasses_EVT_E7/models/C_0603_1608Metric.step

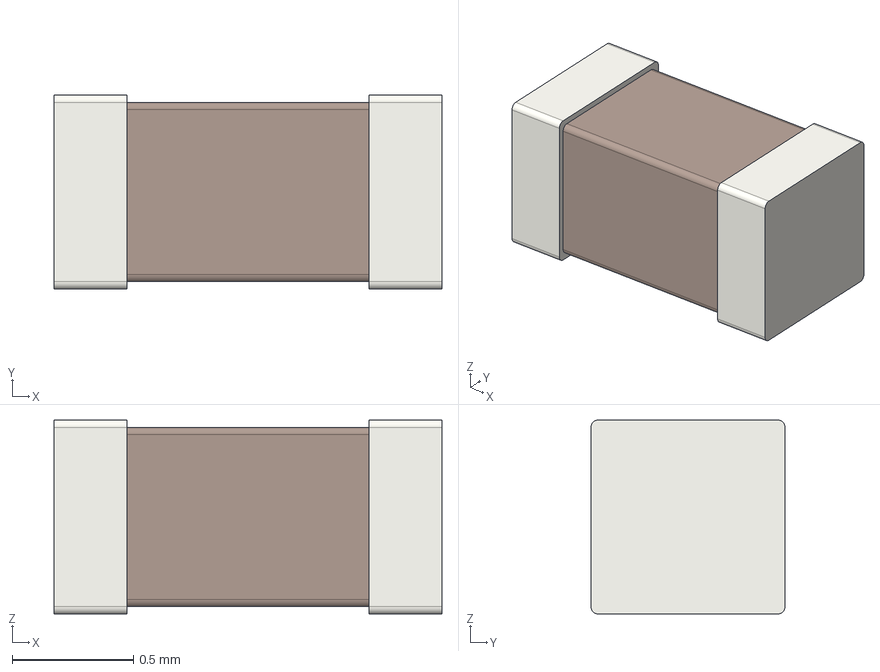
[picture p40: CAD file, 2026-09-08]
hardware/ir_glasses/ir_glasses_EVT_E7/models/C_0603_1608Metric.step
1.60 x 0.8 x 0.8 mm
