noahzhy/cc_glasses/hardware/ir_glasses/ir_glasses_EVT_E7/models/TSSOP-14_4.4x5mm_P0.65mm.step

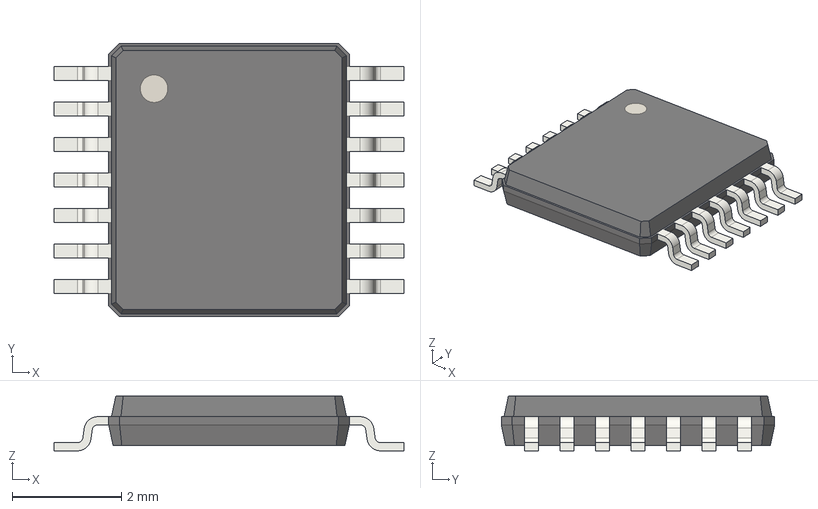
[picture p41: CAD file, 2026-09-08]
hardware/ir_glasses/ir_glasses_EVT_E7/models/TSSOP-14_4.4x5mm_P0.65mm.step
6.40 x 5.00 x 1.00 mm
