noahzhy/cc_glasses/hardware/ir_glasses/ir_glasses_EVT_E7/models/LGA-14_3x2.5mm_P0.5mm_LayoutBorder3x4y.step

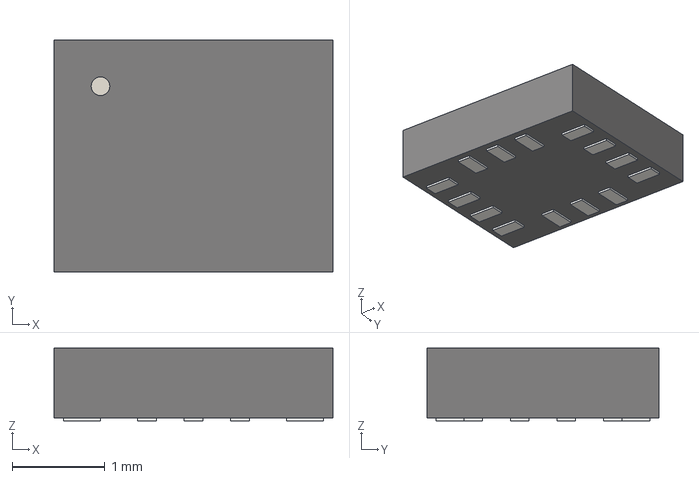
[picture p43: CAD file, 2026-09-08]
hardware/ir_glasses/ir_glasses_EVT_E7/models/LGA-14_3x2.5mm_P0.5mm_LayoutBorder3x4y.step
3.00 x 2.50 x 0.78 mm
