noahzhy/cc_glasses/hardware/ir_glasses/ir_glasses_EVT_E7/models/C_1210_3225Metric.step

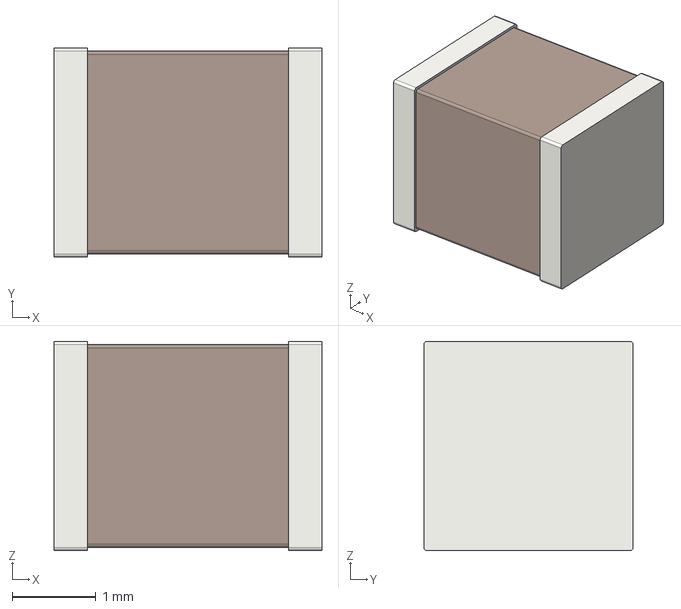
[picture p44: CAD file, 2026-09-08]
hardware/ir_glasses/ir_glasses_EVT_E7/models/C_1210_3225Metric.step
3.20 x 2.50 x 2.50 mm
