noahzhy/cc_glasses/hardware/ir_glasses/ir_glasses_EVT_E7/models/C_0402_1005Metric.step

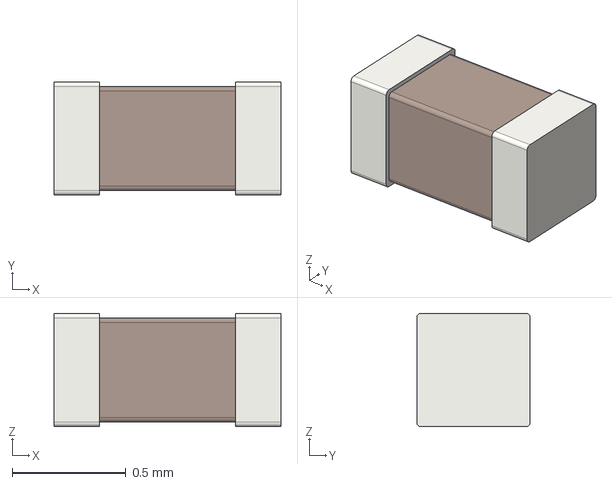
[picture p45: CAD file, 2026-09-08]
hardware/ir_glasses/ir_glasses_EVT_E7/models/C_0402_1005Metric.step
1.00 x 0.5 x 0.5 mm
