noahzhy/cc_glasses/hardware/ir_glasses/ir_glasses_EVT_E7/models/D_SOD-523.step

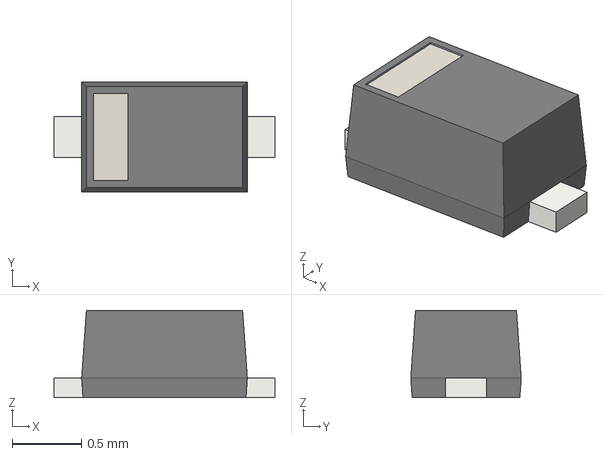
[picture p46: CAD file, 2026-09-08]
hardware/ir_glasses/ir_glasses_EVT_E7/models/D_SOD-523.step
1.60 x 0.8 x 0.63 mm
