noahzhy/cc_glasses/hardware/ir_glasses/ir_glasses_EVT_E7/models/SOT-23.step

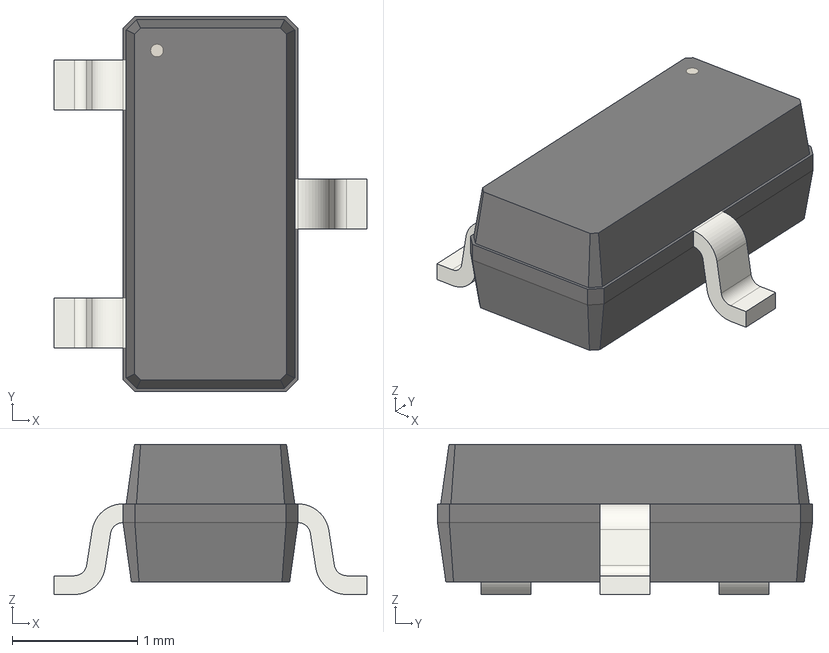
[picture p47: CAD file, 2026-09-08]
hardware/ir_glasses/ir_glasses_EVT_E7/models/SOT-23.step
2.50 x 3.00 x 1.20 mm
