noahzhy/cc_glasses/hardware/ir_glasses/ir_glasses_EVT_E7/models/D_SOD-323.step

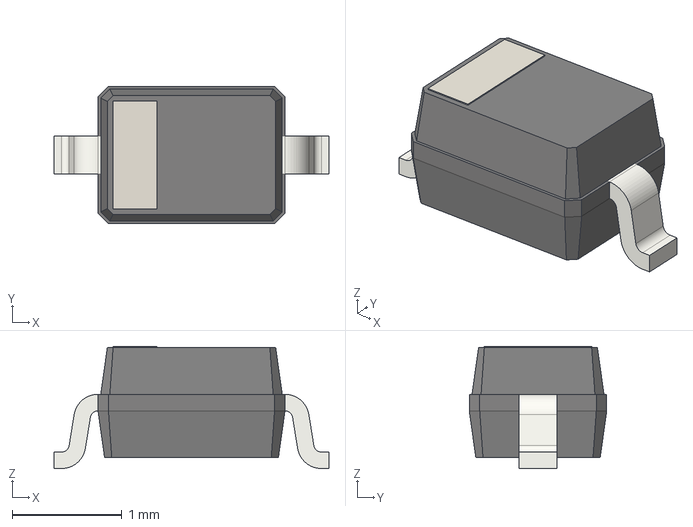
[picture p48: CAD file, 2026-09-08]
hardware/ir_glasses/ir_glasses_EVT_E7/models/D_SOD-323.step
2.50 x 1.25 x 1.11 mm
