noahzhy/cc_glasses/hardware/ir_glasses/ir_glasses_EVT_E7/models/Texas_RGE0024C_VQFN-24-1EP_4x4mm_P0.5mm_EP2.1x2.1mm.step

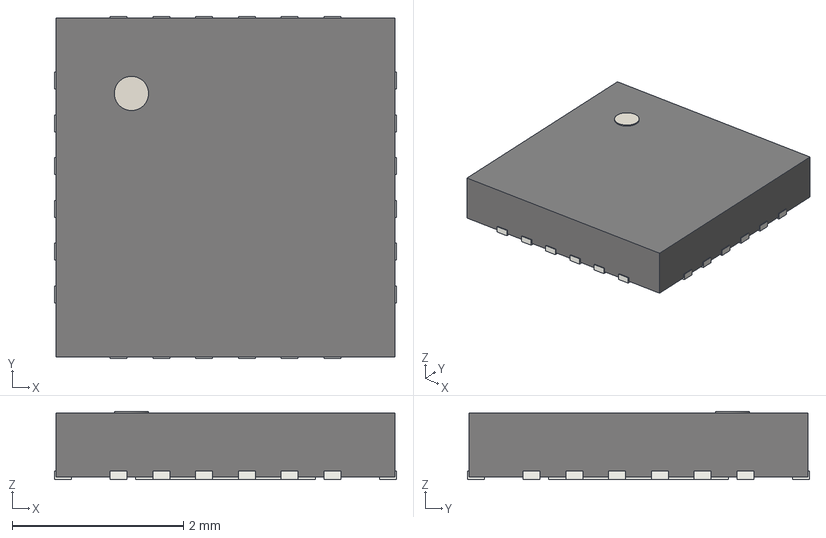
[picture p49: CAD file, 2026-09-08]
hardware/ir_glasses/ir_glasses_EVT_E7/models/Texas_RGE0024C_VQFN-24-1EP_4x4mm_P0.5mm_EP2.1x2.1mm.step
4.00 x 4.00 x 0.8 mm
