noahzhy/cc_glasses/hardware/ir_glasses/ir_glasses_EVT_E7/models/LQFP-48_7x7mm_P0.5mm.step

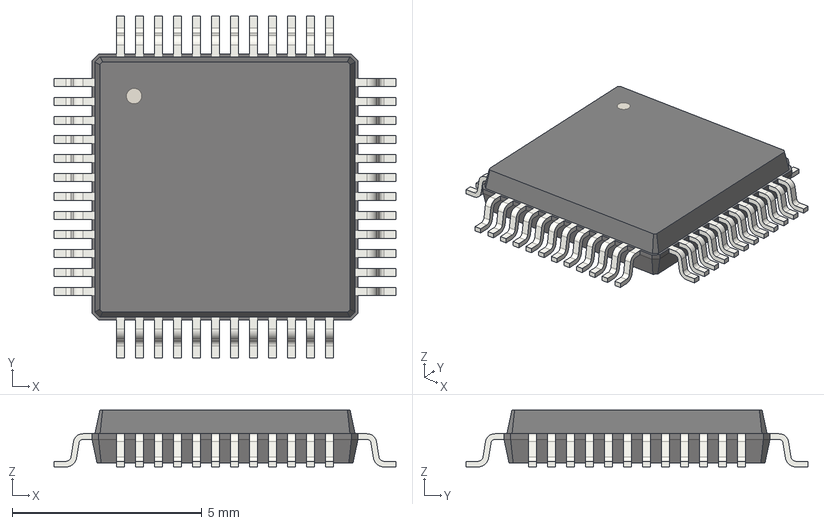
[picture p51: CAD file, 2026-09-08]
hardware/ir_glasses/ir_glasses_EVT_E7/models/LQFP-48_7x7mm_P0.5mm.step
9.00 x 9.00 x 1.50 mm
