noahzhy/cc_glasses/hardware/ir_glasses/ir_glasses_EVT_E7/models/SSOP-8_2.95x2.8mm_P0.65mm.step

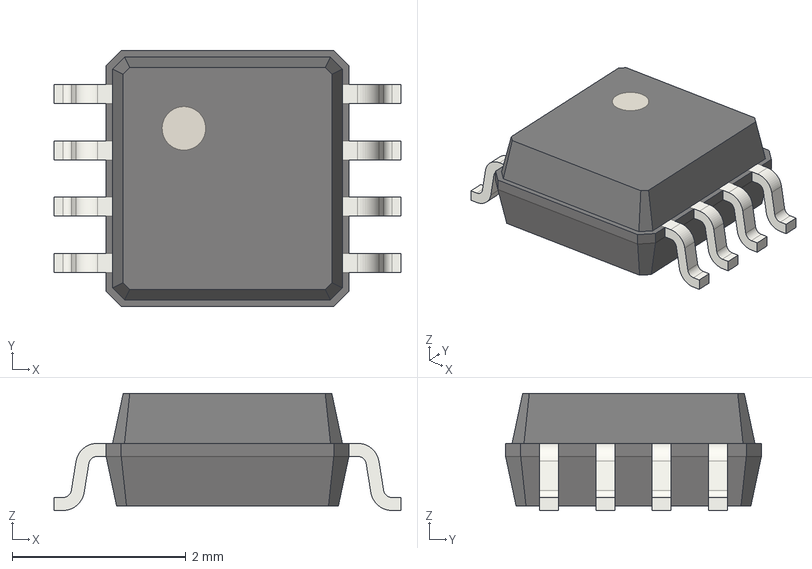
[picture p52: CAD file, 2026-09-08]
hardware/ir_glasses/ir_glasses_EVT_E7/models/SSOP-8_2.95x2.8mm_P0.65mm.step
4.00 x 2.95 x 1.35 mm
