noahzhy/cc_glasses/hardware/ir_glasses/ir_glasses_EVT_E7/models/SOT-23-5.step

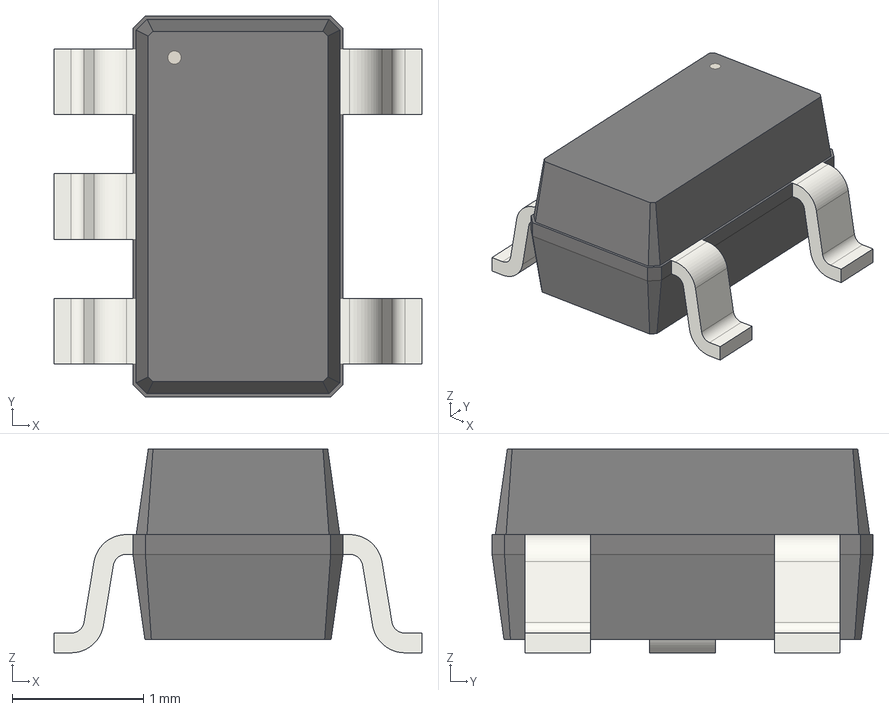
[picture p53: CAD file, 2026-09-08]
hardware/ir_glasses/ir_glasses_EVT_E7/models/SOT-23-5.step
2.80 x 2.90 x 1.55 mm
