noahzhy/cc_glasses/hardware/ir_glasses/ir_glasses_EVT_E7/models/TE_2492111-5_aligned.step

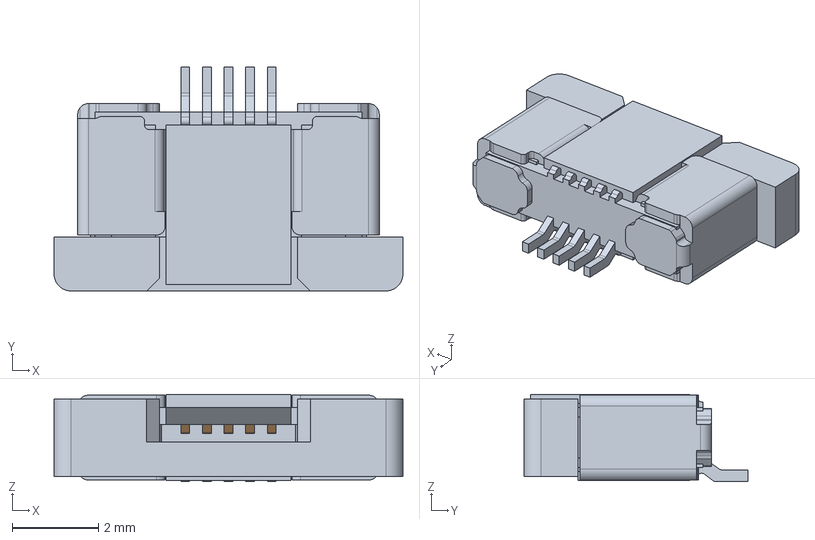
[picture p54: CAD file, 2026-09-07]
hardware/ir_glasses/ir_glasses_EVT_E7/models/TE_2492111-5_aligned.step
8.10 x 5.20 x 2.02 mm
