noahzhy/cc_glasses/(list of files, cad)

Other CAD files:
hardware/ir_glasses/ir_glasses_EVT_E7/models/L_0603_1608Metric.step
assets/blender/3d_model.blend
assets/blender/3d_model_bkup.blend
