noahzhy/cc_glasses/hardware/ir_glasses/ir_glasses_EVT_E7/assembly_notes.md

# EVT E7 装配与评审说明

全部电气元器件及测试点位于正面（F.Cu），背面仅用于布线。carrier 只保留工艺边、连接桥、定位孔及基准点，没有功能电路。

沿用 E6 四层、1.6 mm 叠层和 1 oz 外层铜；线宽/间距不小于 0.10 mm，铜到板边不小于 0.30 mm。所有过孔钻孔孔径不小于 0.20 mm，铜外径不小于 0.40 mm，单边环宽不小于 0.10 mm。工程最小通孔孔径和过孔外径规则已同步。小孔钻径补偿、孔铜、盖油和钢网仍需工厂 DFM 确认，本次不生成或发布制造包。

光学器件、接口和机械辅助件的坐标、方向及所在面保持 E6 基线。实际对比见 `review/placement_comparison.csv`。位号及装配方向以正面装配图和可编辑 PCB 为准；贴装机零度定义需在后续制造评审时核对。

`assembly_positions.csv` 含 BOM 中 153 个器件的正面贴装坐标，单位为 mm，采用 KiCad 钻孔/贴装原点及原生旋转角定义；不把测试点或载框基准点列为待贴装器件。板厂需结合正面装配图核对极性及其设备的零度定义。

上电前检查电源阻值及极性；首板按 `first_board_tests.csv` 验证限流、过压恢复、硬件灭灯、偏置建立、采集噪声及通道切换。静态检查不表示这些实测项目已完成。
