noahzhy/cc_glasses/hardware/ir_glasses/EVT_E3/assembly_notes.md

# EVT E3 装配核对

- 142 个器件全部正面贴装。两块板配置相同，RF1–RF16 全部 100 kΩ，CF1–CF16 全部 22 pF。
- D20 为 0603 绿色状态灯：1 脚 K 接 PA8 / STATUS_LED_N，2 脚 A 经 R17 接 3V3，旁边丝印 S。上电空片不保证亮灯。
- D18 / D19 为 SOD523 复位保护二极管：1 脚 K 接信号，2 脚 A 接 GND，不得按普通指示灯极性替换。
- U12 为 SN74LVC1G123DCTR，U13 为 SN74LVC1G04DBVR；不要替换成不同引脚排列的同类逻辑封装。
- U14 为 TPS259470LRPWR，RPW0010A 2 × 2 mm 专用焊盘。1–10 脚按原厂 land pattern，5 / 6 脚为长条电源焊盘，无独立外加 EP 位号。工厂需核对钢网和器件零度方向。
- PD1–PD16：PD15-21B/TR8，两焊盘；1 脚 A 接共同 GND，2 脚 K 接 PD_IN。以 optical_assembly.pdf 的焊盘编号和工厂器件图核对。
- IR-LED D1–D16 与 PD 保持原 E2 的位置和旋转角；勿将 PCB 3D 模型的颜色当作装配极性依据。
- J1 为 TE 2492111-5，自备料；核对上接触、0.5 mm 间距、0.3 mm FFC 及入库包装。J2 为 Tag-Connect 裸焊盘，不安装排针。
- CPL 使用 KiCad 毫米坐标，PosY 与 PCB 编辑器 Y 轴符号相反；载框与本体采用同一坐标原点，不能再手工平移。
- KiCad 的旋转角不等同于工厂器件库的默认零度。正式贴片前逐项核对工厂预览、封装 Pin 1、二极管极性，记录所需平台角度修正。
- 需要工厂确认 QFN/LGA/RPW 焊接检查、光学器件清洗限制、钢网开口、回流曲线及治具支撑。
- 工艺边上的 4 个定位孔和 3 个 Mark 不计入 BOM/CPL。使用带载框加工包，并按 carrier_design.md 支撑后铣断连接桥。
