noahzhy/cc_glasses/hardware/ir_glasses/EVT_E3/assembly_front.png

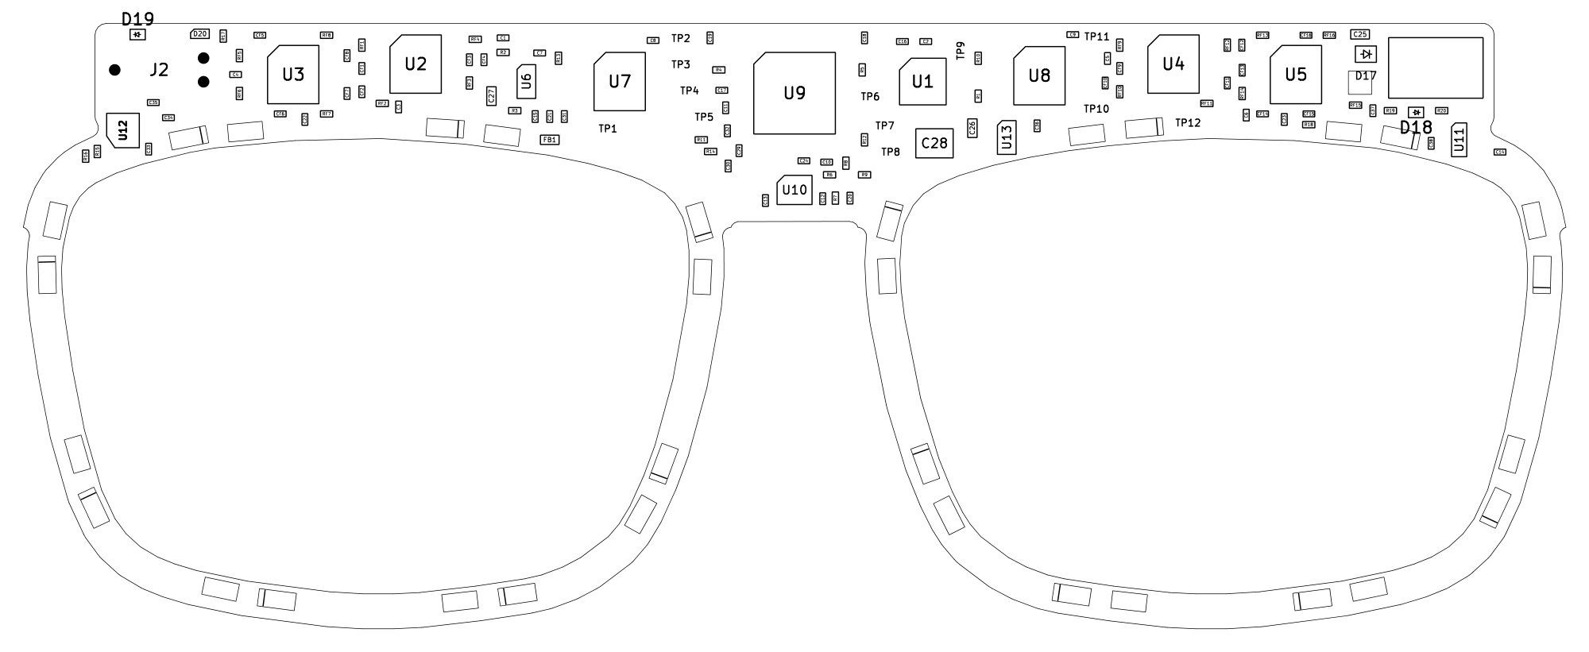
hardware/ir_glasses/EVT_E3/assembly_front.png
