noahzhy/cc_glasses/hardware/ir_glasses/ir_glasses_EVT_E7/schematic.pdf

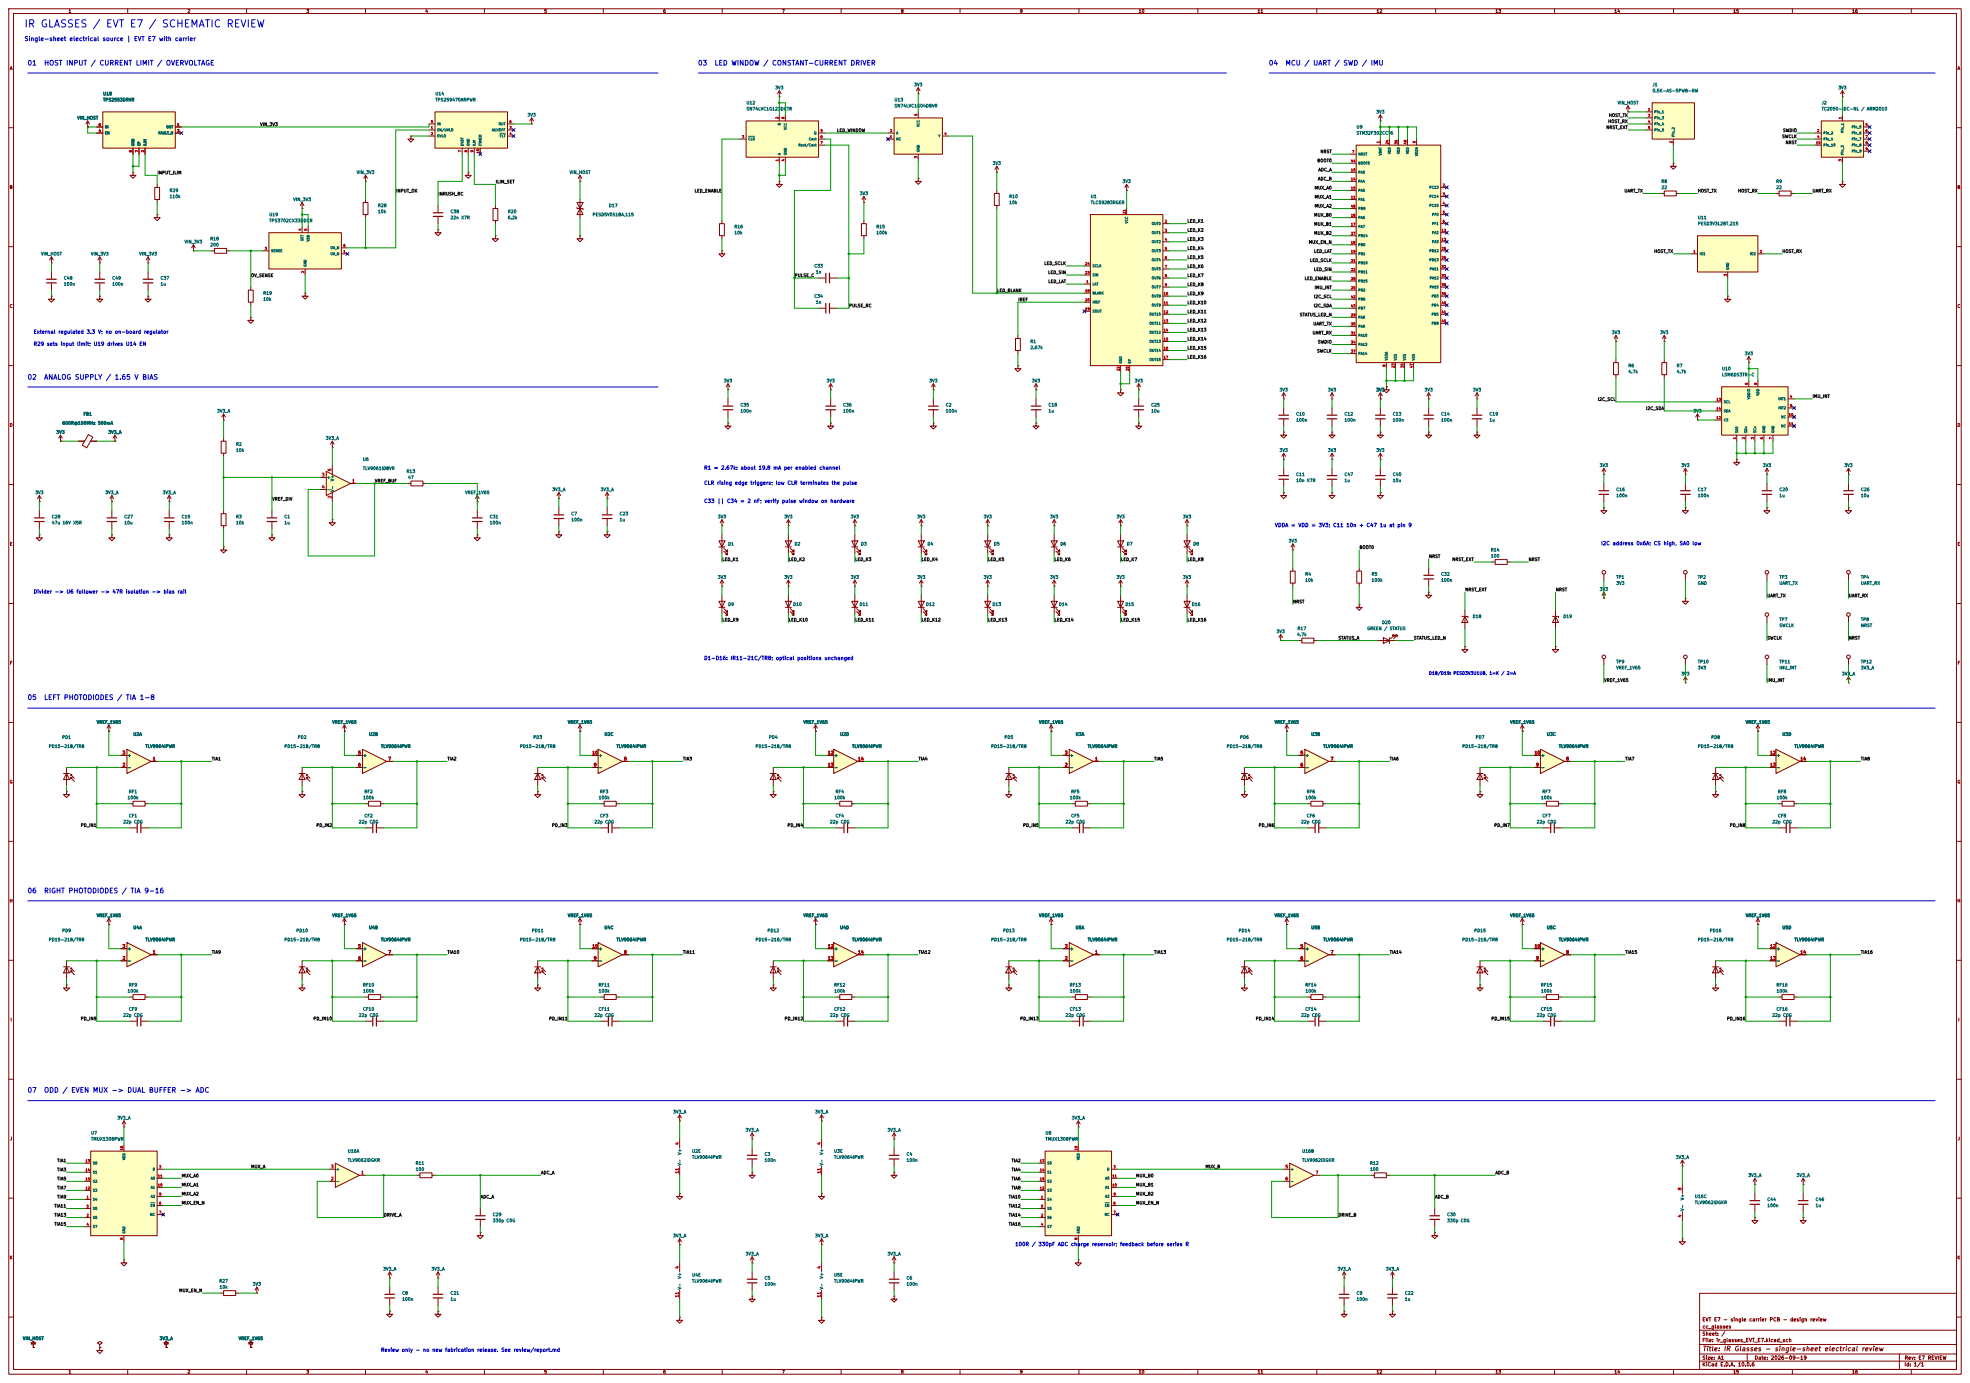
[picture p59: page 1]

IR GLASSES / EVT E7 / SCHEMATIC REVIEW

Single-sheet electrical source | EVT E7 with carrier

01 HOST INPUT / CURRENT LIMIT / OVERVOLTAGE

03 LED WINDOW / CONSTANT-CURRENT DRIVER

04 MCU / UART / SWD / IMU

IREF C33 || C34 = 2 nF; verify pulse window on hardware

External regulated 3.3 V; no on-board regulator

R29 sets input limit; U19 drives U14 EN

R1 = 2.67k: about 19.8 mA per enabled channel

CLR rising edge triggers; low CLR terminates the pulse

VDDA = VDD = 3V3; C11 10n + C47 1u at pin 9

I2C address 0x6A; CS high, SA0 low

Divider -> U6 follower -> 47R isolation -> bias rail

07 ODD / EVEN MUX -> DUAL BUFFER -> ADC

100R / 330pF ADC charge reservoir; feedback before series R

EVT E7 - single carrier PCB - design review
cc_glasses
Sheet: /
File: ir_glasses_EVT_E7.kicad_sch
Title: IR Glasses - single-sheet electrical review

Review only - no new fabrication release. See review/report.md

Size: A1 | Rev: E7 REVIEW
KiCad E.D.A. 10.0.6 | Id: 1/1
