noahzhy/cc_glasses/hardware/ir_glasses/EVT_E3/optical_assembly.pdf

## EVT E3 | LEFT OPTICAL ASSEMBLY | TOP VIEW

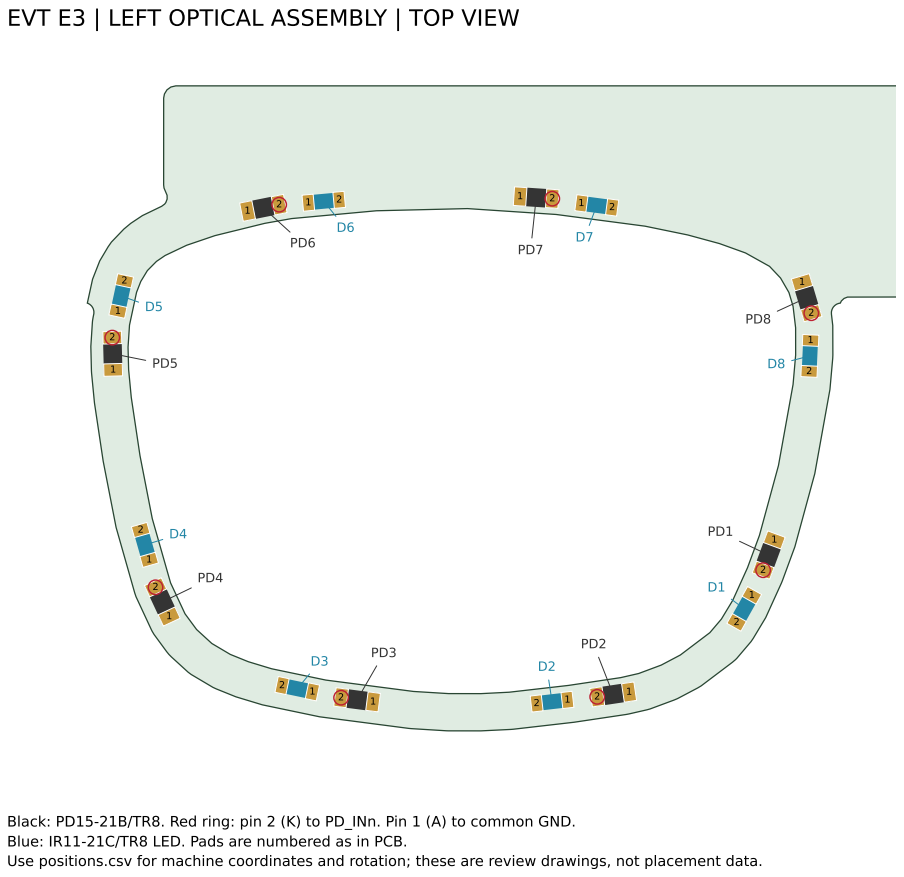
[picture p60: page 1]

Black: PD15-21B/TR8. Red ring: pin 2 (K) to PD_INn. Pin 1 (A) to common GND.
Blue: IR11-21C/TR8 LED. Pads are numbered as in PCB.
Use positions.csv for machine coordinates and rotation; these are review drawings, not placement data.

## EVT E3 | RIGHT OPTICAL ASSEMBLY | TOP VIEW

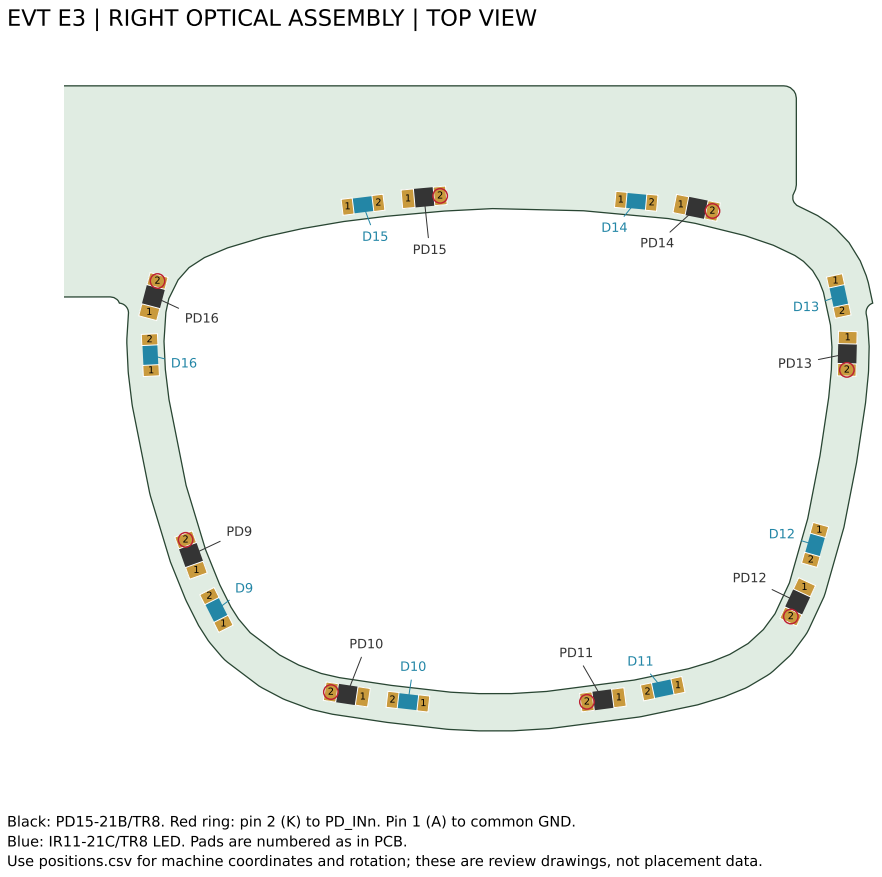
[picture p61: page 2]
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
