noahzhy/cc_glasses/hardware/ir_glasses/ir_glasses_EVT_E7/review/pcb_layers.pdf

## EVT E7 / F_Cu / STATIC REVIEW

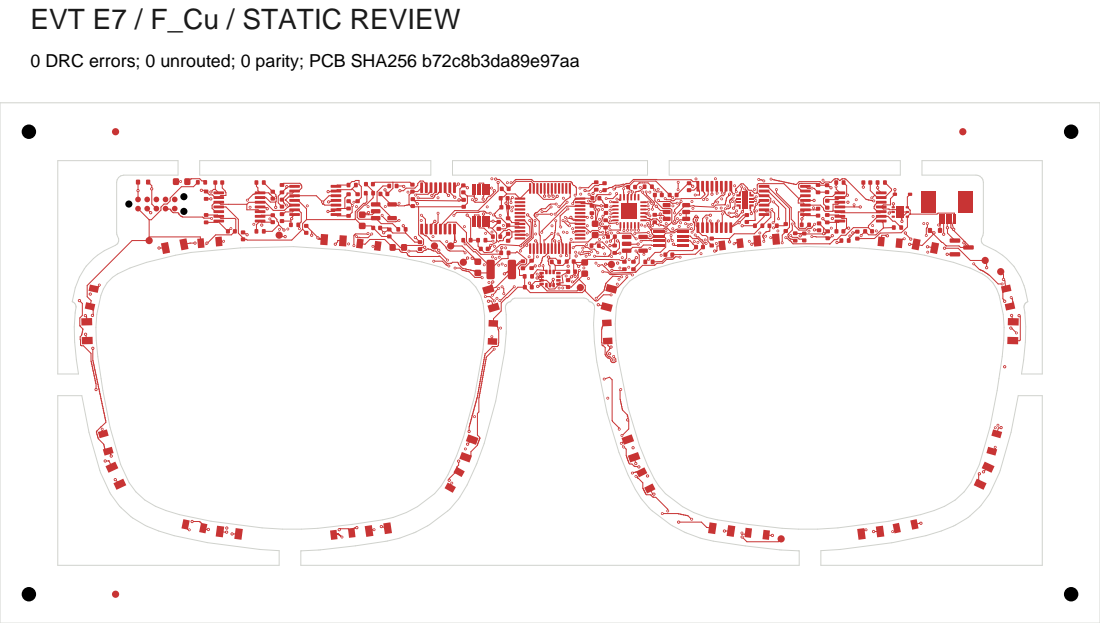
[picture p62: page 1]

0 DRC errors; 0 unrouted; 0 parity; PCB SHA256 b72c8b3da89e97aa

## EVT E7 / In1_Cu / STATIC REVIEW

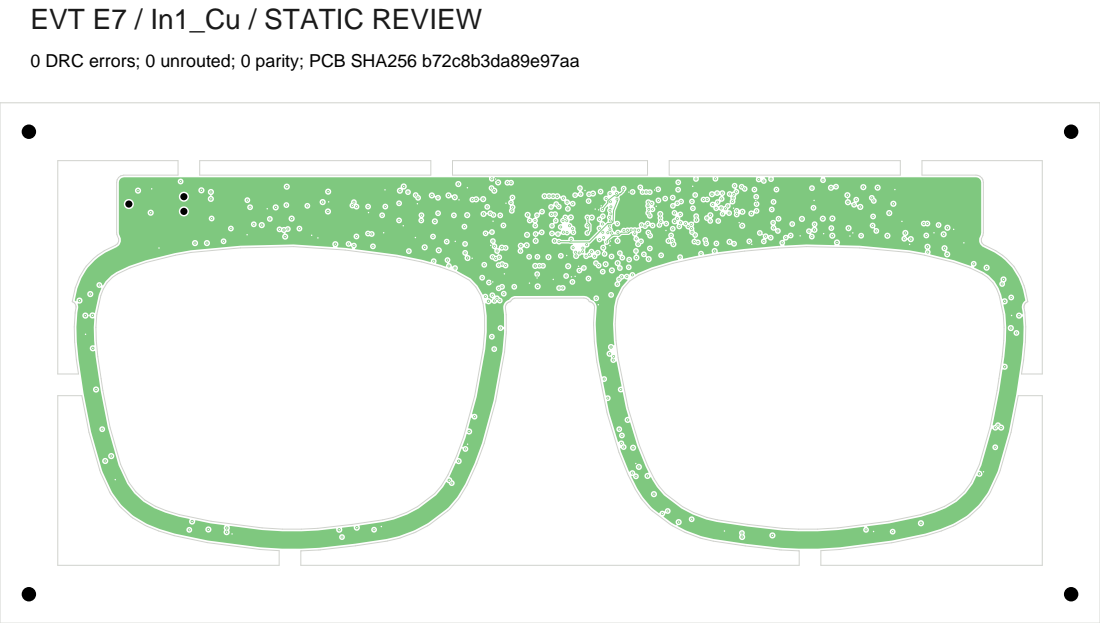
[picture p63: page 2]

0 DRC errors; 0 unrouted; 0 parity; PCB SHA256 b72c8b3da89e97aa

## EVT E7 / In2_Cu / STATIC REVIEW

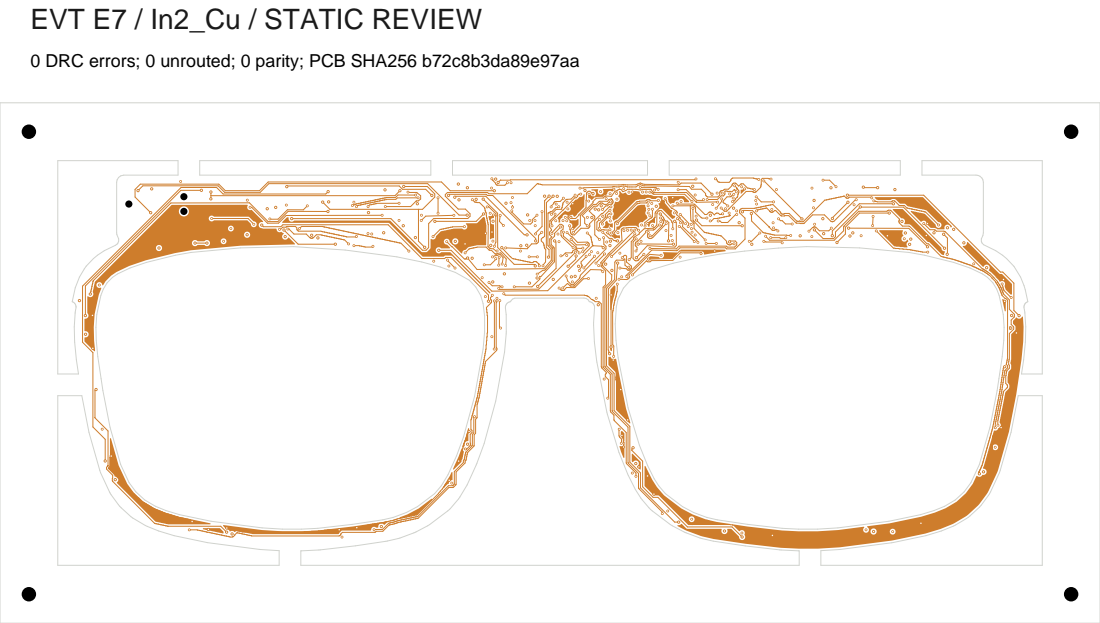
[picture p64: page 3]

0 DRC errors; 0 unrouted; 0 parity; PCB SHA256 b72c8b3da89e97aa

## EVT E7 / B_Cu / STATIC REVIEW

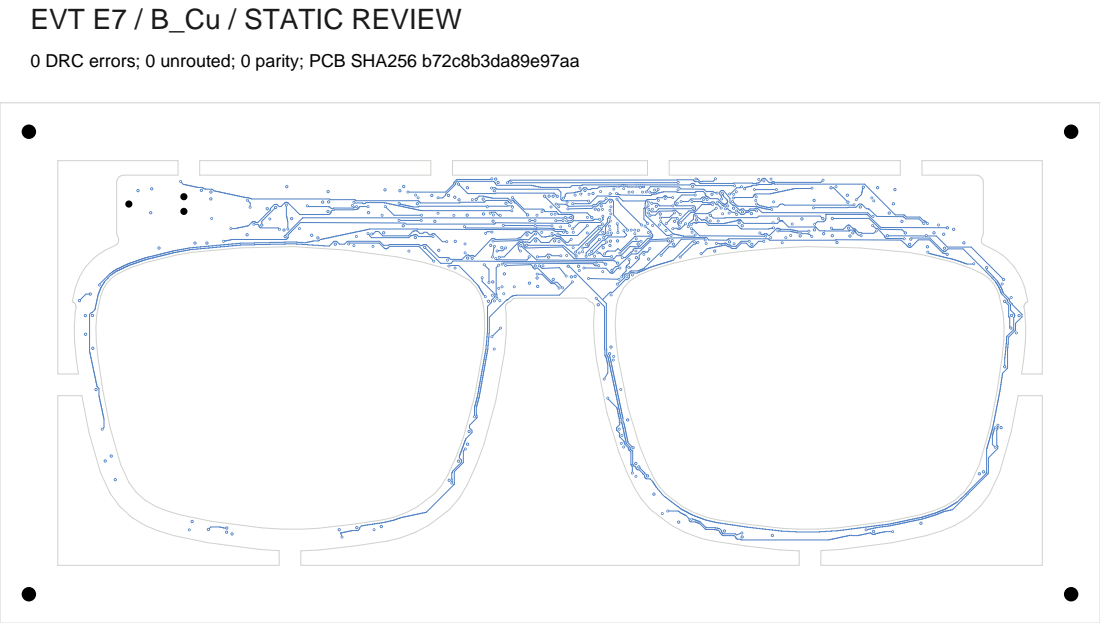
[picture p65: page 4]

0 DRC errors; 0 unrouted; 0 parity; PCB SHA256 b72c8b3da89e97aa

## EVT E7 / F_Fab / STATIC REVIEW

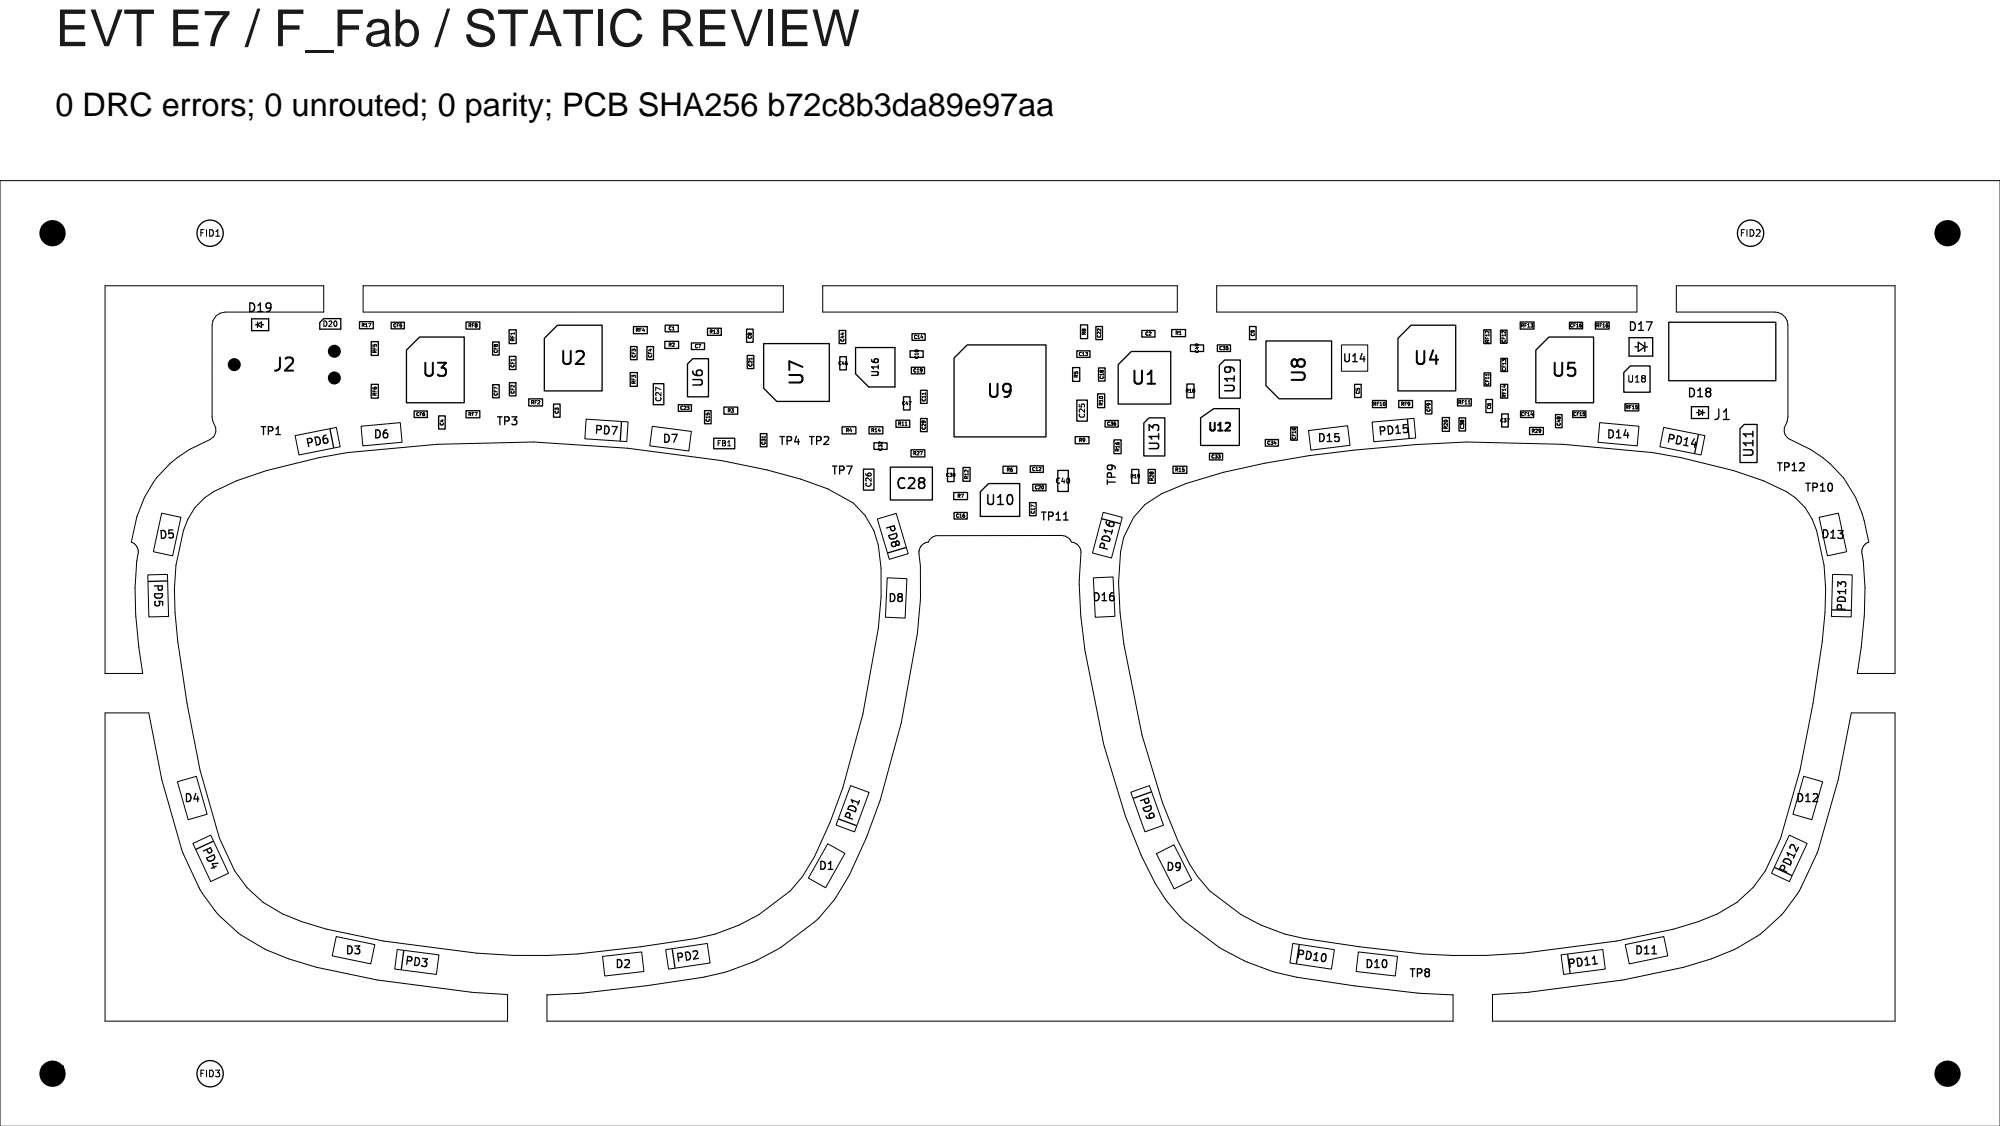
[picture p66: page 5]

0 DRC errors; 0 unrouted; 0 parity; PCB SHA256 b72c8b3da89e97aa

## EVT E7 / F_Silkscreen / STATIC REVIEW

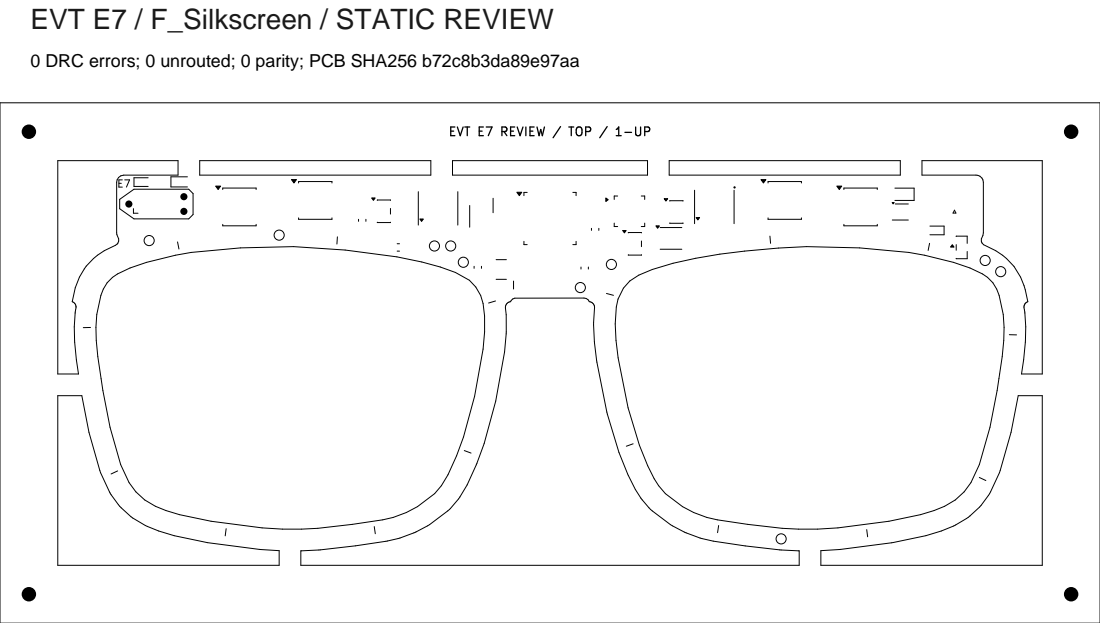
[picture p67: page 6]

0 DRC errors; 0 unrouted; 0 parity; PCB SHA256 b72c8b3da89e97aa

EVT E7 REVIEW / TOP / 1-UP
