noahzhy/cc_glasses/(list of files, drawings)

Other design files:
hardware/ir_glasses/EVT_E3/ir_glasses.dsn
hardware/ir_glasses/EVT_E3/routing_fresh.dsn
hardware/ir_glasses/EVT_E3/routing_keepouts.dsn
hardware/ir_glasses/ir_glasses_EVT_E7/review/pcb_facts.json
hardware/tools/route_fresh.dsn
