noahzhy/cc_glasses/hardware/ir_glasses/ir_glasses_EVT_E7/ir_glasses_EVT_E7.kicad_pcb

## KiCad design hardware/ir_glasses/ir_glasses_EVT_E7/ir_glasses_EVT_E7.kicad_pcb (2026-09-19)

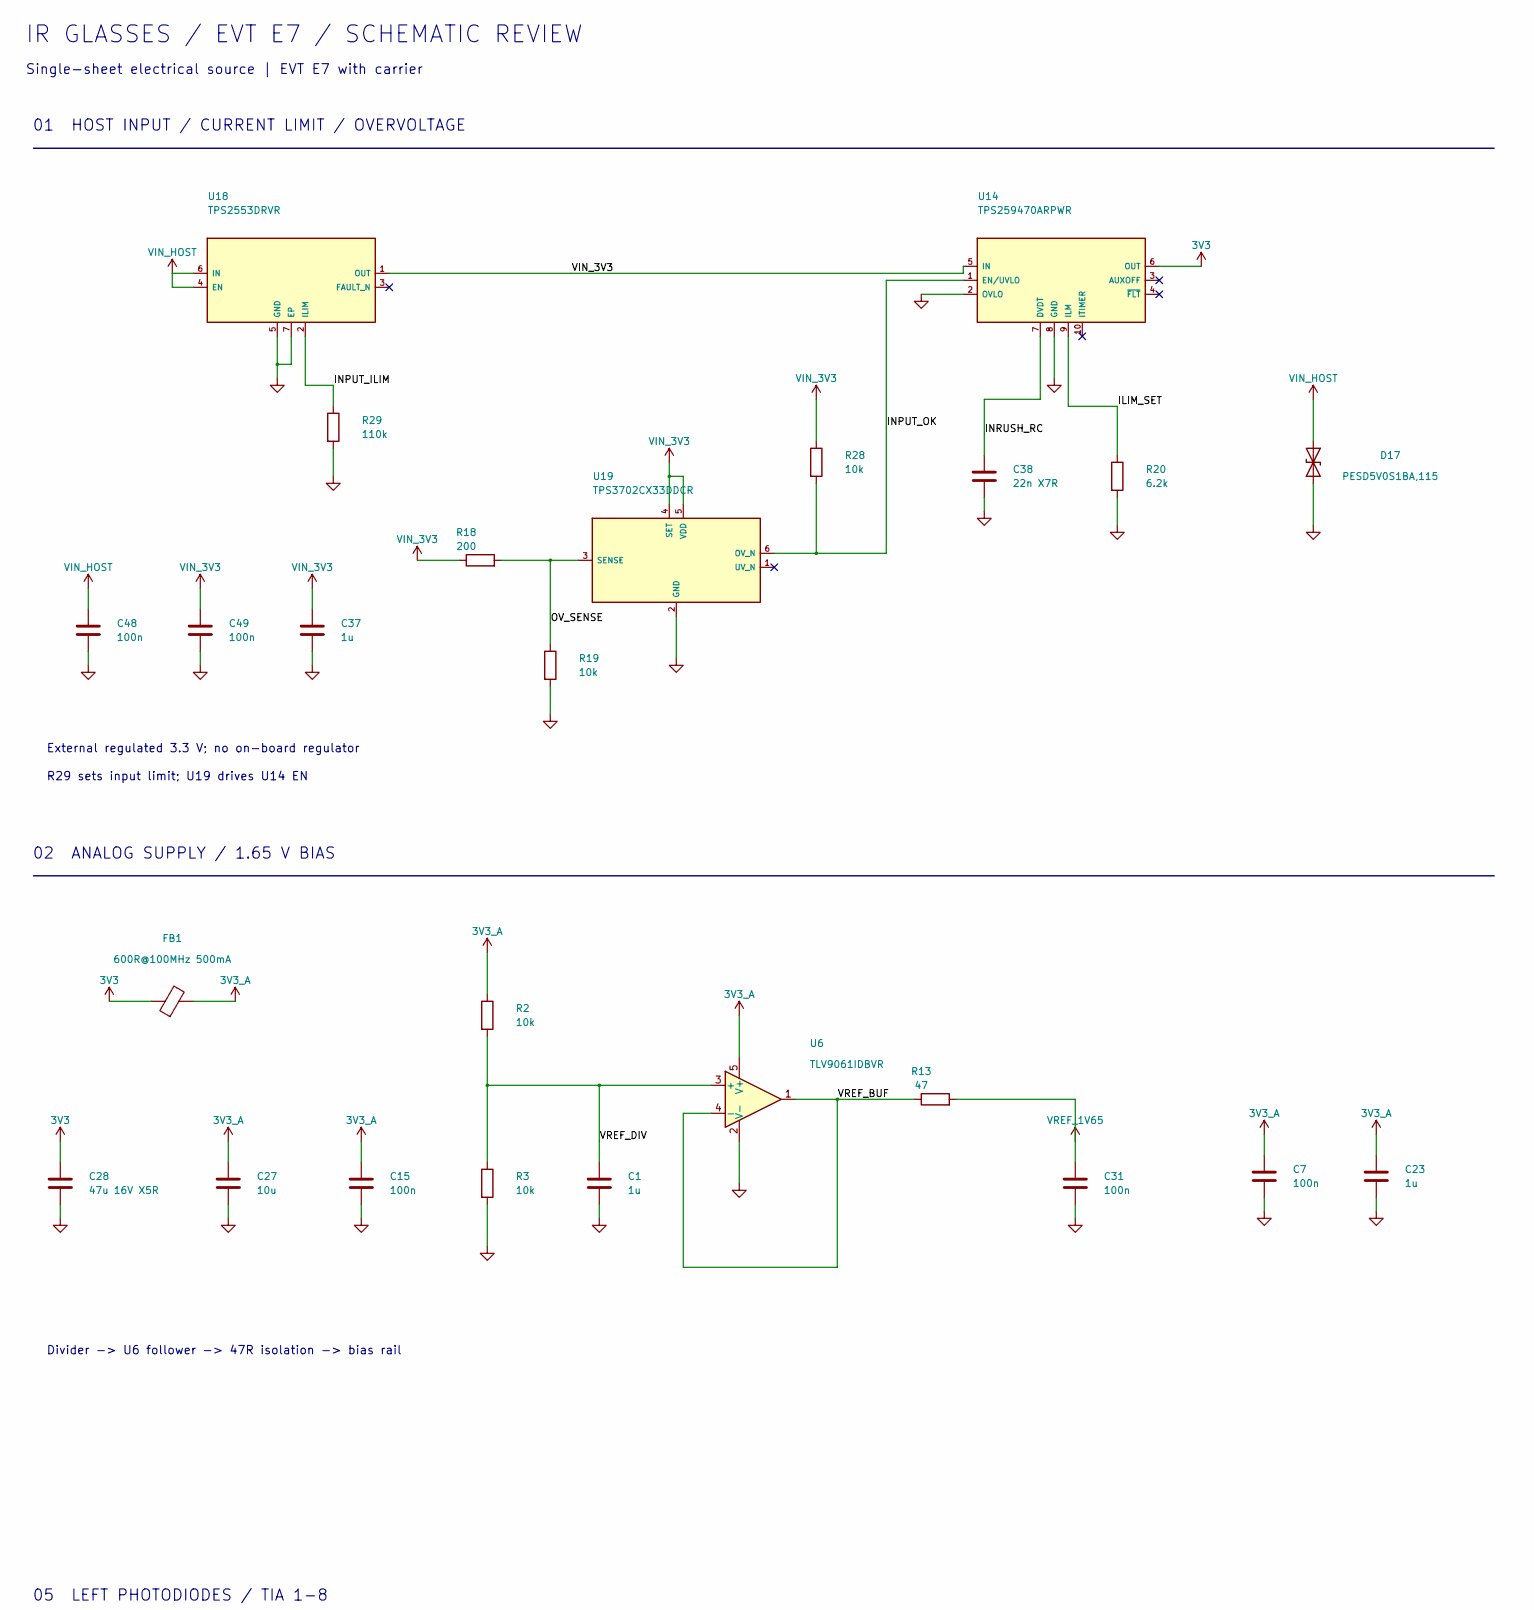
[picture p68: schematic ir_glasses_EVT_E7.kicad_sch, IR Glasses - single-sheet electrical review, part in row 1, column 1]

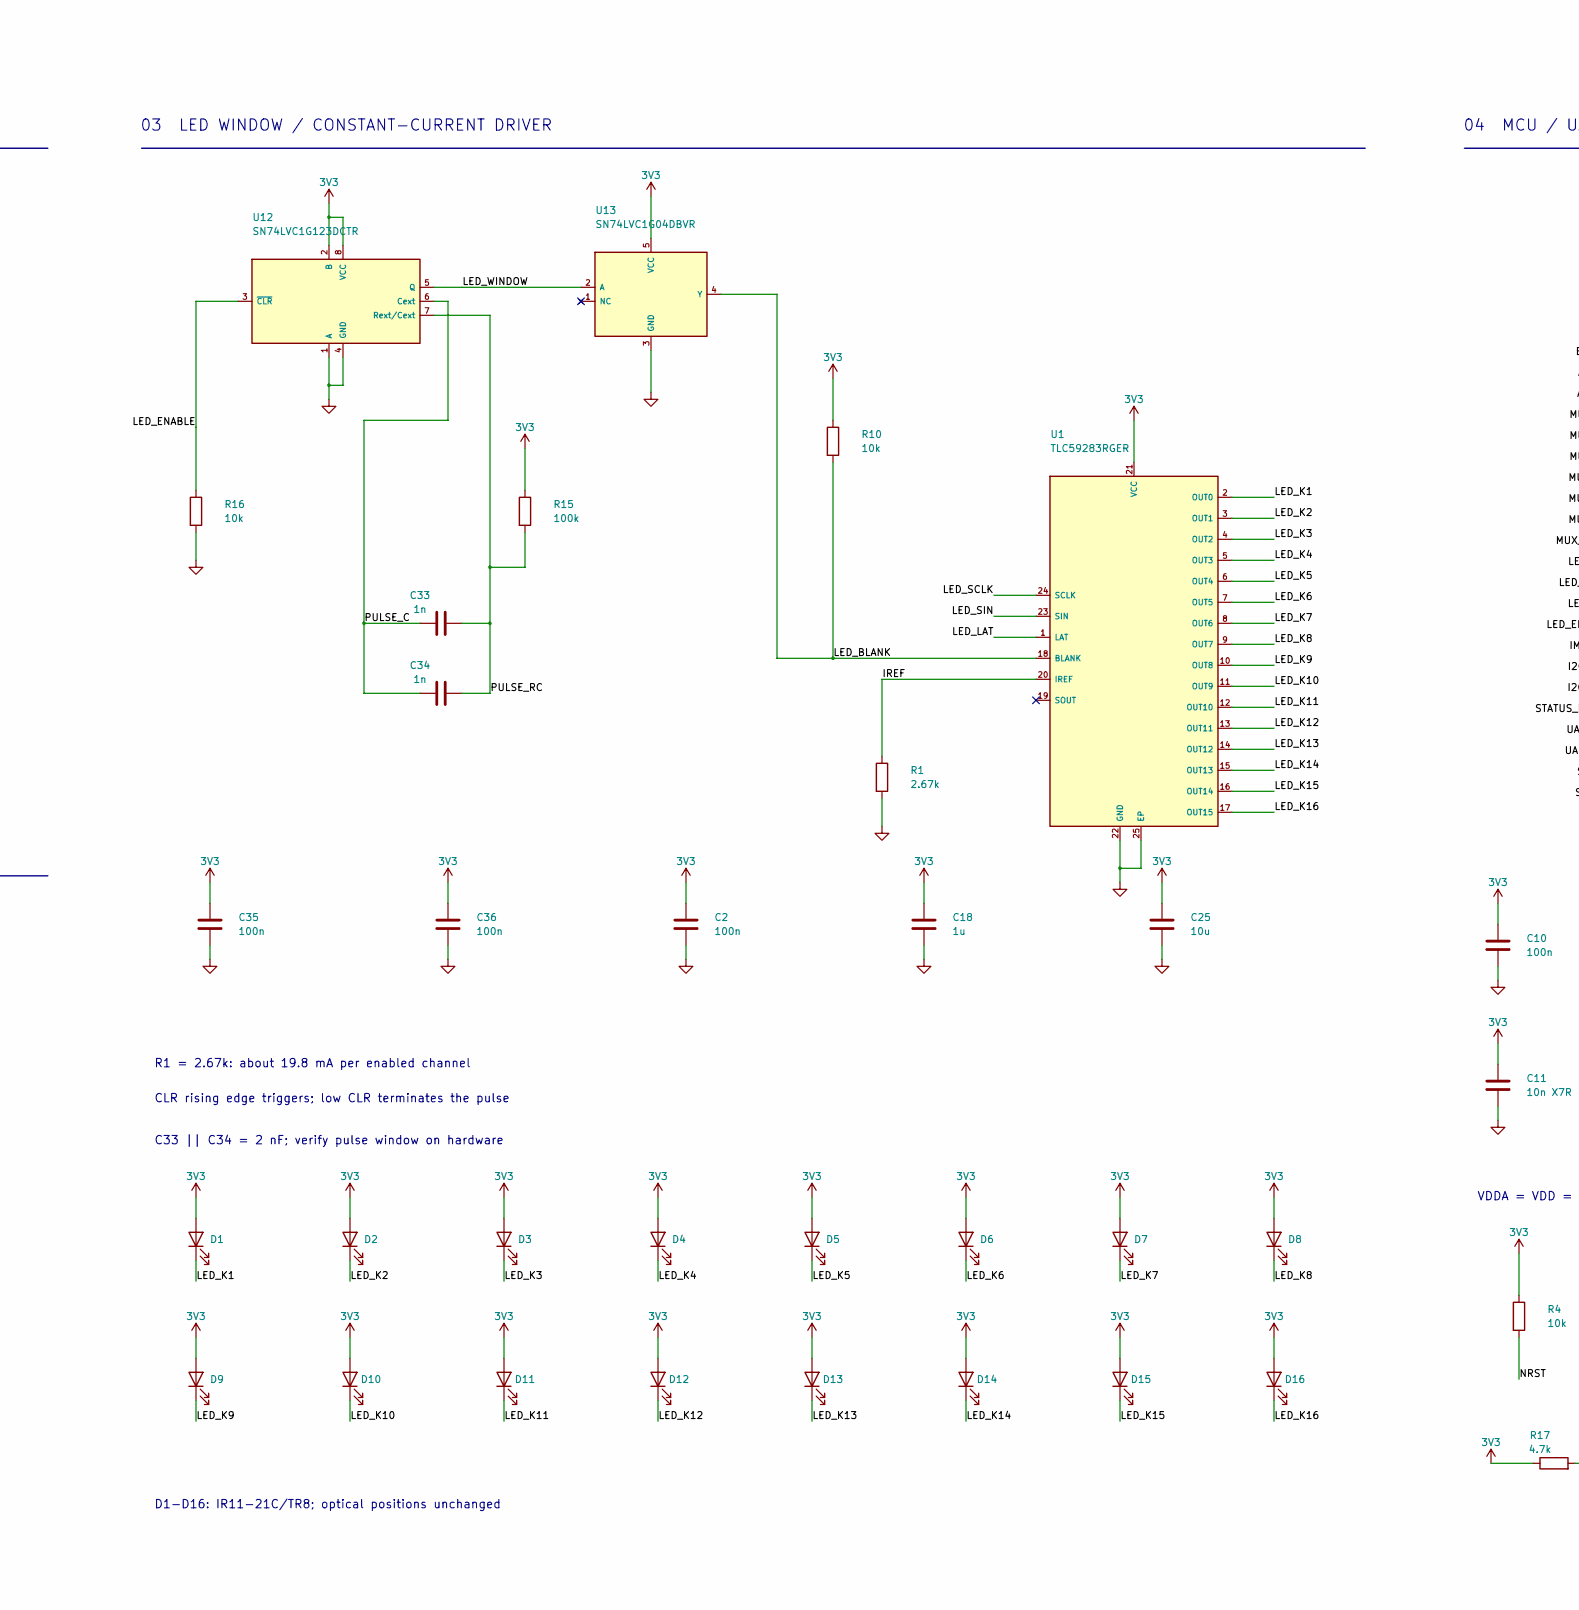
[picture p69: schematic ir_glasses_EVT_E7.kicad_sch, IR Glasses - single-sheet electrical review, part in row 1, column 2]

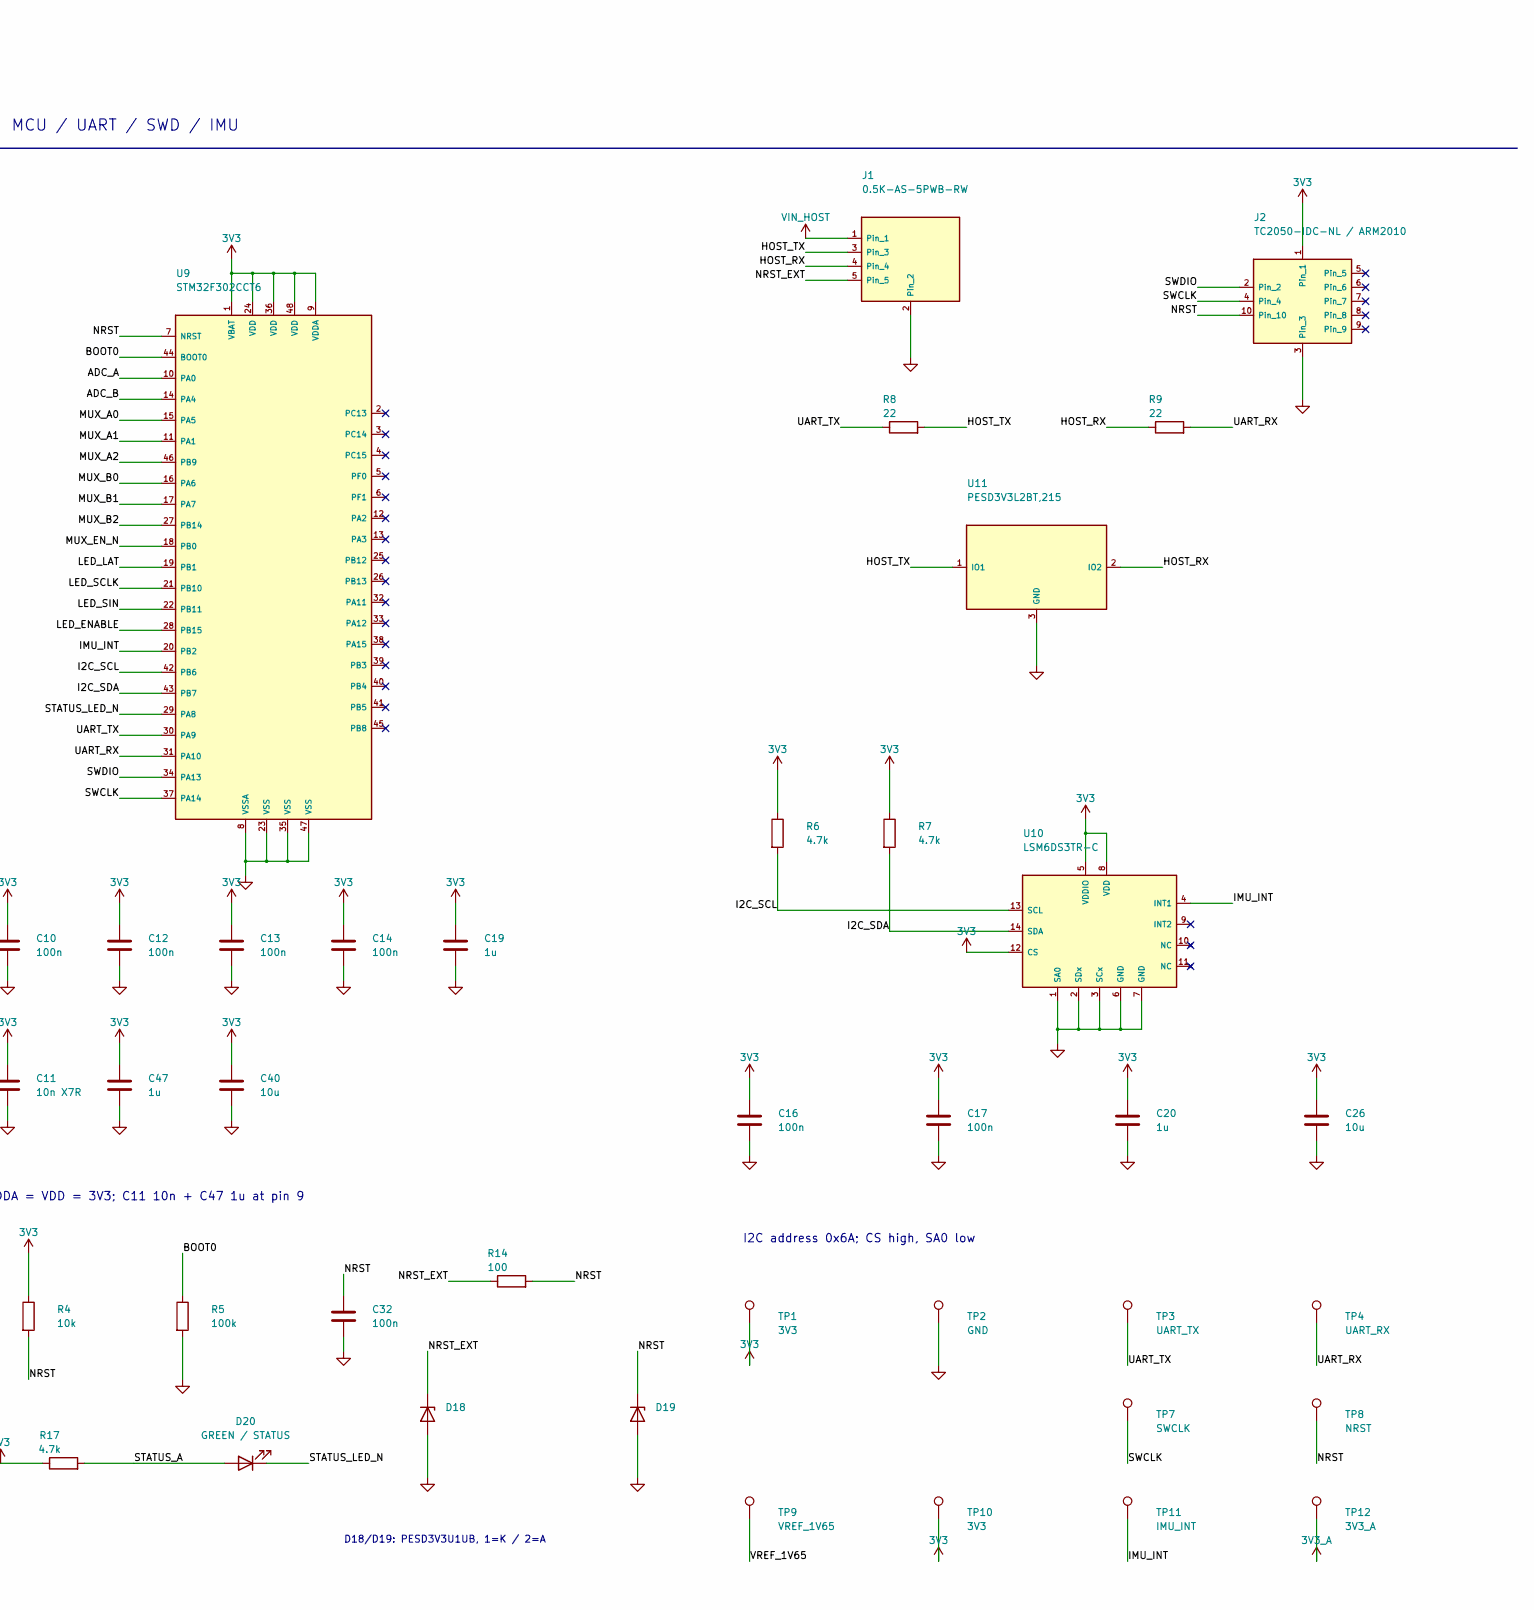
[picture p70: schematic ir_glasses_EVT_E7.kicad_sch, IR Glasses - single-sheet electrical review, part in row 1, column 3]

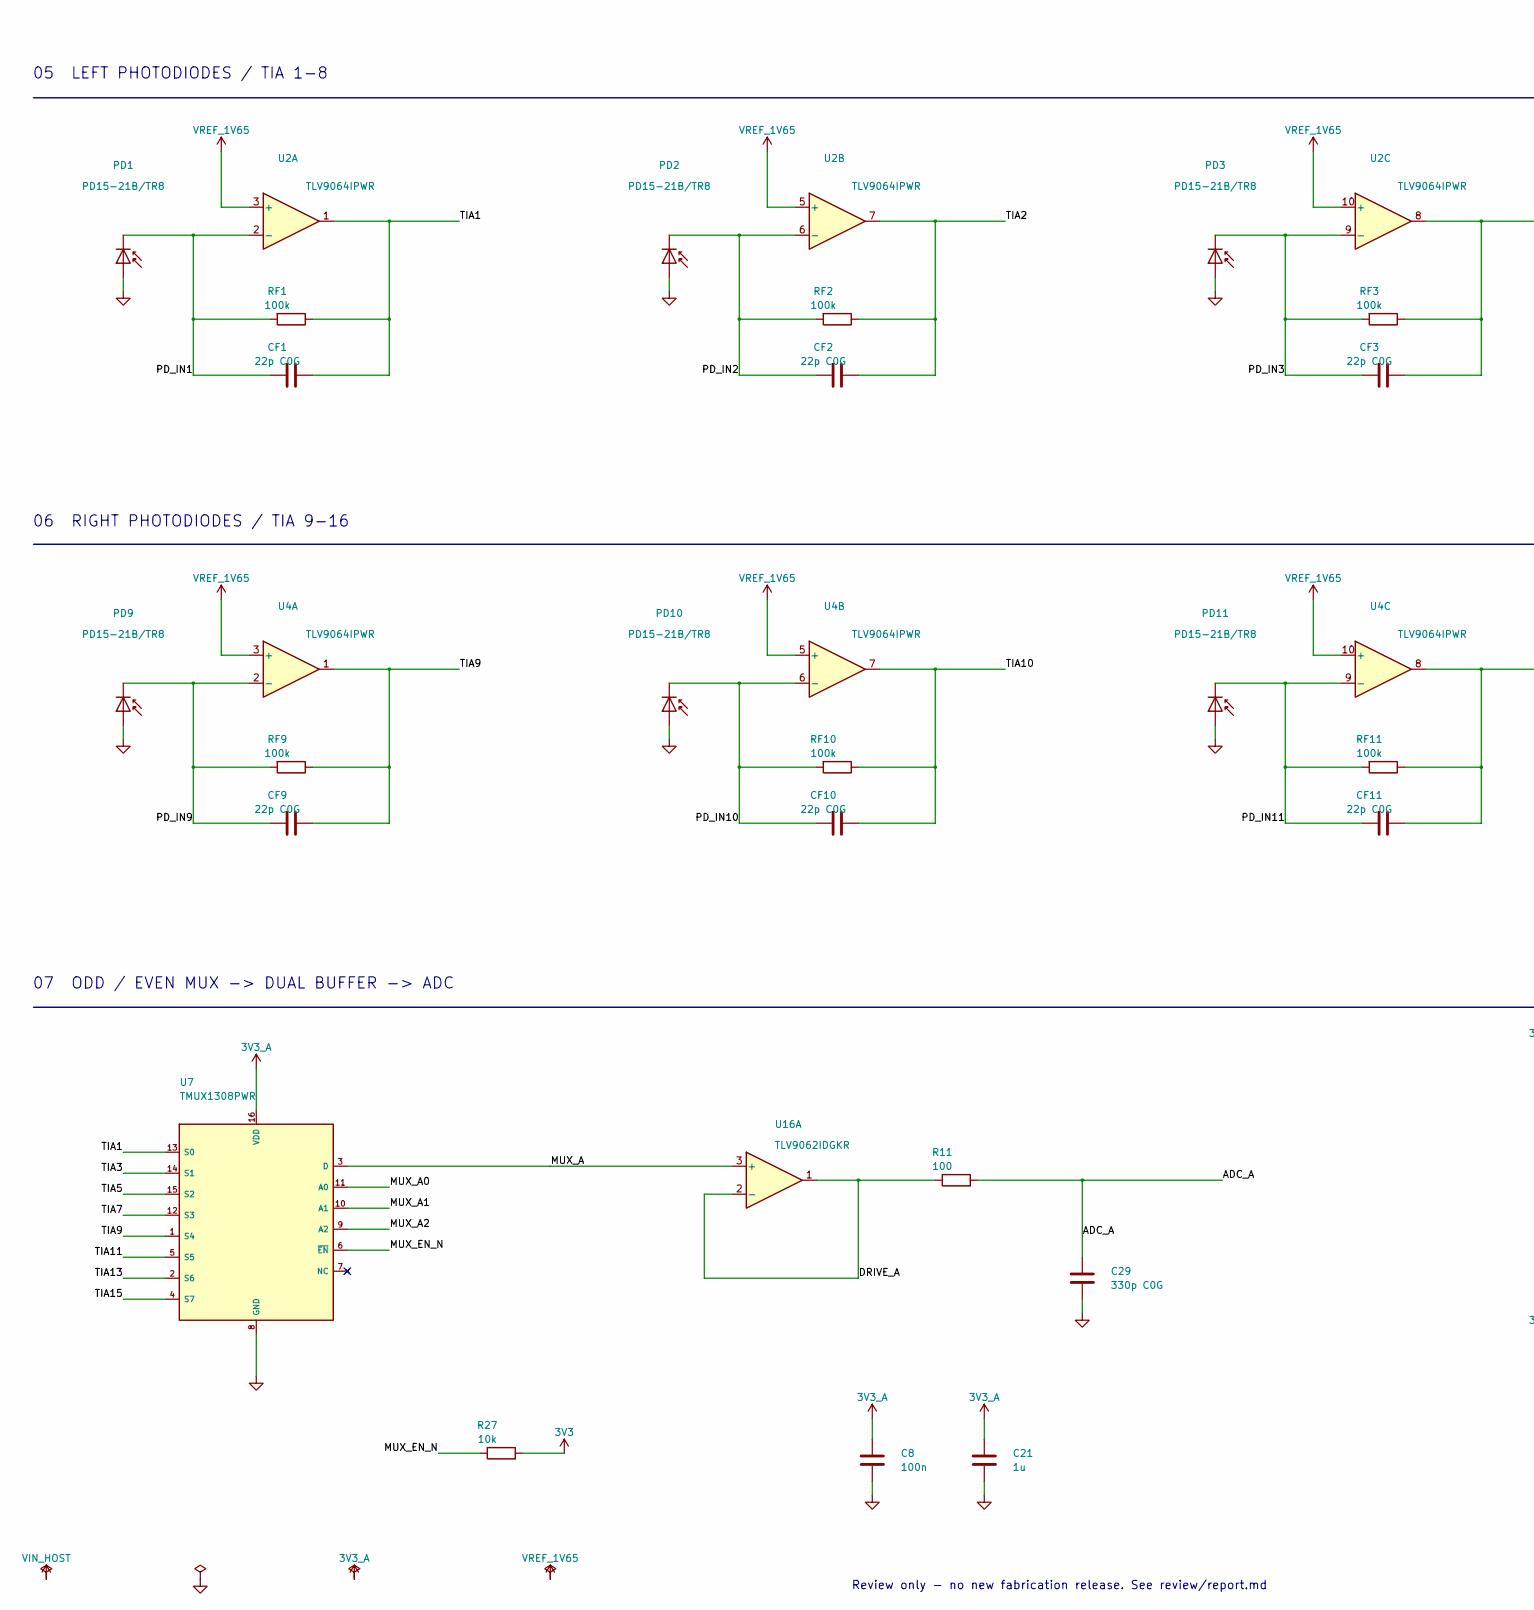
[picture p71: schematic ir_glasses_EVT_E7.kicad_sch, IR Glasses - single-sheet electrical review, part in row 2, column 1]

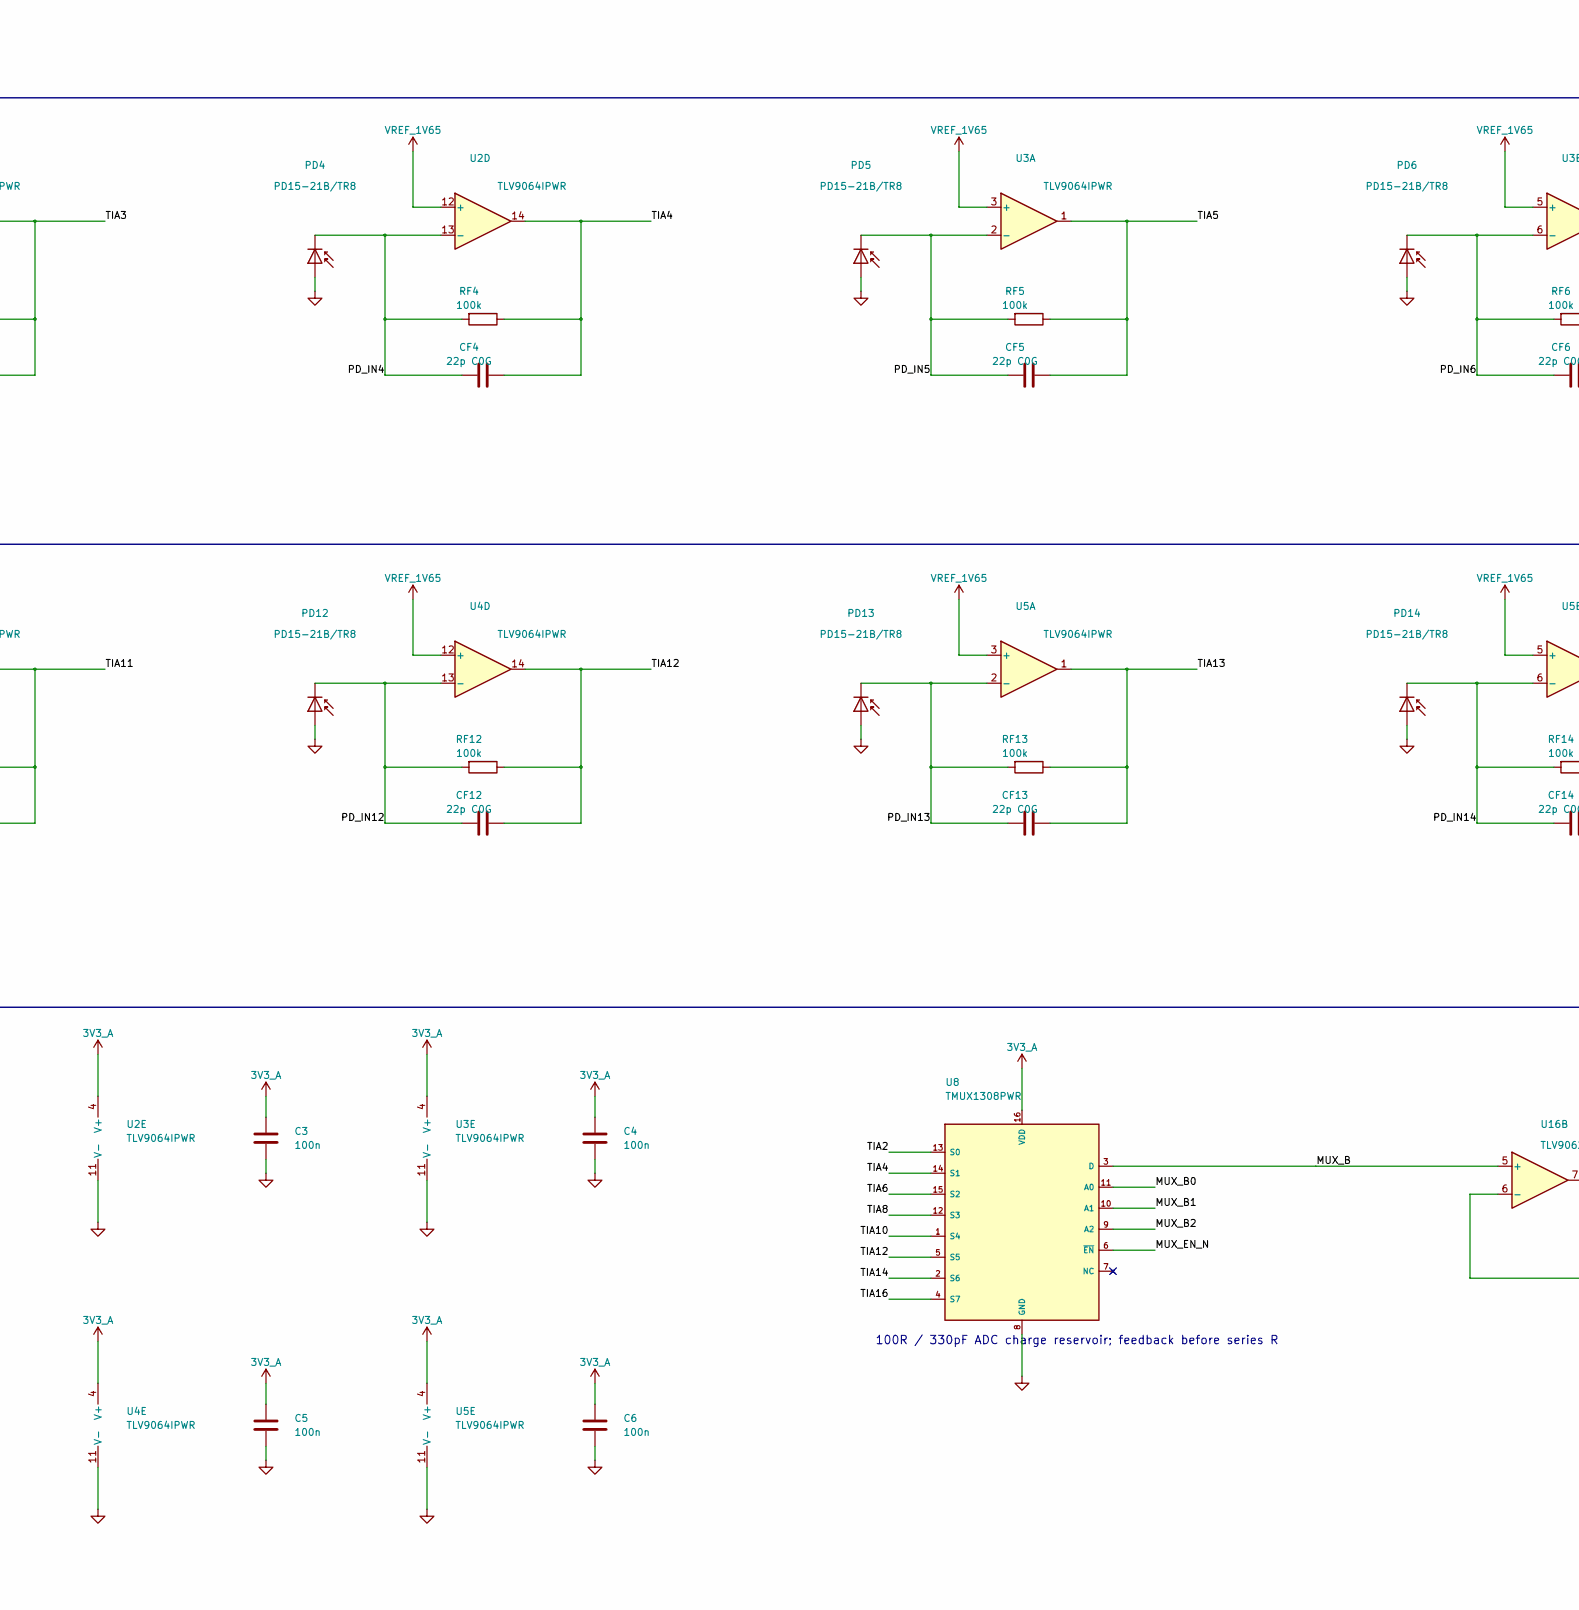
[picture p72: schematic ir_glasses_EVT_E7.kicad_sch, IR Glasses - single-sheet electrical review, part in row 2, column 2]

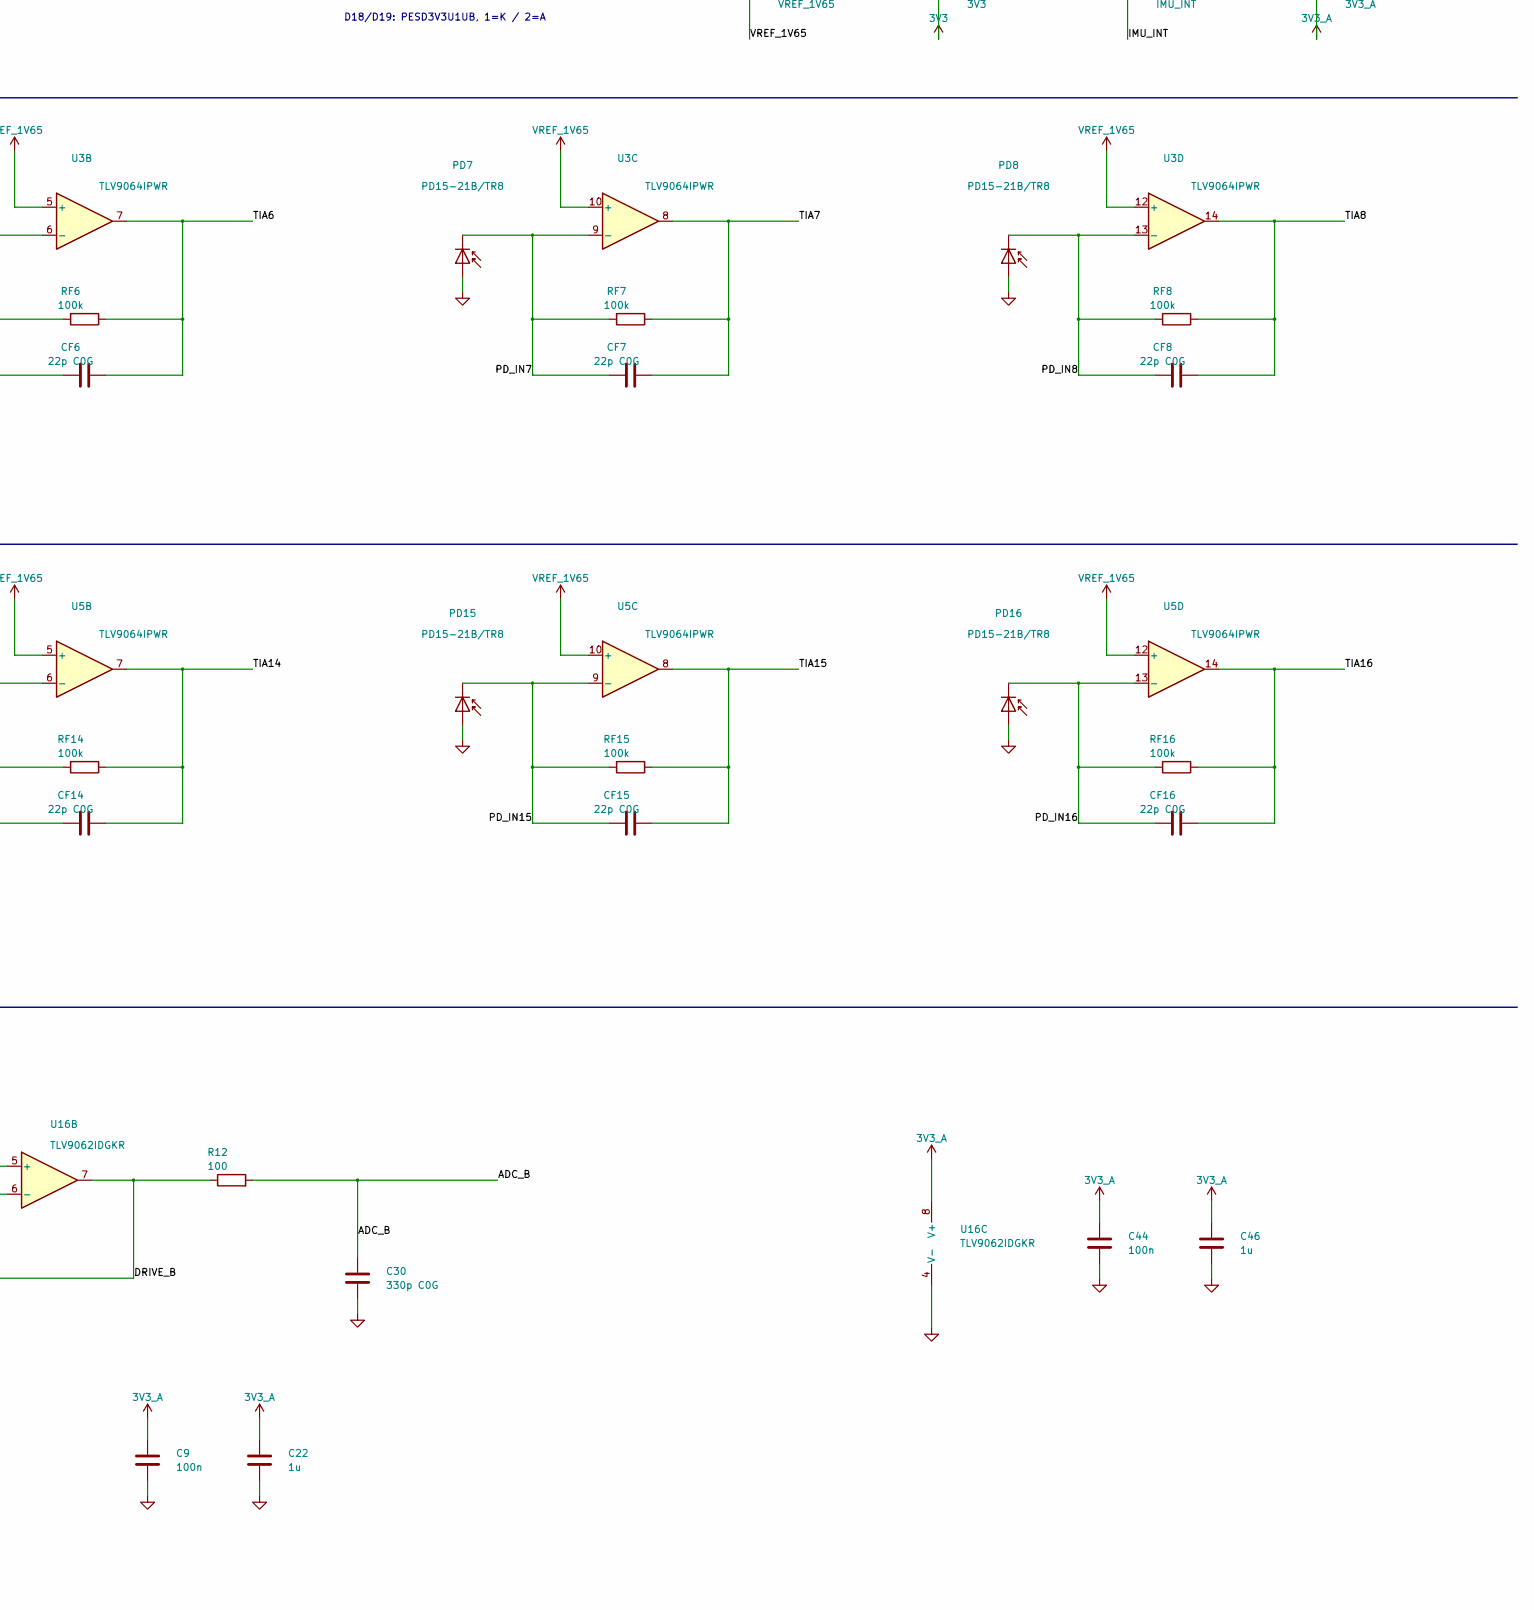
[picture p73: schematic ir_glasses_EVT_E7.kicad_sch, IR Glasses - single-sheet electrical review, part in row 2, column 3]

Parts:
C1, C18, C19, C20, C21, C22, C23, C37, C46, C47: 1u; 0402; MPN TCC0402X7R105K160AT; LCSC C49210445
C2, C3, C4, C5, C6, C7, C8, C9, C10, C12, C13, C14, C15, C16, C17, C31, C32, C35, C36, C44, C48, C49: 100n; 0402; MPN CL05B104KO5NNNC; LCSC C1525
C11: 10n X7R; 0402; MPN CL05B103KB5NNNC; LCSC C15195
C25, C26, C27, C40: 10u; 0603; MPN CL10A106KP8NNNC; LCSC C19702
C28: 47u 16V X5R; 1210; MPN CC1210KKX5R7BB476; LCSC C596320
C29, C30: 330p C0G; 0402; MPN GRM1555C1H331JA01D; LCSC C76965
C33, C34: 1n; 0402; MPN 0402CG102J500NT; LCSC C53547
C38: 22n X7R; 0402; MPN CL05B223KB5VPNC; LCSC C307335
CF1, CF2, CF3, CF4, CF5, CF6, CF7, CF8, CF9, CF10, CF11, CF12, CF13, CF14, CF15, CF16: 22p C0G; 0402; MPN 0402CG220J500NT; LCSC C1555
D1, D2, D3, D4, D5, D6, D7, D8, D9, D10, D11, D12, D13, D14, D15, D16: IR11-21C/TR8; 1206; MPN IR11-21C/TR8; LCSC C19269752
D17: PESD5V0S1BA,115; SOD-323; MPN PESD5V0S1BA,115; LCSC C19224
D18, D19: PESD3V3U1UB,115; SOD-523; MPN PESD3V3U1UB,115; LCSC C2443469
D20: GREEN / STATUS; 0603; MPN LTST-C190KGKT; LCSC C125094
FB1: 600R@100MHz 500mA; 0603; MPN BLM18AG601SN1D; LCSC C19330
J1: 0.5K-AS-5PWB-RW; GUOCONN_0.5K-AS-5PWB-RW; MPN 0.5K-AS-5PWB-RW; LCSC C51901197
J2: TC2050-IDC-NL / ARM2010; TC2050
PD1, PD2, PD3, PD4, PD5, PD6, PD7, PD8, PD9, PD10, PD11, PD12, PD13, PD14, PD15, PD16: PD15-21B/TR8; 1206; MPN PD15-21B/TR8; LCSC C2921391
R1: 2.67k; 0402; MPN ARG02FTC2671; LCSC C284464
R2, R3, R4, R10, R16, R19, R27, R28: 10k; 0402; MPN 0402WGF1002TCE; LCSC C25744
R5, R15: 100k; 0402; MPN 0402WGF1003TCE; LCSC C25741
R6, R7, R17: 4.7k; 0402; MPN 0402WGF4701TCE; LCSC C25900
R8, R9: 22; 0402; MPN 0402WGF220JTCE; LCSC C25092
R11, R12, R14: 100; 0402; MPN RC0402FR-07100RL; LCSC C106232
R13: 47; 0402; MPN 0402WGF470JTCE; LCSC C25118
R18: 200; 0402; MPN 0402WGF2000TCE; LCSC C25087
R20: 6.2k; 0402; MPN 0402WGF6201TCE; LCSC C25915
R29: 110k; 0402; MPN 0402WGF1103TCE; LCSC C25745
RF1, RF2, RF3, RF4, RF5, RF6, RF7, RF8, RF9, RF10, RF11, RF12, RF13, RF14, RF15, RF16: 100k; 0402; MPN 0402WGF1003TCE; LCSC C25741
TP1, TP10: 3V3; 1mm
TP2: GND; 1mm
TP3: UART_TX; 1mm
TP4: UART_RX; 1mm
TP7: SWCLK; 1mm
TP8: NRST; 1mm
TP9: VREF_1V65; 1mm
TP11: IMU_INT; 1mm
TP12: 3V3_A; 1mm
U1: TLC59283RGER; VQFN-24; MPN TLC59283RGER; LCSC C485815
U2, U3, U4, U5: TLV9064IPWR; TSSOP-14; MPN TLV9064IPWR; LCSC C779410
U6: TLV9061IDBVR; SOT-23-5; MPN TLV9061IDBVR; LCSC C398358
U7, U8: TMUX1308PWR; TSSOP-16; MPN TMUX1308PWR; LCSC C970231
U9: STM32F302CCT6; LQFP-48; MPN STM32F302CCT6; LCSC C262946
U10: LSM6DS3TR-C; LGA-14; MPN LSM6DS3TR-C; LCSC C967633
U11: PESD3V3L2BT,215; SOT-23; MPN PESD3V3L2BT,215; LCSC C55440
U12: SN74LVC1G123DCTR; SSOP-8; MPN SN74LVC1G123DCTR; LCSC C123302
U13: SN74LVC1G04DBVR; SOT-23-5; MPN SN74LVC1G04DBVR; LCSC C7827
U14: TPS259470ARPWR; VQFN-10-HR; MPN TPS259470ARPWR; LCSC C3662799
U16: TLV9062IDGKR; VSSOP-8_3x3mm_P0.65mm; MPN TLV9062IDGKR; LCSC C398356
U18: TPS2553DRVR; TPS2553_DRV0006; MPN TPS2553DRVR; LCSC C138719
U19: TPS3702CX33DDCR; TPS3702_DDC0006; MPN TPS3702CX33DDCR; LCSC C2068031

Connections:
3V3: C2.1, C10.1, C11.1, C12.1, C13.1, C14.1, C16.1, C17.1, C18.1, C19.1, C20.1, C25.1, C26.1, C28.1, C35.1, C36.1, C40.1, C47.1, D1.1 (A), D2.1 (A), D3.1 (A), D4.1 (A), D5.1 (A), D6.1 (A), D7.1 (A), D8.1 (A), D9.1 (A), D10.1 (A), D11.1 (A), D12.1 (A), D13.1 (A), D14.1 (A), D15.1 (A), D16.1 (A), FB1.1, J2.1, R4.1, R6.1, R7.1, R10.1, R15.1, R17.1, R27.2, TP1.1, TP10.1, U1.21 (VCC), U9.1 (VBAT), U9.9 (VDDA), U9.24 (VDD), U9.36 (VDD), U9.48 (VDD), U10.5 (VDDIO), U10.8 (VDD), U10.12 (CS), U12.2 (B), U12.8 (VCC), U13.5 (VCC), U14.6 (OUT)
3V3_A: C3.1, C4.1, C5.1, C6.1, C7.1, C8.1, C9.1, C15.1, C21.1, C22.1, C23.1, C27.1, C44.1, C46.1, FB1.2, R2.1, TP12.1, U2.4 (V+), U3.4 (V+), U4.4 (V+), U5.4 (V+), U6.5 (V+), U7.16 (VDD), U8.16 (VDD), U16.8 (V+)
/ADC_A: C29.1, R11.2, U9.10 (PA0)
/ADC_B: C30.1, R12.2, U9.14 (PA4)
/BOOT0: R5.1, U9.44 (BOOT0)
/DRIVE_A: R11.1, U16.1, U16.2 (-)
/DRIVE_B: R12.1, U16.6 (-), U16.7
/HOST_RX: J1.4, R9.1, U11.2 (IO2)
/HOST_TX: J1.3, R8.2, U11.1 (IO1)
/I2C_SCL: R6.2, U9.42 (PB6), U10.13 (SCL)
/I2C_SDA: R7.2, U9.43 (PB7), U10.14 (SDA)
/ILIM_SET: R20.1, U14.9 (ILM)
/IMU_INT: TP11.1, U9.20 (PB2), U10.4 (INT1)
/INPUT_ILIM: R29.1, U18.2 (ILIM)
/INPUT_OK: R28.2, U14.1 (EN/UVLO), U19.6 (OV_N)
/INRUSH_RC: C38.1, U14.7 (DVDT)
/IREF: R1.1, U1.20 (IREF)
/LED_BLANK: R10.2, U1.18 (BLANK), U13.4 (Y)
/LED_ENABLE: R16.1, U9.28 (PB15), U12.3 (~CLR)
/LED_K1: D1.2 (K), U1.2 (OUT0)
/LED_K2: D2.2 (K), U1.3 (OUT1)
/LED_K3: D3.2 (K), U1.4 (OUT2)
/LED_K4: D4.2 (K), U1.5 (OUT3)
/LED_K5: D5.2 (K), U1.6 (OUT4)
/LED_K6: D6.2 (K), U1.7 (OUT5)
/LED_K7: D7.2 (K), U1.8 (OUT6)
/LED_K8: D8.2 (K), U1.9 (OUT7)
/LED_K9: D9.2 (K), U1.10 (OUT8)
/LED_K10: D10.2 (K), U1.11 (OUT9)
/LED_K11: D11.2 (K), U1.12 (OUT10)
/LED_K12: D12.2 (K), U1.13 (OUT11)
/LED_K13: D13.2 (K), U1.14 (OUT12)
/LED_K14: D14.2 (K), U1.15 (OUT13)
/LED_K15: D15.2 (K), U1.16 (OUT14)
/LED_K16: D16.2 (K), U1.17 (OUT15)
/LED_LAT: U1.1 (LAT), U9.19 (PB1)
/LED_SCLK: U1.24 (SCLK), U9.21 (PB10)
/LED_SIN: U1.23 (SIN), U9.22 (PB11)
/LED_WINDOW: U12.5 (Q), U13.2 (A)
/MUX_A: U7.3 (D), U16.3 (+)
/MUX_A0: U7.11 (A0), U9.15 (PA5)
/MUX_A1: U7.10 (A1), U9.11 (PA1)
/MUX_A2: U7.9 (A2), U9.46 (PB9)
/MUX_B: U8.3 (D), U16.5 (+)
/MUX_B0: U8.11 (A0), U9.16 (PA6)
/MUX_B1: U8.10 (A1), U9.17 (PA7)
/MUX_B2: U8.9 (A2), U9.27 (PB14)
/MUX_EN_N: R27.1, U7.6 (~EN), U8.6 (~EN), U9.18 (PB0)
/NRST: C32.1, D19.1 (K), J2.10, R4.2, R14.2, TP8.1, U9.7 (NRST)
/NRST_EXT: D18.1 (K), J1.5, R14.1
/OV_SENSE: R18.2, R19.1, U19.3 (SENSE)
/PD_IN1: CF1.2, PD1.2 (K), RF1.2, U2.2 (-)
/PD_IN2: CF2.2, PD2.2 (K), RF2.2, U2.6 (-)
/PD_IN3: CF3.2, PD3.2 (K), RF3.2, U2.9 (-)
/PD_IN4: CF4.2, PD4.2 (K), RF4.2, U2.13 (-)
/PD_IN5: CF5.2, PD5.2 (K), RF5.2, U3.2 (-)
/PD_IN6: CF6.2, PD6.2 (K), RF6.2, U3.6 (-)
/PD_IN7: CF7.2, PD7.2 (K), RF7.2, U3.9 (-)
/PD_IN8: CF8.2, PD8.2 (K), RF8.2, U3.13 (-)
/PD_IN9: CF9.2, PD9.2 (K), RF9.2, U4.2 (-)
/PD_IN10: CF10.2, PD10.2 (K), RF10.2, U4.6 (-)
/PD_IN11: CF11.2, PD11.2 (K), RF11.2, U4.9 (-)
/PD_IN12: CF12.2, PD12.2 (K), RF12.2, U4.13 (-)
/PD_IN13: CF13.2, PD13.2 (K), RF13.2, U5.2 (-)
/PD_IN14: CF14.2, PD14.2 (K), RF14.2, U5.6 (-)
/PD_IN15: CF15.2, PD15.2 (K), RF15.2, U5.9 (-)
/PD_IN16: CF16.2, PD16.2 (K), RF16.2, U5.13 (-)
/PULSE_C: C33.1, C34.1, U12.6 (Cext)
/PULSE_RC: C33.2, C34.2, R15.2, U12.7 (Rext/Cext)
/STATUS_A: D20.2 (A), R17.2
/STATUS_LED_N: D20.1 (K), U9.29 (PA8)
/SWCLK: J2.4, TP7.1, U9.37 (PA14)
/SWDIO: J2.2, U9.34 (PA13)
/TIA1: CF1.1, RF1.1, U2.1, U7.13 (S0)
/TIA2: CF2.1, RF2.1, U2.7, U8.13 (S0)
/TIA3: CF3.1, RF3.1, U2.8, U7.14 (S1)
/TIA4: CF4.1, RF4.1, U2.14, U8.14 (S1)
/TIA5: CF5.1, RF5.1, U3.1, U7.15 (S2)
/TIA6: CF6.1, RF6.1, U3.7, U8.15 (S2)
/TIA7: CF7.1, RF7.1, U3.8, U7.12 (S3)
/TIA8: CF8.1, RF8.1, U3.14, U8.12 (S3)
/TIA9: CF9.1, RF9.1, U4.1, U7.1 (S4)
/TIA10: CF10.1, RF10.1, U4.7, U8.1 (S4)
/TIA11: CF11.1, RF11.1, U4.8, U7.5 (S5)
/TIA12: CF12.1, RF12.1, U4.14, U8.5 (S5)
/TIA13: CF13.1, RF13.1, U5.1, U7.2 (S6)
/TIA14: CF14.1, RF14.1, U5.7, U8.2 (S6)
/TIA15: CF15.1, RF15.1, U5.8, U7.4 (S7)
/TIA16: CF16.1, RF16.1, U5.14, U8.4 (S7)
/UART_RX: R9.2, TP4.1, U9.31 (PA10)
/UART_TX: R8.1, TP3.1, U9.30 (PA9)
/VREF_BUF: R13.1, U6.1, U6.4 (-)
/VREF_DIV: C1.1, R2.2, R3.1, U6.3 (+)
GND: C1.2, C2.2, C3.2, C4.2, C5.2, C6.2, C7.2, C8.2, C9.2, C10.2, C11.2, C12.2, C13.2, C14.2, C15.2, C16.2, C17.2, C18.2, C19.2, C20.2, C21.2, C22.2, C23.2, C25.2, C26.2, C27.2, C28.2, C29.2, C30.2, C31.2, C32.2, C35.2, C36.2, C37.2, C38.2, C40.2, C44.2, C46.2, C47.2, C48.2, C49.2, D17.2 (A2), D18.2 (A), D19.2 (A), J1.2, J2.3, PD1.1 (A), PD2.1 (A), PD3.1 (A), PD4.1 (A), PD5.1 (A), PD6.1 (A), PD7.1 (A), PD8.1 (A), PD9.1 (A), PD10.1 (A), PD11.1 (A), PD12.1 (A), PD13.1 (A), PD14.1 (A), PD15.1 (A), PD16.1 (A), R1.2, R3.2, R5.2, R16.2, R19.2, R20.2, R29.2, TP2.1, U1.22 (GND), U1.25 (EP), U2.11 (V-), U3.11 (V-), U4.11 (V-), U5.11 (V-), U6.2 (V-), U7.8 (GND), U8.8 (GND), U9.8 (VSSA), U9.23 (VSS), U9.35 (VSS), U9.47 (VSS), U10.1 (SA0), U10.2 (SDx), U10.3 (SCx), U10.6 (GND), U10.7 (GND), U11.3 (GND), U12.1 (A), U12.4 (GND), U13.3 (GND), U14.2 (OVLO), U14.8 (GND), U16.4 (V-), U18.5 (GND), U18.7 (EP), U19.2 (GND)
VIN_3V3: C37.1, C49.1, R18.1, R28.1, U14.5 (IN), U18.1 (OUT), U19.4 (SET), U19.5 (VDD)
VIN_HOST: C48.1, D17.1 (A1), J1.1, U18.4 (EN), U18.6 (IN)
VREF_1V65: C31.1, R13.2, TP9.1, U2.3 (+), U2.5 (+), U2.10 (+), U2.12 (+), U3.3 (+), U3.5 (+), U3.10 (+), U3.12 (+), U4.3 (+), U4.5 (+), U4.10 (+), U4.12 (+), U5.3 (+), U5.5 (+), U5.10 (+), U5.12 (+)

Notes on the sheet:
IR GLASSES / EVT E7 / SCHEMATIC REVIEW
Single-sheet electrical source | EVT E7 with carrier
01 HOST INPUT / CURRENT LIMIT / OVERVOLTAGE
External regulated 3.3 V; no on-board regulator
R29 sets input limit; U19 drives U14 EN
02 ANALOG SUPPLY / 1.65 V BIAS
Divider -> U6 follower -> 47R isolation -> bias rail
03 LED WINDOW / CONSTANT-CURRENT DRIVER
R1 = 2.67k: about 19.8 mA per enabled channel
CLR rising edge triggers; low CLR terminates the pulse
C33 || C34 = 2 nF; verify pulse window on hardware
D1-D16: IR11-21C/TR8; optical positions unchanged
04 MCU / UART / SWD / IMU
VDDA = VDD = 3V3; C11 10n + C47 1u at pin 9
D18/D19: PESD3V3U1UB, 1=K / 2=A
I2C address 0x6A; CS high, SA0 low
05 LEFT PHOTODIODES / TIA 1-8
06 RIGHT PHOTODIODES / TIA 9-16
07 ODD / EVEN MUX -> DUAL BUFFER -> ADC
100R / 330pF ADC charge reservoir; feedback before series R
Review only - no new fabrication release. See review/report.md

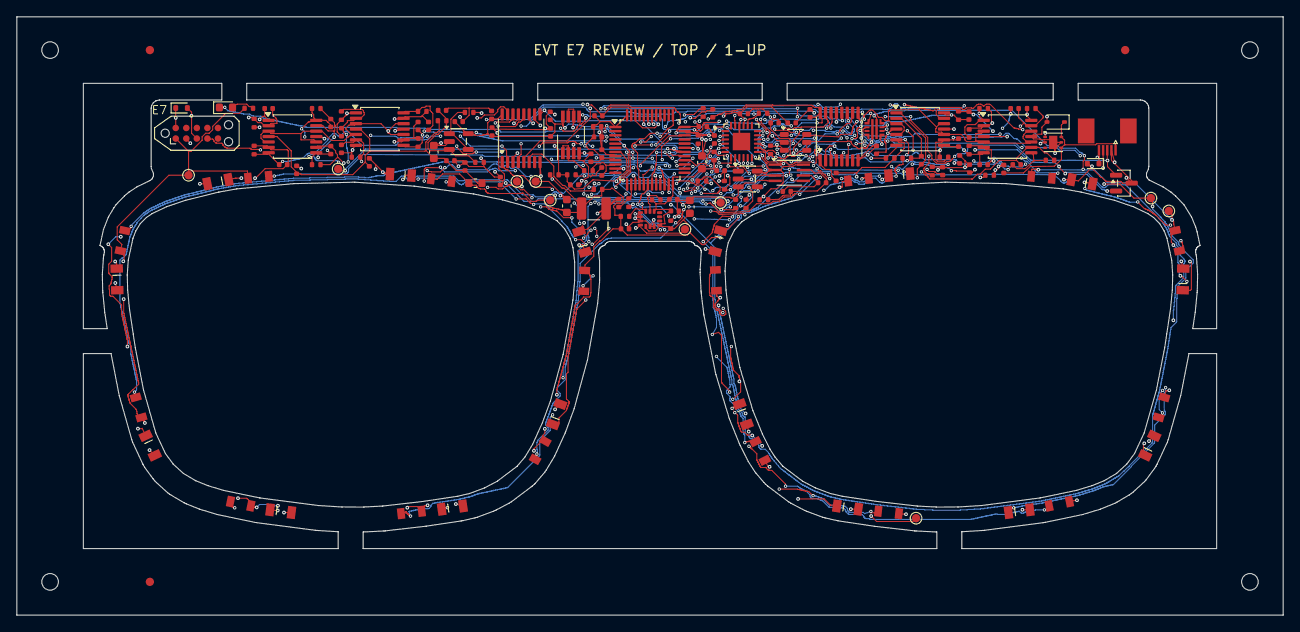
[picture p74: board ir_glasses_EVT_E7.kicad_pcb from above]

Board: 4 copper layers, 152.3 x 72.0 mm, 171 parts (0 on the bottom side), 97 nets.

Other parts of the board:
FID1, FID2, FID3: Fiducial_1mm_Mask2mm
H1, H2, H3, H4: MountingHole_2mm
