noahzhy/cc_glasses/(commit log)

2026-09-05 init: first commit
    [3d_model.3mf, 3d_model.blend, 3d_model_bkup.blend]
2026-09-07 feat: add pcb design
    [3d_model.blend, TE_1734839-5_aligned.step, TE_2492111-5_aligned.step, bom.csv, bom_frozen_2pcs.csv, bom_jlc_import.csv, bom_smt_all_122.csv, c-1734839-5-c-3d.stp]
2026-09-08 feat: add led for testing
    [C_0402_1005Metric.step, C_0603_1608Metric.step, C_1210_3225Metric.step, D_SOD-323.step, D_SOD-523.step, LED_0603_1608Metric.step, LGA-14_3x2.5mm_P0.5mm_LayoutBorder3x4y.step, LQFP-48_7x7mm_P0.5mm.step]
2026-09-08 update: evt4
    [BOM.csv, C_0402_1005Metric.step, C_0603_1608Metric.step, C_1210_3225Metric.step, D_SOD-323.step, D_SOD-523.step, EVT_E3__ir_glasses.dsn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]
2026-09-11 rm: useless files
    [BOM.csv, C_0402_1005Metric.step, C_0603_1608Metric.step, C_1210_3225Metric.step, D_SOD-323.step, D_SOD-523.step, EVT_E3__ir_glasses.dsn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]
2026-09-15 add: JLC_bom
    [bom.xlsx]
2026-09-17 feat: change some chips
    [C_0402_1005Metric.step, C_0603_1608Metric.step, C_1210_3225Metric.step, D_SOD-323.step, D_SOD-523.step, LED_0603_1608Metric.step, LGA-14_3x2.5mm_P0.5mm_LayoutBorder3x4y.step, LQFP-48_7x7mm_P0.5mm.step]
2026-09-18 feat: change mcu to add 2 adc
    [C_0402_1005Metric.step, C_0603_1608Metric.step, C_1210_3225Metric.step, D_SOD-323.step, D_SOD-523.step, LED_0603_1608Metric.step, LGA-14_3x2.5mm_P0.5mm_LayoutBorder3x4y.step, LQFP-48_7x7mm_P0.5mm.step]
2026-09-19 feat: E7
    [BOM.csv, BOM_JLC.csv, BOM_before.csv, BOM_采购汇总.csv, C_0402_1005Metric.step, C_0603_1608Metric.step, C_1210_3225Metric.step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]
