noahzhy/cc_glasses/(notices)

Notices in the files:
hardware/ir_glasses/ir_glasses_EVT_E7/models/LED_0603_1608Metric.step:
Copyright (C) 2018, kicad StepUp
This work is licensed under the [Creative Commons CC-BY-SA 4.0 License](https://creativecommons.org/licenses/by-sa/4.0/legalcode),
with the following exception:
To the extent that the creation of electronic designs that use 'Licensed Material' can be considered to be 'Adapted Material',
You are free to use the library data in your own projects without the obligation to share your project files under this or any other license agreement.
hardware/ir_glasses/ir_glasses_EVT_E7/models/C_0402_1005Metric.step:
Copyright (C) 2017, kicad StepUp
hardware/ir_glasses/ir_glasses_EVT_E7/models/WSON-6_1.5x1.5mm_P0.5mm.step:
This program is free software: you can redistribute it and/or modify
it under the terms of the GNU General Public License as published by
the Free Software Foundation, either version 3 of the License, or
any later version.
itself might be covered by the GNU General Public License.
hardware/ir_glasses/ir_glasses_EVT_E7/models/WSON-6-1EP_2x2mm_P0.65mm_EP1x1.6mm.step:
Copyright (C) 2020, kicad StepUp
hardware/ir_glasses/ir_glasses_EVT_E7/models/Texas_RGE0024C_VQFN-24-1EP_4x4mm_P0.5mm_EP2.1x2.1mm.step:
Copyright (C) 2024, KiCAD
This work is licensed under the
[Creative Commons CC-BY-SA 4.0 License](https://creativecommons.org/licenses/by-sa/4.0/legalcode),
project files under this or any other license agreement. However, if you wish to distribute
hardware/ir_glasses/ir_glasses_EVT_E7/models/SOT-23.step:
Copyright (C) 2025, KiCAD
